equinoxorg/ekoHub/README.md

ekoHub
======

Main repository for all the energy kiosk observer (eko) related projects since 2012
