equinoxorg/ekoHub/eko-hardware-designs/README.md

Energy Kiosk Observer Hardware Schematics
=========================================

This project includes hardware schematics for the Energy Kiosk Observer datalogging system for e.quinox (www.e.quinox.org).

Cadsoft EAGLE is the tool of choice when designing PCBs, although some designs are being moved to RS DesignSpark.

Contents
--------

The following designs are included in this repository

* [AC Sensors](http://e.quinox.org/wiki/Datalogger:AC_Sensors): Isolated Power Sensing for 230VAC lines rated at 15A~.
* [Atmospheric](http://e.quinox.org/wiki/Datalogger:Atmospheric_Sensors): Light, Temperature and Humidity Sensing Package.
* [DC Sensor Solar](http://e.quinox.org/wiki/Datalogger:DC_Sensors): A 3x current, 1x voltage sensor package for power measurements on parallel connected solar panels.
* [DC Sensor](http://e.quinox.org/wiki/Datalogger:DC_Sensors): A 1x current, 1x voltage DC power sensor prototype rated at 30A~.
* [EKO Base](http://e.quinox.org/wiki/Datalogger:Mainboard): The Datalogger Mainboard with Network connectors and GPRS/3G modem.
* [Panelised]: Panelised designs for distribution to fabricator.
* [RS232_Barcode_Interface](http://e.quinox.org/wiki/Datalogger:Barcode_Scanner): An interface to a RS232 barcode scanner. Built for use with the SureElectronics PIC24F starter kit.
* [StorageBat_PSU](http://e.quinox.org/wiki/Datalogger:Battery_Sensors): A 1x voltage sensor for measurement of battery voltages.
* [Test_RS485](http://e.quinox.org/wiki/Datalogger:Test_Tools): A FTDI UM232 to RS485 adaptor utilising a SP483E line driver.
* [ekobbr2](http://e.quinox.org/wiki/Datalogger:Baseboard): PIC24F based sensor baseboard design.

Notes
-----

Currently the BoMs for these designs are not included in the repository. Order summaries are available on docs.ekohub.org or through the technical team wiki.
