equinoxorg/ekoHub/2012-2013/README.MD

Contents

Hardware: All circuit schematics and PCB designs, datasheets
Software: The MBED code and python code for the Google App Engine (GAE)
Documentation and Reports: Technical documents which help in the understanding of the system
