equinoxorg/ekoHub/eko-hardware-designs/network_boards/xbee-adapter/README.md

XBEE Breakout Board
===================

Holger Graef and Alex Stott

Breakout board for XBee Pro to EKO hardware. Includes association LED.
