equinoxorg/ekoHub/2012-2013/Hardware/PCB/DS3231 breakout/Board Layout.png

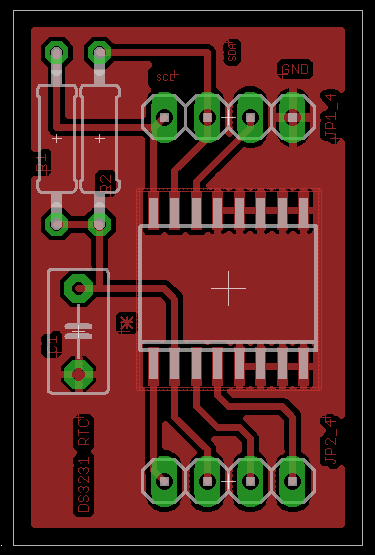
2012-2013/Hardware/PCB/DS3231 breakout/Board Layout.png
