equinoxorg/ekoHub/2013-2014/Documents/Inventory.xlsx

Date Modified: 27/4/2014
Component | Qty
Vodafone K3770 Modem | 2
CR2032 Panasonic Battery | 1
Tact Momentary Switch | 13
USB A Socket | 3
SD Card Socket | 2
AD7993 | 2
ACS712 | 2
SD Cards 2GB | 2
PCB Headers | 200
RED LED 5MM | 3
GREEN LED 5MM | 1
SD103 DIODES | 7
NMOS BS170 | 2
PMOS IRFU9024NPBF | 1
IL300 | 2
MCP604 | 2
MCP601 | 18
2way MOLEX Socket Crimps | 85
4way MOLEX Socket Crimps | 20
MYRAA Transformer | 1
MOLEX 2way Socket | 9
MOLEX 2way Crimp Housing | 12
MOLEX 4 way Socket | 9
MOLEX 4 way Crimp Housing | 10
