equinoxorg/ekoHub/2013-2014/Hardware/Component Values.xlsx

Sheet: AC Voltage
Component | Value | Notes | Component | Quantity | Unit Price | Total
R1 | 56K | Pot.Divider at input (series) | Transformer | 1 | £2.83 | £2.83
R2 | 10K | Pot.Divider at input (shunt) | MCP601 OpAmp | 3 | £0.35 | £1.05 | Cost per Sensor | 3.88
R3 | 5.1K | Pot. Divider for biasing (series) | SD103 | 2 | £0.00 | £0.00 | Number of Sensors | 1
R4 | 5.1K | Pot. Divider for biasing (shunt) |  |  | £0.00 | £0.00 | Total Cost | 3.88
R5 | 20k |  |  |  | £0.00 | £0.00
R6 | 5.1K |  |  |  | £0.00 | £0.00
R7 | 100k | Part of LPF |  |  | £0.00 | £0.00
R8 | 500 | Current Limiting Resistor |  |  | £0.00 | £0.00
C1 | 100μ | Electrolytic |  |  | £0.00 | £0.00
C2 | 22nF | Ceramic (Part of LPF) |  |  | £0.00 | £0.00
 |  |  |  |  | £0.00 | £0.00
 | 100nF | All other capacitors are decoupling capacitors |  |  | £0.00 | £0.00
 |  |  |  |  | £0.00 | £0.00

Sheet: DC Voltage
Component | Value | Notes | Component | Quantity | Unit Price | Total
 |  |  |  |  |  |  | Cost per Sensor | 0
 |  |  |  |  |  |  | Number of Sensors | 1
 |  |  |  |  |  |  | Total Cost | 0

Sheet: Current
Component | Value | Notes | Component | Quantity | Unit Price | Total
R1 | 1k |  | ACS712 | 1
R2 | 1k |  | MCP601 | 2 |  |  | Cost per Sensor | 0
R3 | 1k |  |  |  |  |  | Number of Sensors | 1
R4 | 1.5k |  |  |  |  |  | Total Cost | 0
R5 | 2k
R6 | 1k
C1 | 1n
C2 | 100n

Sheet: Main Board
Component | Value | Notes | Component | Quantity | Unit Price | Total
 |  |  |  |  |  |  | Cost per Sensor | 0
 |  |  |  |  |  |  | Number of Sensors | 1
 |  |  |  |  |  |  | Total Cost | 0
