equinoxorg/ekoHub/2013-2014/Documents/Datalogging Finances.xlsx

Sheet: Sheet1
Date | Company | Order Code | Description | Unit Price | Quantity | Total Cost
2013-10-30 | Farnell | 1761179 | MBED LCP1768 | £41.38 | 2 | £82.76
2013-10-30 | Farnell | 1852038 | OPAMP MCP601 | £0.35 | 15 | £5.25
2013-10-30 | Farnell | 1329624RL | ACS712 - 20A | £3.23 | 3 | £9.69
2013-10-30 | Farnell | 1098454 | 40Way PCB Breakaway Header 2.54mm Pitch | £1.78 | 2 | £3.56
2013-10-30 | Farnell | 1078309 | ADC - AD7993 Part 0 | £4.07 | 3 | £12.21
2013-11-01 | Farnell | 1298246 | CR2032 Panasonic Battery | £1.10 | 3 | £3.30
2013-11-01 | Farnell | 2310212 | USB A Socket | £1.20 | 3 | £3.60
2013-11-01 | Farnell | 2293708 | SD Card Socket | £1.58 | 3 | £4.74
2013-11-01 | Farnell | 1204967 | TRACO Isolated Switching Regulator | £11.75 | 1 | £11.75
2013-11-01 | Farnell | 8650101 | PMOS IRFU924NPBF | £0.58 | 3 | £1.74
2013-11-01 | Farnell | 1017687 | NMOS BS170 | £0.23 | 3 | £0.69
2013-11-01 | Farnell | 1612341 | SD103 Schotky Diode | £0.08 | 5 | £0.42
2013-11-01 | Farnell | 1689047 | MYRAA 240:6V Transformer | £2.83 | 2 | £5.66
2013-11-12 | MIKE HARBOUR | PCB Manufacture | Main Board Prototyping (Estimated Price) | £3.33 | 3 | £9.99
2013-11-21 | Farnell | 1671498 | LCD PC1602ARU | £4.75 | 1 | £4.75
2013-11-21 | RS | 758-1979 | Tact Momentary Switch | £0.20 | 10 | £2.00
2013-11-25 | RS | 720-0207 | LCD FDCC1602G (No Backlight) | £4.06 | 1 | £4.06
2013-12-07 | Farnell | 1098454 | 40Way PCB Breakaway Header 2.54mm Pitch | £1.88 | 4 | £7.52
2013-12-07 | Farnell | 1469485 | IL300 Optocoupler | £3.37 | 2 | £6.74
2013-12-07 | Farnell | 8549702 | HCNR200 OptoCoupler | £2.85 | 2 | £5.70
2013-12-07 | Farnell | 2342641 | LCD MIDAS MC21605H6W (with Backlight) | £6.46 | 1 | £6.46
2013-12-07 | Farnell | 1007511 | TRACO Isolated DC-DC Converter (1:1) 5V OUT | £2.95 | 2 | £5.90
2014-01-21 | Farnell | 1470848 | 4-input OR Gate | £0.34 | 2 | £0.68
2014-01-21 | Farnell | 1859046 | XP POWER DC-DC Converter 1:1 5V OUT | £3.15 | 1 | £3.15
2014-01-21 | Farnell | 1648675 | Texas Instruments LM311 Comparator | £0.31 | 2 | £0.62
2014-01-21 | Farnell | 9758658 | MCP602 DUAL OPAMP | £0.55 | 4 | £2.20
2014-01-30 | Farnell | 9589899 | 555 Timer | £0.17 | 2 | £0.34
2014-02-03 | RS | 228-5039 | RED LED 5mm 5mA | £0.11 | 5 | £0.57
2014-02-03 | RS | 247-1678 | Green LED 5mm 25mA | £0.08 | 5 | £0.40
2014-02-03 | Farnell | 8650101 | PMOS IRFU924NPBF | £0.61 | 2 | £1.22
2014-02-03 | Farnell | 1017687 | NMOS BS170 | £0.23 | 2 | £0.47
2014-02-03 | Farnell | 2310212 | USB A Socket | £1.22 | 3 | £3.66
2014-02-03 | Farnell | 2293708 | SD Card Socket | £1.69 | 3 | £5.07
2014-02-03 | Farnell | 2313553 | MOLEX Crimp (4Way) | £0.09 | 20 | £1.72
2014-02-03 | Farnell | 143128 | MOLEX Crimp Housing (4Way) | £0.23 | 10 | £2.35
2014-02-03 | Farnell | 9731164 | MOLEX Header | £0.42 | 10 | £4.20
2014-02-03 | Farnell | 1012166 | MOLEX Right Angle Dual Row Header | £0.42 | 3 | £1.26
2014-02-03 | Farnell | 151866 | MOLEX 2Way Crimp Housing | £0.17 | 3 | £0.51
2014-02-03 | Farnell | 9732195 | MOLEX Crimp (2Way Soclet) PK of 100 | £10.91 | 1 | £10.91
2014-02-24 | RS | 436-5058 | Light Steel Butt Hinge, 75x49x1.4mm | £0.58 | 2 | £1.17
2014-03-01 | Farnell | 1218870 | 20 Way SIP Sockets | £1.05 | 4 | £4.20
2014-03-05 | Farnell | 1852038 | OPAMP MCP601 | £0.35 | 10 | £3.50
2014-03-05 | Farnell | 1329624RL | ACS712 - 20A | £3.23 | 3 | £9.69
2014-03-05 | Farnell | 1469485 | IL300 Optocoupler | £3.37 | 2 | £6.74
2014-03-05 | Farnell | 1612341 | SD103 Schotky Diode | £0.08 | 4 | £0.34
2014-03-05 | Farnell | 1078309 | ADC - AD7993 Part 0 | £4.07 | 2 | £8.14
2014-03-05 | Farnell | 151866 | MOLEX 2Way Crimp Housing | £0.17 | 10 | £1.69
2014-03-05 | Farnell | 1012166 | MOLEX Right Angle Dual Row Header | £0.42 | 10 | £4.20
2014-05-08 | Farnell | 2342641 | LCD MIDAS MC21605H6W (with Backlight) | £6.46 | 1 | £6.46
2014-05-08 | Farnell | 8650101 | PMOS IRFU924NPBF | £0.61 | 10 | £6.10
2014-05-08 | Farnell | 1017687 | NMOS BS170 | £0.24 | 10 | £2.40
2014-05-08 | Farnell | 2310212 | USB A Socket | £1.22 | 2 | £2.44
2014-05-08 | Farnell | 2293708 | SD Card Socket | £1.69 | 2 | £3.38
2014-05-08 | Farnell | 9589899 | 555 Timer | £0.17 | 3 | £0.51
2014-05-08 | Farnell | 247-1678 | Green LED 5mm 25mA | £0.08 | 20 | £1.60
2014-05-12 | Farnell | 1189053 | PRO POWER - PV516A GROMMET PK 100 - GROMMET, BLANK, 31.8MM, PK100 | £10.58 | 1 | £10.58
2014-05-12 | Farnell | 9561536 | MULTICOMP - KTSC-22R - CAP, ROUND, RED | £0.05 | 10 | £0.50
2014-05-12 | Farnell | 9561552 | MULTICOMP - KTSC-22K - CAP, ROUND, BLACK, 13MM | £0.05 | 10 | £0.51
2014-05-12 | Farnell | 1420790 | DURATOOL - M4- HFA2-S100- - FULL NUT, STAINLESS STEEL, A2, M4 | £3.37 | 1 | £3.37
2014-05-12 | Farnell | 1466812 | ETTINGER - 05.03.143 - SPACER, M3X14-NI | £0.25 | 25 | £6.25
2014-05-12 | Farnell | 1045505 | VISHAY - TLLG4401 - LED, 3MM, GREEN, 2MCD, 565NM | £0.10 | 10 | £0.99
2014-05-12 | Farnell | 1045504 | VISHAY - TLLR4401 - LED, 3MM, HE-RED | £0.14 | 5 | £0.69
2014-05-12 | Farnell | 9555242 | MULTICOMP - LED3-4 - LED HOLDER, ROUND, 3MM, 2 PIN | 0.072 | 25 | £1.80
2014-05-12 | Farnell | 9354522 | BOURNS - 3386F-1-101LF - TRIMMER, 100R | £0.98 | 3 | £2.94
2014-05-12 | Farnell | 4218176 | TE CONNECTIVITY / AMP - 0-0881545-2 - JUMPER, WITH HANDLE, 2.54MM, 2WAY | £0.14 | 10 | £1.39
2014-05-12 | Farnell | 152346 | PRO POWER - PVC TAPE 1920B - TAPE, BLACK, 19MMX20M | £1.12 | 2 | £2.24
2014-05-12 | Farnell | 1593469 | MULTICOMP - 2212S-20SG-85 - SOCKET, PCB, 1 ROW, 20WAY | £1.23 | 5 | £6.15
2014-05-24 | Farnell | 1101346 | TE CONNECTIVITY / AMP - 1-390261-3 - SOCKET IC, DIL, 0.3", 14WAY | £0.13 | 10 | £1.26
2014-05-24 | Farnell | 1078309 | ANALOG DEVICES - AD7993BRUZ-0 - 10BIT ADC, 4CH I2C I/F, SMD, 7993 | 4.07 | 2 | £8.14
2014-05-24 | Farnell | 1329624RL | ALLEGRO MICROSYSTEMS - ACS712ELCTR-20A-T - SENSOR, CURRENT, 20A, SOIC8 | 3.23 | 3 | £9.69
2014-05-24 | Farnell | 1689047 | MYRRA - 44085 - TRANSFORMER, 6V, 1.5VA | 2.83 | 2 | £5.66
2014-05-24 | Farnell | 9758712 | MICROCHIP - MCP604-I/P - OP AMP, QUAD CMOS RRO/P, DIP14, 604 | 0.94 | 3 | £2.82
2014-05-24 | Farnell | 2356187 | WURTH ELEKTRONIK - 61301611021 - HEADER, 2.54MM, PIN, THT, R/A, 16WAY | 0.94 | 3 | £2.82
 | Amazon |  | Startech 6 inch USB A Female to USB Motherboard 4-Pin Header F/F USB 2.0 Cable | £2.44 | 5 | £12.20
 | eBay |  | Vodafone K3770 Mobile Broadband USB Stick / Dongle (White) - Huawei Technologies | £9.99 | 4 | £39.96
 |  |  |  |  |  | £0.00
 |  |  |  |  |  | £0.00
 |  |  |  |  |  | £0.00
 |  |  |  |  |  | £0.00
 |  |  |  |  |  | £0.00
 |  |  |  |  |  | £0.00
 |  |  |  |  |  | £0.00
 |  |  |  |  |  | £0.00
 |  |  |  |  |  | £0.00
 |  |  |  |  |  | £0.00
 |  |  |  |  |  | £0.00
 |  |  |  |  |  | £0.00
 |  |  |  |  |  | £0.00
 |  |  |  |  |  | £0.00
 |  |  |  |  |  | £0.00
 |  |  |  |  |  | £0.00
 |  |  |  |  |  | £0.00
 |  |  |  |  |  | £0.00
 |  |  |  |  |  | £0.00
 |  |  |  |  |  | £0.00
 |  |  |  |  |  | £0.00
 |  |  |  |  |  | £0.00
 |  |  |  |  |  | £0.00
 |  |  |  |  |  | £0.00
 |  |  |  |  |  | £0.00
 |  |  |  |  |  | £0.00
 |  |  |  |  |  | £0.00
 |  |  |  |  |  | £0.00
 |  |  |  |  |  | £0.00
 |  |  |  |  |  | £0.00
 |  |  |  |  |  | £0.00
 |  |  |  |  |  | £0.00
 |  |  |  |  |  | £0.00
 |  |  |  |  |  | £0.00
 |  |  |  |  |  | £0.00
 |  |  |  |  |  | £0.00
 |  |  |  |  |  | £0.00
 |  |  |  |  |  | £0.00
 |  |  |  |  |  | £0.00
 |  |  |  |  |  | £0.00
 |  |  |  |  |  | £0.00
 |  |  |  |  |  | £0.00
 |  |  |  |  |  | £0.00
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
 |  |  |  |  |  | £0.00
 |  |  |  |  |  | £0.00
 |  |  |  |  |  | £0.00
 |  |  |  |  |  | £0.00
 |  |  |  |  |  | £0.00
 |  |  |  |  |  | £0.00
 |  |  |  |  |  | £0.00
 |  |  |  |  |  | £0.00
 |  |  |  |  |  | £0.00
 |  |  |  |  |  | £0.00
 |  |  |  |  |  | £0.00
 |  |  |  |  |  | £0.00

Sheet: Sheet2
Module | Component Description | Quantity | Cost (Farnell)
Main | SDCard Socket | 1 | 1.69 | Main Board Toal Cost | 92.159
 | SD Card (2GB) | 1 | 5 | DC Voltage Board Total Cost | 23.234
 | LCD Screen | 1 | 6.46 | DC Current Total Cost | 19.724
 | Tact Switch | 4 | 0.8 | AC Board Toal Cost | 13.844
 | Green LED | 3 | 0.4 | Box | 22
 | Red LED | 1 | 0.11
 | Blue LED | 1 | 0.2
 | USB A Socket | 1 | 1.2
 | Molex Connector Battery Input Socket | 1 | £0.42
 | Molex Connector Battery Input Crimp Housing | 1 | £0.17
 | Molex Connector Battery Input Crimp | 2 | £0.40
 | Molex 4 way Socket | 8 | £0.42
 | Molex 4 way Crimp Housing | 8 | £3.36
 | Molex 4 way Crimp | 32 | £2.88
 | TRACO 5V | 1 | 11.75
 | N-Channel MOSFET | 4 | 0.98
 | P-Channel MOSFET | 4 | 2.44
 | Backup Coin Battery | 1 | 1.1
 | 555 Timer | 1 | 0.17
 | MBED LPC1768 | 1 | 42.21
 | Female Single Row 2.54mm 20way PCB Socket | 2
 | Jumper | 1
 | 2.54mm PCB header, 2 way | 1
 | USB Modem | 1 | 10
DC Voltage | IL300 | 4 | 13.48
 | TRACO 1:1, POWER SUPPLY | 1 | 2.95
 | MCP604 | 2 | 2.12
 | Molex 4 way Socket | 1 | £0.42
 | Molex 4 way Crimp Housing | 1 | £0.17
 | Molex 4 way Crimp | 4 | £0.40
 | Molex Connector Battery Input Socket | 1 | £0.42
 | Molex Connector Battery Input Crimp Housing | 1 | £0.23
 | Molex Connector Battery Input Crimp | 2 | £0.18
 | ADC | 1 | 2.86
DC Current | ACS712 | 4 | 12.92
 | MCP604 | 2 | 2.12
 | Molex 4 way Socket | 1 | £0.42
 | Molex 4 way Crimp Housing | 1 | £0.17
 | Molex 4 way Crimp | 4 | £0.40
 | Molex Connector Battery Input Socket | 1 | £0.42
 | Molex Connector Battery Input Crimp Housing | 1 | £0.23
 | Molex Connector Battery Input Crimp | 2 | £0.18
 | ADC | 1 | 2.86
ACBoard | ACS712
 | Transformer | 2 | 5.66
 | MCP604 | 3 | 3.18
 | Diode | 4 | 0.32
 | Molex 4 way Socket | 1 | £0.42
 | Molex 4 way Crimp Housing | 1 | £0.17
 | Molex 4 way Crimp | 4 | £0.40
 | Molex Connector Battery Input Socket | 1 | £0.42
 | Molex Connector Battery Input Crimp Housing | 1 | £0.23
 | Molex Connector Battery Input Crimp | 2 | £0.18
 | ADC | 1 | 2.86
Box | Box | 1 | 15
 | Hinges | 2 | 2
 | Grommets | 8 | 5
