equinoxorg/ekoHub/(list of files, cad)

Other CAD files:
2013-2014/Hardware/BoxDesign.skp
