equinoxorg/ekoHub/2012-2013/Hardware/Sensor Testing/Graphs.xlsx

Sheet: Current Sensor
Current | Voltage
0 | 1.6227
0.1 | 1.6293
0.2 | 1.6357
0.3 | 1.6415
0.4 | 1.6477
0.5 | 1.6541
0.6 | 1.6611
0.7 | 1.6682
0.8 | 1.675
0.9 | 1.6807
1 | 1.6884
1.1 | 1.6941
1.2 | 1.7004
1.3 | 1.7072
1.4 | 1.7134
1.5 | 1.7204
1.6 | 1.7268
1.7 | 1.7324
1.8 | 1.7383
1.9 | 1.7456
2 | 1.7528
3 | 1.8776
4 | 1.8924
5 | 1.9595
6 | 2.0259
7 | 2.0903
8 | 2.1539
9 | 2.2163
10 | 2.276

Sheet: DC Voltage
1 | 0.237 | 237
2 | 0.474 | 474
3 | 0.605 | 605
4 | 0.731 | 731
5 | 0.852 | 852
6 | 1.001
7 | 1.173
8 | 1.439
9 | 1.73
10 | 1.892
11 | 2.013
12 | 2.069
13 | 2.268

Sheet: AC Voltage
In | Out
0.069 | 0.08 | 80
0.5 | 0.069 | 69
1 | 0.122 | 122
1.5 | 0.178 | 178
2 | 0.231 | 231
2.5 | 0.294 | 294
3 | 0.35 | 350
3.5 | 0.409 | 409
4 | 0.481 | 481
4.5 | 0.525 | 525
5 | 0.594 | 594
6.19 | 0.713 | 713
