equinoxorg/ekoHub/2012-2013/Hardware/Sensor Testing/Sensor Testing.xlsx

Sheet: DC Voltage
Sensor 1 |  | Sensor 2 |  | Sensor 3 |  | Sensor 4
Vin | Decimal Out | Vin | Decimal Out | Vin | Decimal Out | Vin | Decimal Out
0.03 | 0 | 0.58 | 18 | 0.03 | 0 | 0.31 | 9
1 | 32 | 1 | 33 | 1 | 33 | 1.56 | 53
2 | 67 | 2 | 66 | 1.9 | 64 | 1.9 | 65
3 | 101 | 3 | 100 | 3.03 | 103 | 3.25 | 112
4.03 | 137 | 4.03 | 137 | 4.33 | 147 | 4.5 | 156
5.01 | 170 | 5.01 | 170 | 5.63 | 192 | 5.19 | 180
6.1 | 208 | 6 | 203 | 6.36 | 217 | 6.39 | 221
7.37 | 250 | 7.08 | 242 | 7.14 | 242 | 7.05 | 244
7.88 | 268 | 8.14 | 272 | 8.5 | 290 | 8.21 | 285
9.31 | 316 | 9.24 | 313 | 9.22 | 315 | 9.15 | 318
11.48 | 389 | 10.28 | 354 | 10.68 | 365 | 10.7 | 372
12.8 | 435 | 12 | 410 | 11.41 | 392 | 11.41 | 397
13.78 | 466 | 13.04 | 442 | 12.56 | 428 | 12.32 | 428
14.48 | 498 | 14.79 | 486 | 13.77 | 468 | 13.95 | 483
16.17 | 544 | 15.04 | 513 | 14.41 | 489 | 14.64 | 506
17.66 | 589 | 16.3 | 554 | 15.06 | 511 | 15.35 | 530
18.07 | 599 | 17.52 | 585 | 16.48 | 558 | 16.25 | 560
18.94 | 612 | 18.87 | 615 | 17.27 | 581 | 17.61 | 602
19.1 | 613 | 19.47 | 620 | 18.15 | 606 | 18.07 | 617
20 | 613 | 20.05 | 620 | 18.68 | 619 | 18.62 | 627
 |  |  |  | 19.21 | 624 | 19 | 631
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
