equinoxorg/ekoHub/2013-2014/Hardware/Sensor Testing Results/current sensor readings.xlsx

Sheet: Sheet1
I_IN | ACS217 OUT | Gain Opamp OUT | Buffer OUT
0 | 2.53 | 2.59
0.25 | 2.53 | 2.53
0.5 | 2.53 | 2.49
0.75 | 2.57 | 2.45
1 | 2.57 | 2.36
1.25 | 2.65 | 2.17
1.5 | 2.65 | 2.09
1.75 | 2.69 | 2.02
2 | 2.73 | 1.9
2.25 | 2.73 | 1.83
2.5 | 2.77 | 1.73
2.75 | 2.77 | 1.65
3 | 2.81 | 1.61
3.25 | 2.81 | 1.53
3.5 | 2.85 | 1.45
3.75 | 2.89 | 1.37
4 | 2.89 | 1.29
4.25 | 2.93 | 1.17
4.5 | 2.97 | 1.09
4.75 | 2.97 | 0.99
5 | 3.02 | 0.91
5.25 | 3.02 | 0.83
5.5 | 3.06 | 0.77
5.75 | 3.1 | 0.67
6 | 3.1 | 0.59

Sheet: Sheet2
I_IN | IC_OUT | G1_ OUT | G2_ OUT | Technical Specs | Vin+ | RIN | RF
-6 | 1.93 | 3.68 | 1.73 | G1 | 2.5 | 1K | 1.5k
-5.5 | 1.97 | 3.58 | 1.81 | G2 | 2.5 | 2K | 1k
-5 | 2.01 | 3.5 | 1.85
-4.5 | 2.07 | 3.38 | 1.93
-4 | 2.13 | 3.3 | 2.01
-3.5 | 2.17 | 3.18 | 2.05
-3 | 2.21 | 3.1 | 2.13
-2.5 | 2.25 | 3.02 | 2.19
-2 | 2.33 | 2.9 | 2.25
-1.5 | 2.37 | 2.81 | 2.33
-1 | 2.41 | 2.73 | 2.37
-0.5 | 2.46 | 2.63 | 2.43
0 | 2.55 | 2.56 | 2.53
0.5 | 2.55 | 2.42 | 2.57
1 | 2.61 | 2.32 | 2.63
1.5 | 2.65 | 2.22 | 2.69
2 | 2.7 | 2.12 | 2.77
2.5 | 2.75 | 2.02 | 2.83
3 | 2.81 | 1.92 | 2.89
3.5 | 2.85 | 1.82 | 2.97
4 | 2.89 | 1.72 | 3.03
4.5 | 2.95 | 1.62 | 3.09
5 | 2.99 | 1.53 | 3.15
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
