equinoxorg/ekoHub/2012-2013/Hardware/PCB/Test Board (4 sensors)/test_sensors2/testv1.pdf

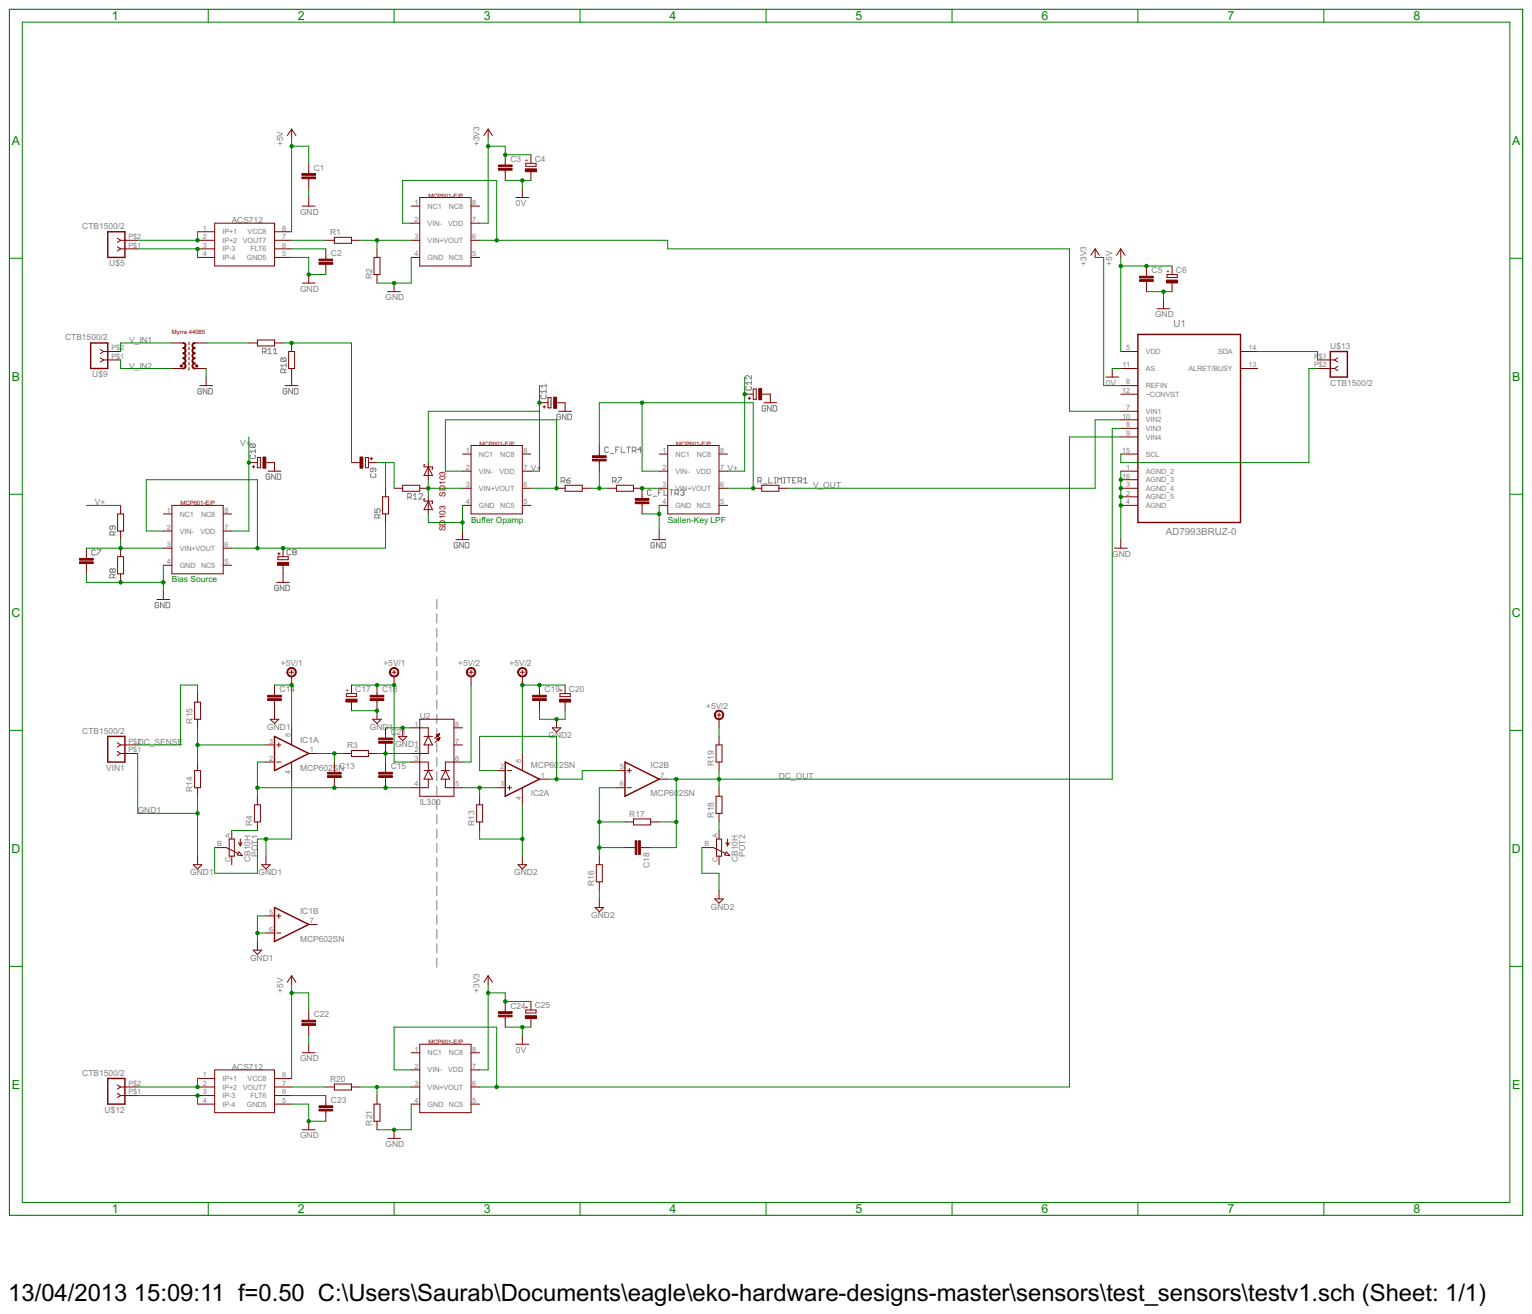
[picture p57: page 1]

13/04/2013 15:09:11 f=0.50 C:\Users\Saurab\Documents\eagle\eko-hardware-designs-master\sensors\test_sensors\testv1.sch (Sheet: 1/1)
