equinoxorg/ekoHub/2012-2013/Hardware/PCB/Test Board (4 sensors)/test_sensors/test_sensors/testv2.pdf

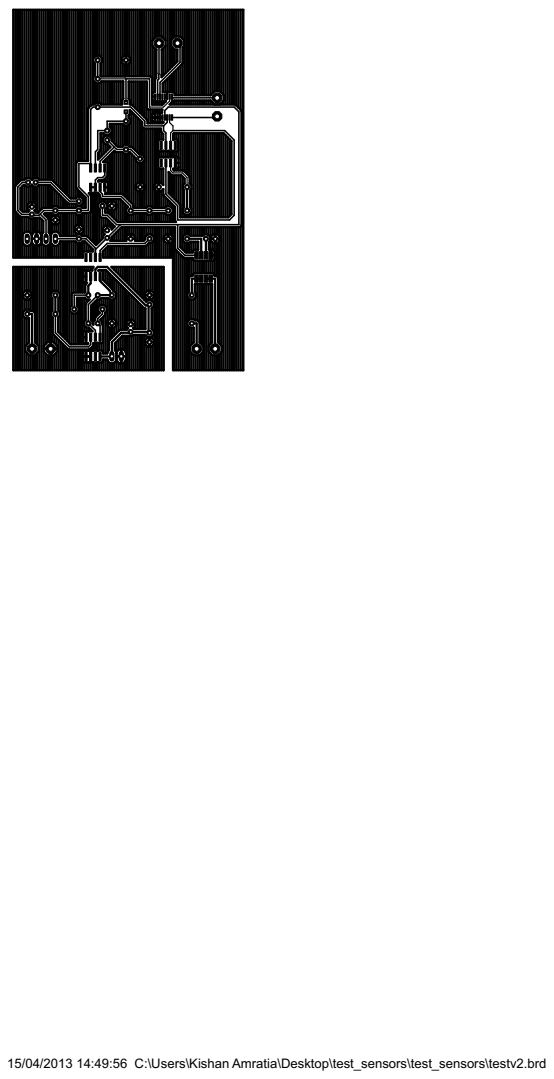
[picture p58: page 1]

15/04/2013 14:49:56 C:\Users\Kishan Amratia\Desktop\test_sensors\test_sensors\testv2.brd
