equinoxorg/ekoHub/2012-2013/Hardware/PCB/Test Board (4 sensors)/test_sensors/test_sensors/testv3 - mirror.pdf

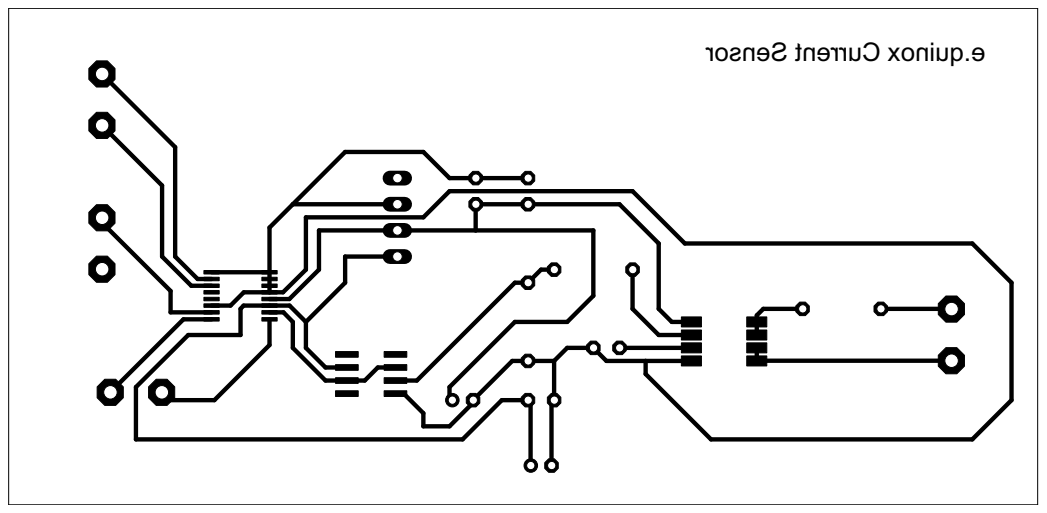
[picture p59: page 1]

r osneSt nerr uCxoni uq. e
