equinoxorg/ekoHub/(list of files, drawings)

Other design files:
eko-hardware-designs/mainboards/mainboard_bbxm/EKOBase.pcb
