equinoxorg/ekoHub/eko-hardware-designs/test/line_termination/lineterm.brd

## EAGLE design eko-hardware-designs/test/line_termination/lineterm.brd (2015-01-21)

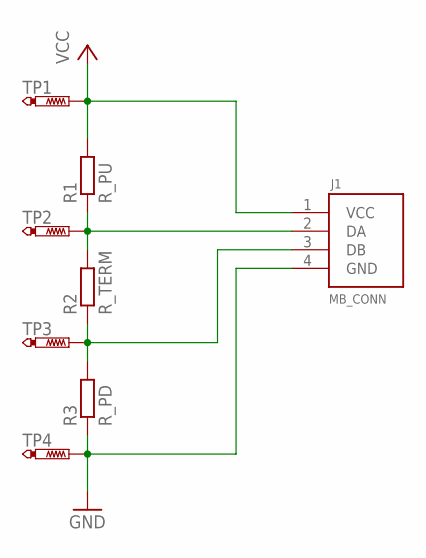
[picture p61: schematic lineterm.sch]

Parts:
J1: MB_CONN; PTSM0,5/4-HH-2,5-THR
R1: R_PU; 0207/12
R2: R_TERM; 0207/12
R3: R_PD; 0207/12
TP1, TP2, TP3, TP4: PTR1TP15R; TP15R

Connections:
GND: J1.4 (GND), R3.1, TP4.TP
unnamed: J1.3 (DB), R2.1, R3.2, TP3.TP
unnamed: J1.2 (DA), R1.1, R2.2, TP2.TP
VCC: J1.1 (VCC), R1.2, TP1.TP

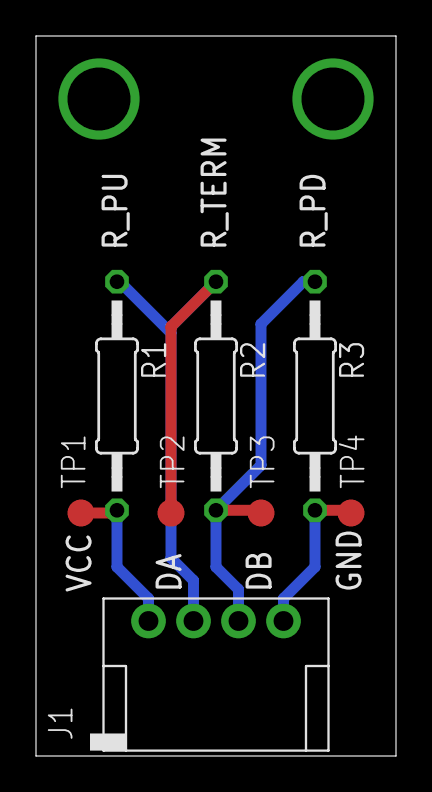
[picture p62: board lineterm.brd from above]

Board: 2 copper layers, 20.0 x 40.0 mm, 8 parts (0 on the bottom side), 4 nets.
