equinoxorg/ekoHub/eko-hardware-designs/sensors/dc_sensor_v2/dc_sensor_v2.brd

## EAGLE design eko-hardware-designs/sensors/dc_sensor_v2/dc_sensor_v2.brd (2015-01-21)

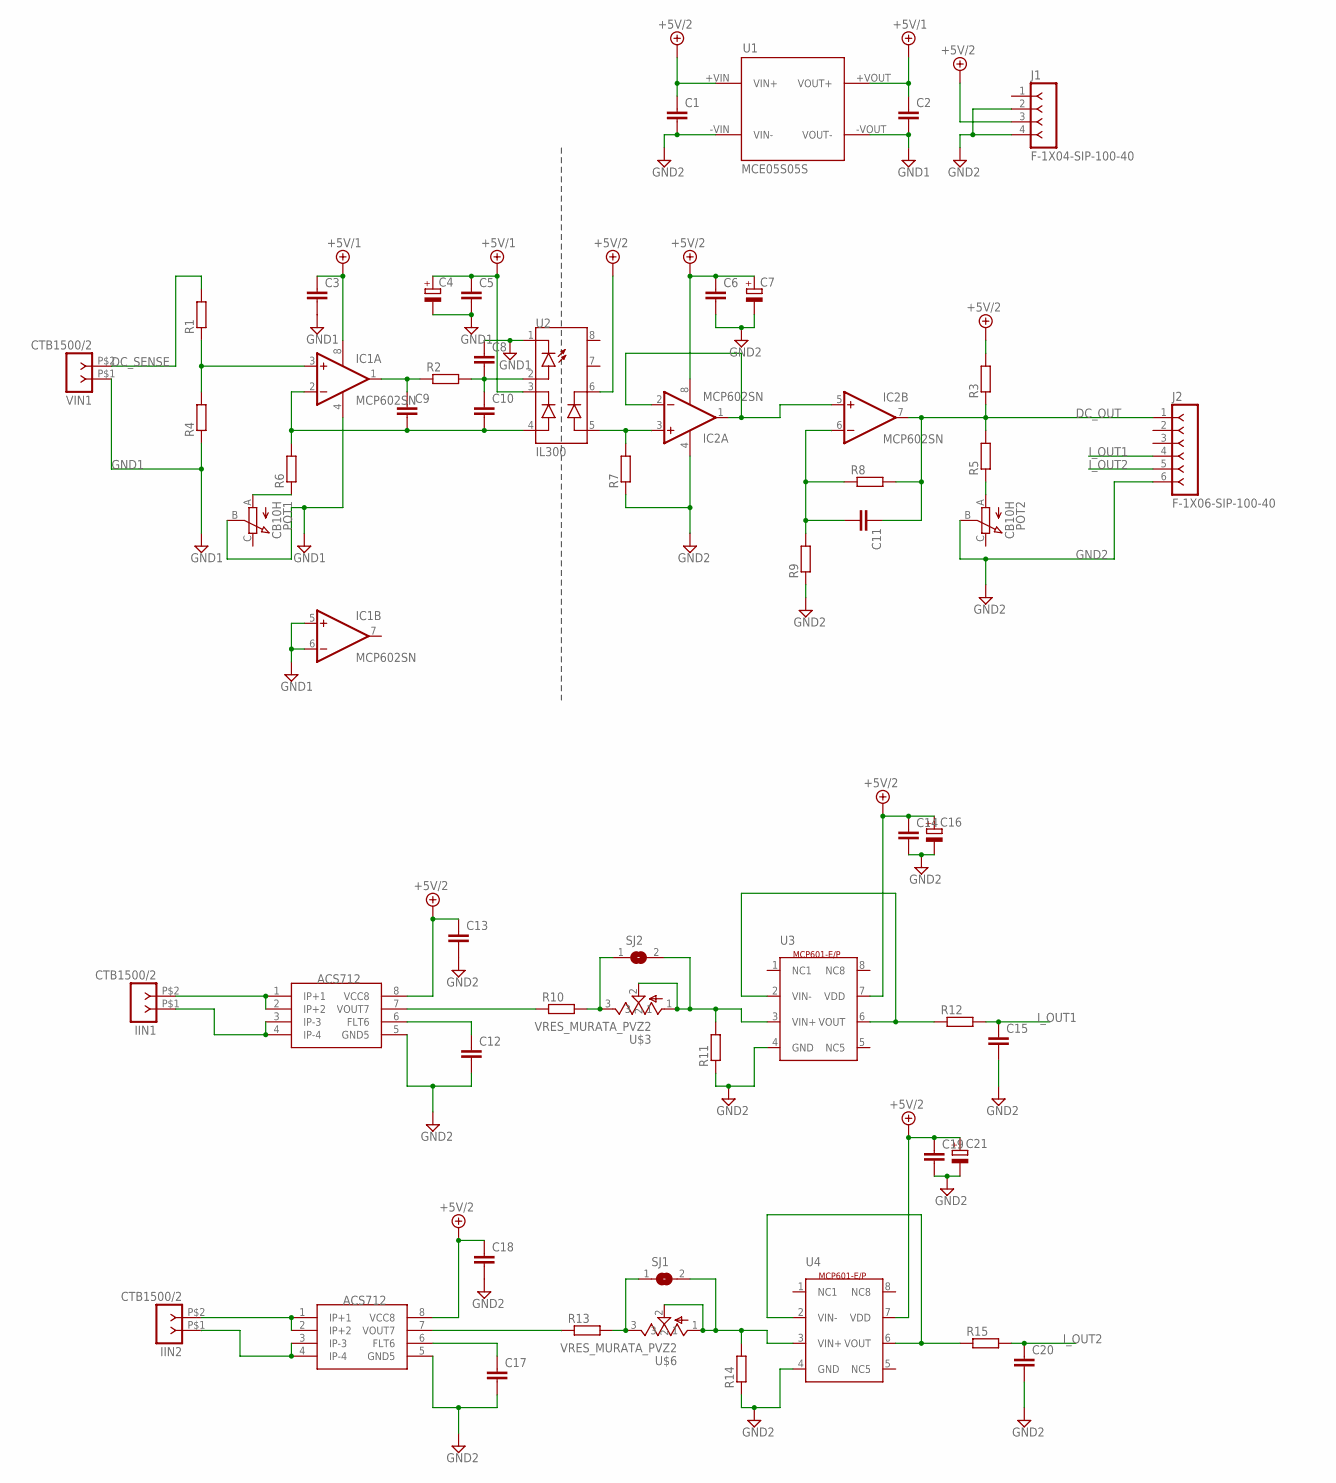
[picture p63: schematic dc_sensor_v2.sch]

Parts:
C1, C2: C-EUC1206; C1206
C3, C5, C6, C8, C9, C10, C11: C-EU025-040X050; C025-040X050
C4, C7: CPOL-EUE2-5; E2-5
C12, C15, C17, C20: C-EU025-030X050; C025-030X050
C13, C14, C18, C19: C-EUC0603; C0603
C16, C21: CPOL-EUE2.5-6; E2,5-6
IC1, IC2: MCP602SN; SO08
IIN1, IIN2: CTB1500/2; CTB1500-2
J1: F-1X04-SIP-100-40; SIP-100-04-40
J2: F-1X06-SIP-100-40; SIP-100-06-40
POT1, POT2: CB10H; CB10V
R1, R2, R3, R4, R5, R6, R7, R8, R9, R10, R11, R12, R13, R14, R15: R-EU_0207/10; 0207/10
SJ1, SJ2: SJ
U1: MCE05S05S; MCEXXSXXS_SIP
U2: IL300; DIL08
U3, U4: MCP601; SO8
U5, U6: ACS712; SO8
U$3, U$6: VRES_MURATA_PVZ2; MURATA_PVZ2A
VIN1: CTB1500/2; CTB1500-2

Connections:
+5V/1: C2.1, C3.1, C4.+, C5.1, IC1.8 (V+), U1.+VOUT (VOUT+), U2.3 (C_FB)
+5V/2: C1.1, C6.1, C7.+, C13.1, C14.1, C16.+, C18.1, C19.1, C21.+, IC2.8 (V+), J1.3, R3.2, U1.+VIN (VIN+), U2.6 (C_OUT), U3.7 (VDD), U4.7 (VDD), U5.8 (VCC8), U6.8 (VCC8)
DC_OUT: C11.1, IC2.7 (OUT), J2.1, R3.1, R5.2, R8.2
DC_SENSE: R1.2, VIN1.P$2 (2)
GND1: C2.2, C3.2, C4.-, C5.2, C8.1, IC1.4 (V-), IC1.5 (+IN), IC1.6 (-IN), POT1.B (S), R4.1, U1.-VOUT (VOUT-), U2.1 (C_LED), VIN1.P$1 (1)
GND2: C1.2, C6.2, C7.-, C12.2, C13.2, C14.2, C15.2, C16.-, C17.2, C18.2, C19.2, C20.2, C21.-, IC2.4 (V-), J1.2, J1.4, J2.6, POT2.B (S), R7.1, R9.1, R11.1, R14.1, U1.-VIN (VIN-), U3.4 (GND), U4.4 (GND), U5.5 (GND5), U6.5 (GND5)
I_OUT1: C15.1, J2.4, R12.2
I_OUT2: C20.1, J2.5, R15.2
unnamed: C9.2, C10.2, IC1.2 (-IN), R6.2, U2.4 (A_FB)
unnamed: POT2.A, R5.1
unnamed: IC2.3 (+IN), R7.2, U2.5 (A_OUT)
unnamed: C8.2, C10.1, R2.2, U2.2 (A_LED)
unnamed: C9.1, IC1.1 (OUT), R2.1
unnamed: IC2.1 (OUT), IC2.2 (-IN), IC2.5 (+IN)
unnamed: POT1.A, R6.1
unnamed: IC1.3 (+IN), R1.1, R4.2
unnamed: IIN1.P$2 (2), U6.1 (IP+1), U6.2 (IP+2)
unnamed: C11.2, IC2.6 (-IN), R8.1, R9.2
unnamed: IIN1.P$1 (1), U6.3 (IP-3), U6.4 (IP-4)
unnamed: R10.2, SJ2.1, U$3.3
unnamed: C12.1, U6.6 (FLT6)
unnamed: R12.1, U3.2 (VIN-), U3.6 (VOUT)
unnamed: IIN2.P$2 (2), U5.1 (IP+1), U5.2 (IP+2)
unnamed: R10.1, U6.7 (VOUT7)
unnamed: R11.2, SJ2.2, U3.3 (VIN+), U$3.1, U$3.2
unnamed: IIN2.P$1 (1), U5.3 (IP-3), U5.4 (IP-4)
unnamed: C17.1, U5.6 (FLT6)
unnamed: R13.1, U5.7 (VOUT7)
unnamed: R14.2, SJ1.2, U4.3 (VIN+), U$6.1, U$6.2
unnamed: R13.2, SJ1.1, U$6.3
unnamed: R15.1, U4.2 (VIN-), U4.6 (VOUT)

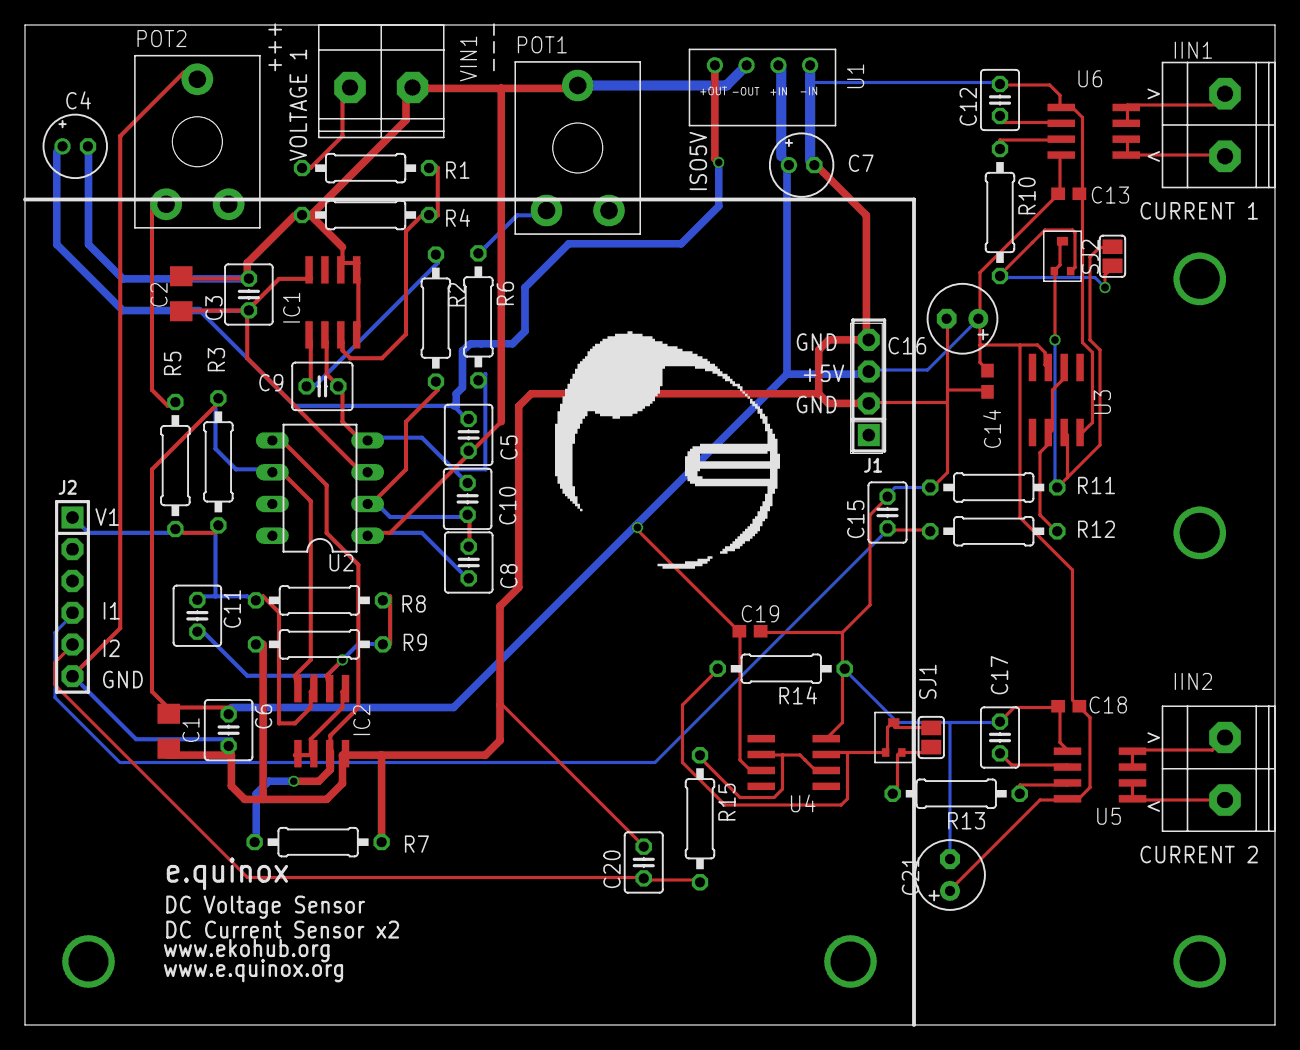
[picture p64: board dc_sensor_v2.brd from above]

Board: 2 copper layers, 100.0 x 80.0 mm, 56 parts (0 on the bottom side), 31 nets.

Other parts of the board:
U$1: EQNXLOGO
