equinoxorg/ekoHub/eko-hardware-designs/test/ftdi_modbus_v2/ftdi_modbus_v2.brd

## EAGLE design eko-hardware-designs/test/ftdi_modbus_v2/ftdi_modbus_v2.brd (2015-01-21)

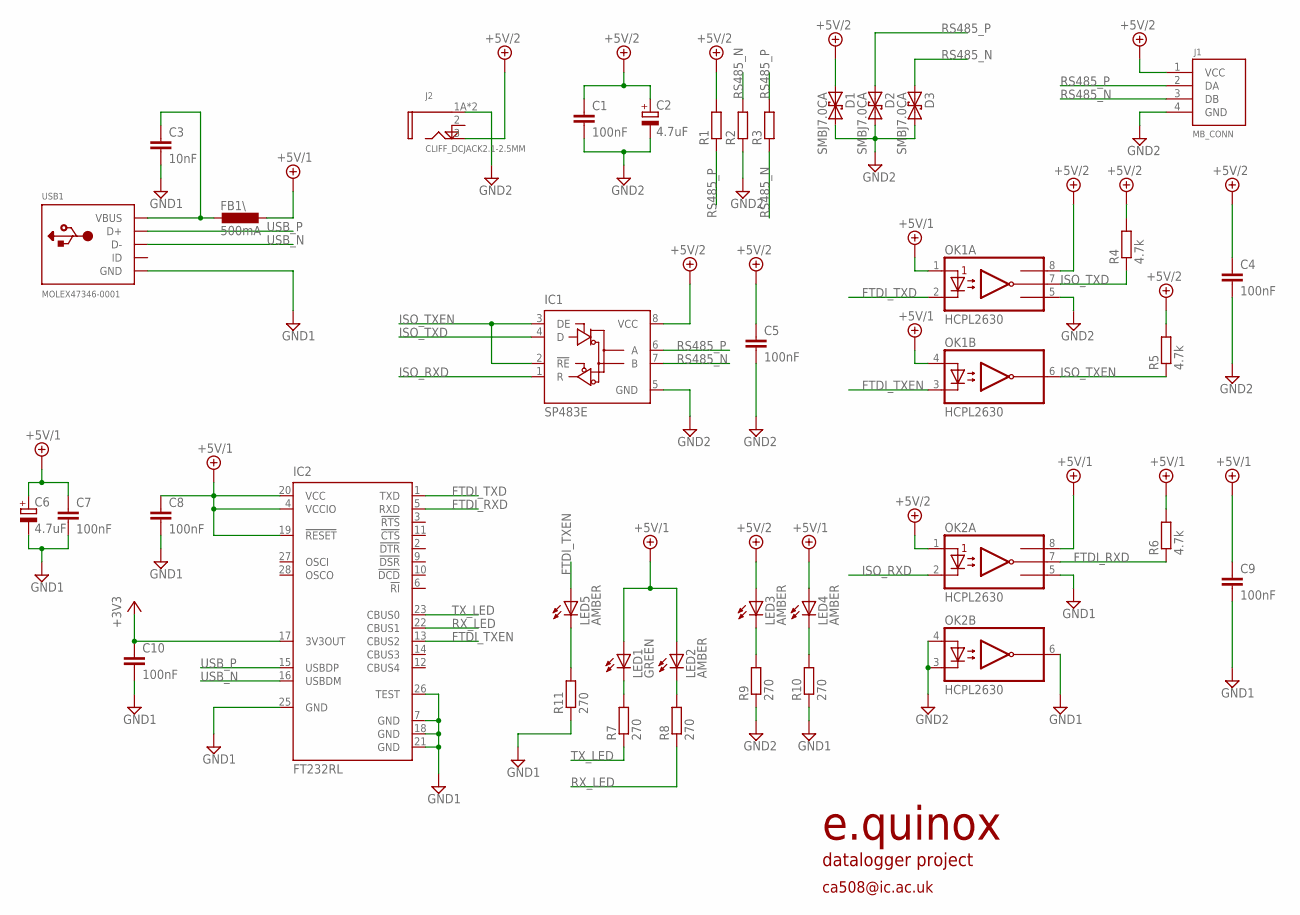
[picture p65: schematic ftdi_modbus_v2.sch]

Parts:
C1, C5, C7, C8, C10: 100nF; C0603
C2, C6: 4.7uF; B/3528-21R
C3: 10nF; C0603
C4, C9: 100nF; C1206
D1, D2, D3: SMBJ7.0CA; DO214AA
FB1\: 500mA; L3216C
IC1: SP483E; D_R-PDSO-G8
IC2: FT232RL; SSOP28
J1: MB_CONN; PTSM0,5/4-HH-2,5-THR
J2: CLIFF_DCJACK2.1-2.5MM; FC6814XS
LED1: GREEN; CHIPLED_0805
LED2, LED3, LED4, LED5: AMBER; CHIPLED_0805
OK1, OK2: HCPL2630; DIL08
R1, R2, R3: R-EU_0207/10; 0207/10
R4, R5, R6: 4.7k; M0805
R7, R8, R9, R10, R11: 270; M0805
USB1: MOLEX47346-0001; 47346-0001

Connections:
+3V3: C10.1, IC2.17 (3V3OUT)
+5V/1: C6.+, C7.1, C8.1, C9.1, FB1\.1, IC2.4 (VCCIO), IC2.19 (!RESET), IC2.20 (VCC), LED1.A, LED2.A, LED4.A, OK1.1 (A1), OK1.4 (A2), OK2.8 (VCC), R6.2
+5V/2: C1.1, C2.+, C4.1, C5.1, D1.P$1 (1), IC1.8 (VCC), J1.1 (VCC), J2.3 (TIP), LED3.A, OK1.8 (VCC), OK2.1 (A1), R1.2, R4.2, R5.2
FTDI_RXD: IC2.5 (RXD), OK2.7 (VO1), R6.1
FTDI_TXD: IC2.1 (TXD), OK1.2 (C1)
FTDI_TXEN: IC2.13 (CBUS2), LED5.A, OK1.3 (C2)
GND1: C3.2, C6.-, C7.2, C8.2, C9.2, C10.2, IC2.7 (GND), IC2.18 (GND), IC2.21 (GND), IC2.25 (GND), IC2.26 (TEST), OK2.5 (GND), OK2.6 (VO2), R10.1, R11.1, USB1.5 (GND)
GND2: C1.2, C2.-, C4.2, C5.2, D1.P$2 (2), D2.P$2 (2), D3.P$2 (2), IC1.5 (GND), J1.4 (GND), J2.1A (SLEEVE), J2.1B (SLEEVE), OK1.5 (GND), OK2.3 (C2), OK2.4 (A2), R2.1, R9.1
ISO_RXD: IC1.1 (R), OK2.2 (C1)
ISO_TXD: IC1.4 (D), OK1.7 (VO1), R4.1
ISO_TXEN: IC1.2 (!RE), IC1.3 (DE), OK1.6 (VO2), R5.1
unnamed: C3.1, FB1\.2, USB1.1 (VBUS)
unnamed: LED1.C, R7.2
unnamed: LED2.C, R8.2
unnamed: LED3.C, R9.2
unnamed: LED4.C, R10.2
unnamed: LED5.C, R11.2
RS485_N: D3.P$1 (1), IC1.7 (B), J1.3 (DB), R2.2, R3.1
RS485_P: D2.P$1 (1), IC1.6 (A), J1.2 (DA), R1.1, R3.2
RX_LED: IC2.22 (CBUS1), R8.1
SHUNT: J2.2 (SHUNT)
TX_LED: IC2.23 (CBUS0), R7.1
USB_N: IC2.16 (USBDM), USB1.2 (D-)
USB_P: IC2.15 (USBDP), USB1.3 (D+)

Notes on the sheet:
ca508@ic.ac.uk
e.quinox
datalogger project

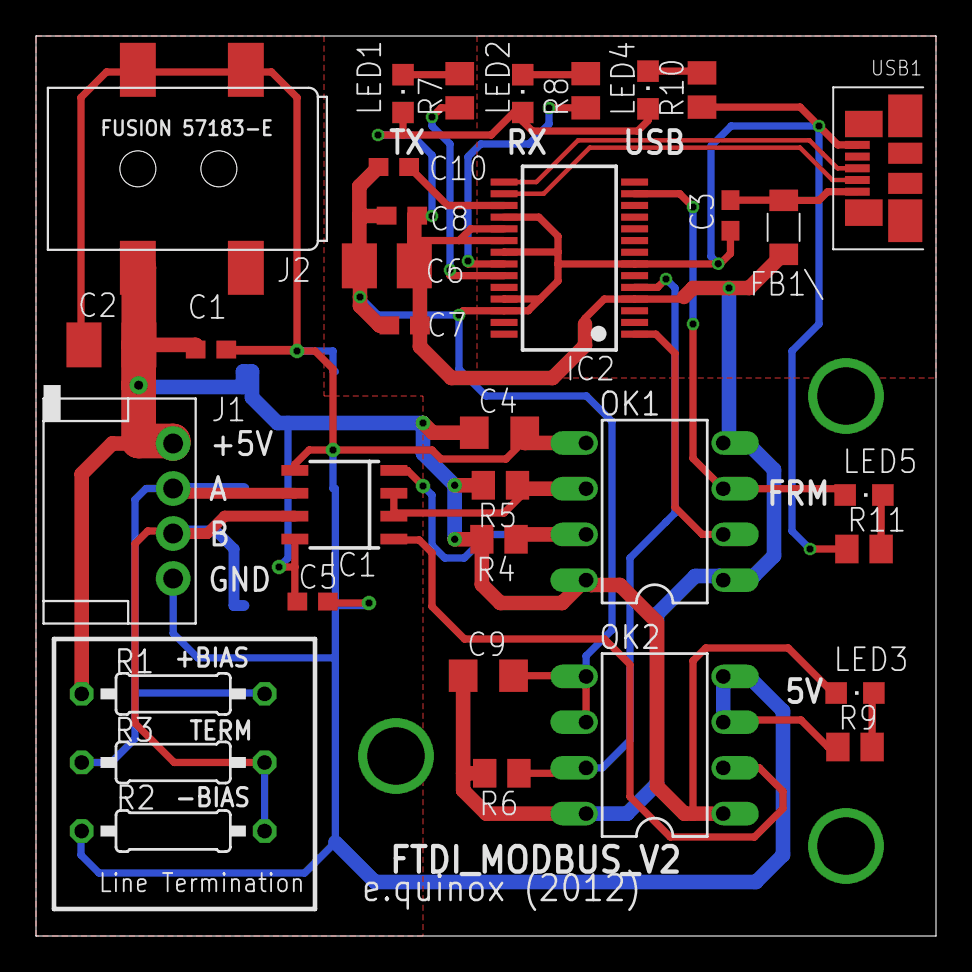
[picture p66: board ftdi_modbus_v2.brd from above]

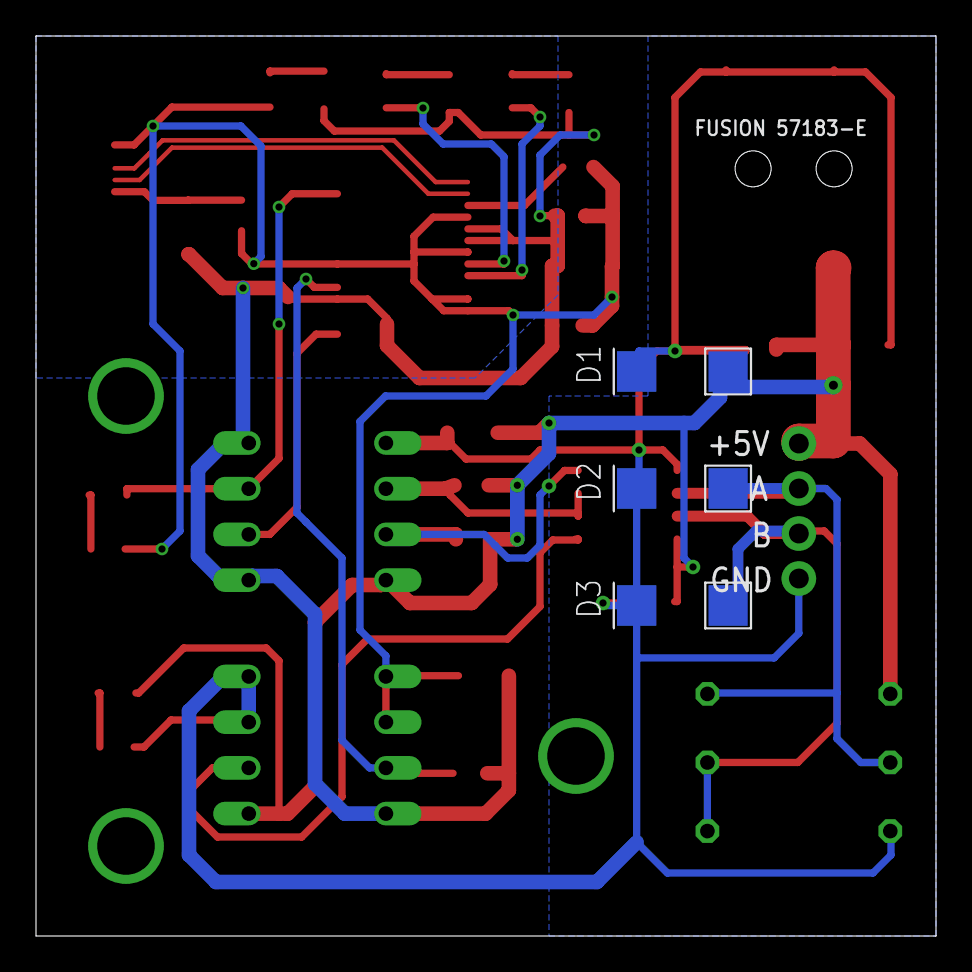
[picture p67: board ftdi_modbus_v2.brd from below]

Board: 2 copper layers, 50.0 x 50.0 mm, 37 parts (3 on the bottom side), 23 nets.
