equinoxorg/ekoHub/eko-hardware-designs/sensors/waterlevel/waterlevel.brd

## EAGLE design eko-hardware-designs/sensors/waterlevel/waterlevel.brd (2015-01-21)

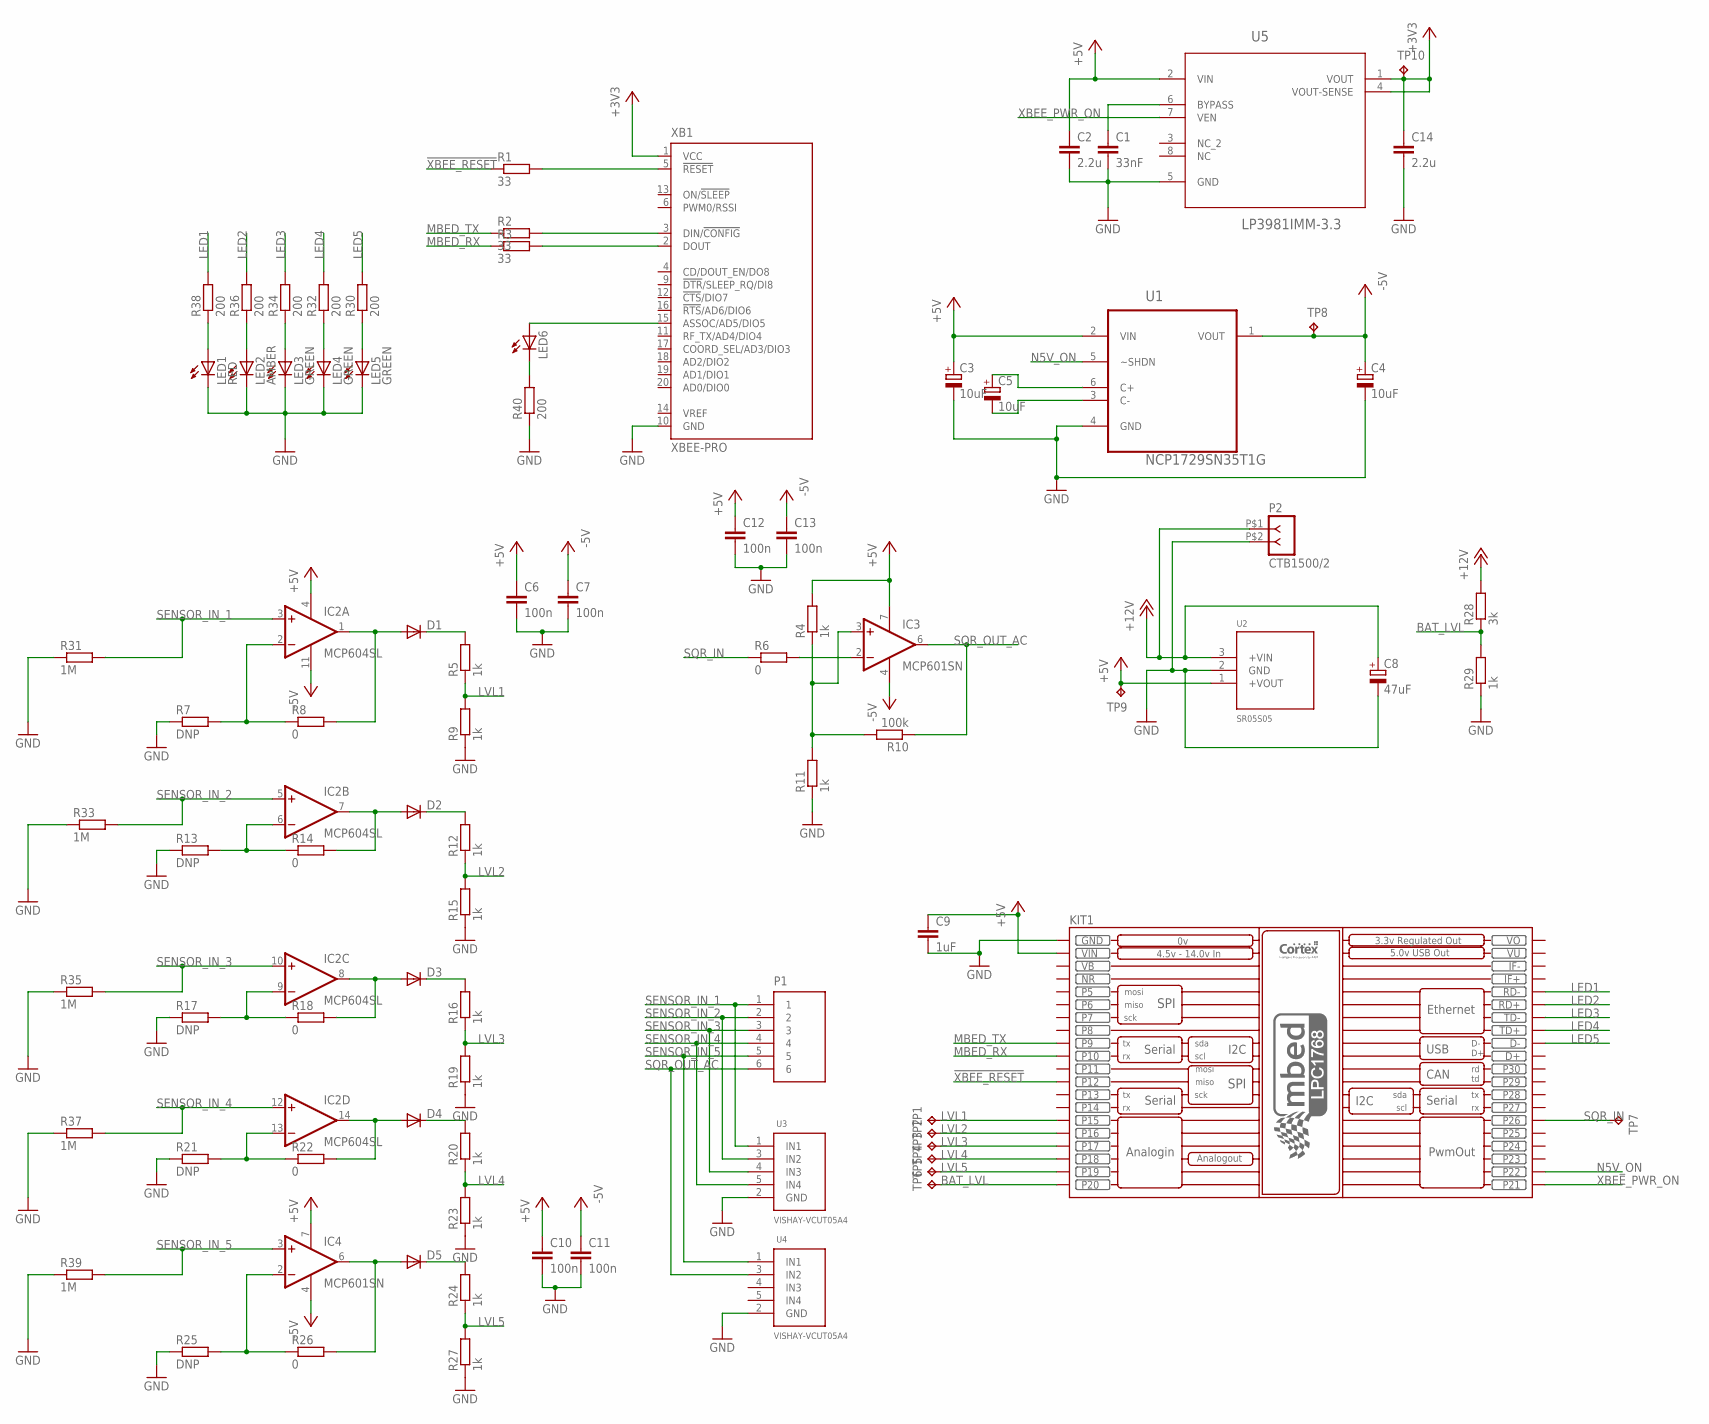
[picture p68: schematic waterlevel.sch]

Parts:
C1: 33nF; C0603
C2, C14: 2.2u; C0603; FARNELL 1759400
C3, C4, C5: 10uF; D/7343-31R; FARNELL 2112950
C6, C7, C10, C11, C12, C13: 100n; C1206
C8: 47uF; D/7343-31R; FARNELL 2112950
C9: 1uF; C1206
D1, D2, D3, D4, D5: DIODE-SOD323-R; SOD323-R; PART RB751V40; FARNELL 1907691
IC2: MCP604SL; SO14
IC3, IC4: MCP601SN; SO08
KIT1: MBED_NXP_LPC1768; MBED-KIT
LED1: RED; CHIPLED_0805
LED2: AMBER; CHIPLED_0805
LED3, LED4, LED5: GREEN; CHIPLED_0805
LED6: LEDCHIPLED_0805; CHIPLED_0805
P1: CAMDEN-CTB5000/6; CAMDEN-CTB5000
P2: CTB1500/2; CTB1500-2
R1, R2, R3: 33; R0603
R4, R5, R9, R11, R12, R15, R16, R19, R20, R23, R24, R27, R29: 1k; R0805
R6, R8, R14, R18, R22, R26: 0; R0603
R7, R13, R17, R21, R25: DNP; R0603
R10: 100k; R0805
R28: 3k; R0805
R30, R32, R34, R36, R38, R40: 200; R0603
R31, R33, R35, R37, R39: 1M; R0805
TP1, TP2, TP3, TP4, TP5, TP6, TP7, TP8, TP9, TP10: TPTP13R; TP13R
U1: NCP1729SN35T1G; SOP95P275X110-6N
U2: SR05S05; XP-SR-SERIES
U3, U4: VISHAY-VCUT05A4; SOT23-5
U5: LP3981IMM-3.3; SOP65P490X110-8N
XB1: XBEE-PRO

Connections:
!XBEE_RESET!: KIT1.P$12 (P12), R1.1
+3V3: C14.1, TP10.TP, U5.1 (VOUT), U5.4 (VOUT-SENSE), XB1.1 (VCC)
+5V: C2.1, C3.+, C6.1, C9.1, C10.1, C12.1, IC2.4 (V+), IC3.7 (V+), IC4.7 (V+), KIT1.VIN, R4.2, TP9.TP, U1.2 (VIN), U2.1 (+VOUT), U5.2 (VIN)
+12V: C8.+, P2.P$1 (1), R28.2, U2.3 (+VIN)
-5V: C4.+, C7.1, C11.1, C13.1, IC2.11 (V-), IC3.4 (V-), IC4.4 (V-), TP8.TP, U1.1 (VOUT)
BAT_LVL: KIT1.P$20 (P20), R28.1, R29.2, TP6.TP
GND: C1.2, C2.2, C3.-, C4.-, C6.2, C7.2, C8.-, C9.2, C10.2, C11.2, C12.2, C13.2, C14.2, KIT1.GND, LED1.C, LED2.C, LED3.C, LED4.C, LED5.C, P2.P$2 (2), R7.1, R9.1, R11.1, R13.1, R15.1, R17.1, R19.1, R21.1, R23.1, R25.1, R27.1, R29.1, R31.1, R33.1, R35.1, R37.1, R39.1, R40.1, U1.4 (GND), U2.2 (GND), U3.2 (GND), U4.2 (GND), U5.5 (GND), XB1.10 (GND)
LED1: KIT1.RD-, R38.2
LED2: KIT1.RD+, R36.2
LED3: KIT1.TD-, R34.2
LED4: KIT1.TD+, R32.2
LED5: KIT1.D-, R30.2
LVL1: KIT1.P$15 (P15), R5.1, R9.2, TP1.TP
LVL2: KIT1.P$16 (P16), R12.1, R15.2, TP2.TP
LVL3: KIT1.P$17 (P17), R16.1, R19.2, TP3.TP
LVL4: KIT1.P$18 (P18), R20.1, R23.2, TP4.TP
LVL5: KIT1.P$19 (P19), R24.1, R27.2, TP5.TP
MBED_RX: KIT1.P$10 (P10), R3.1
MBED_TX: KIT1.P$9 (P9), R2.1
N5V_ON: KIT1.P$22 (P22), U1.5 (~SHDN)
unnamed: IC3.2 (-IN), R6.2
unnamed: D2.A, IC2.7 (OUT), R14.2
unnamed: D3.A, IC2.8 (OUT), R18.2
unnamed: D4.A, IC2.14 (OUT), R22.2
unnamed: D5.A, IC4.6 (OUT), R26.2
unnamed: IC4.2 (-IN), R25.2, R26.1
unnamed: IC2.13 (-IN), R21.2, R22.1
unnamed: IC2.9 (-IN), R17.2, R18.1
unnamed: IC2.6 (-IN), R13.2, R14.1
unnamed: IC2.2 (-IN), R7.2, R8.1
unnamed: C5.+, U1.6 (C+)
unnamed: D2.C, R12.2
unnamed: C5.-, U1.3 (C-)
unnamed: D1.C, R5.2
unnamed: D1.A, IC2.1 (OUT), R8.2
unnamed: D3.C, R16.2
unnamed: LED6.A, XB1.15 (ASSOC/AD5/DIO5)
unnamed: D4.C, R20.2
unnamed: R1.2, XB1.5 (!RESET)
unnamed: D5.C, R24.2
unnamed: R2.2, XB1.3 (DIN/!CONFIG)
unnamed: R3.2, XB1.2 (DOUT)
unnamed: IC3.3 (+IN), R4.1, R10.2, R11.2
unnamed: LED6.C, R40.2
unnamed: LED5.A, R30.1
unnamed: LED4.A, R32.1
unnamed: LED3.A, R34.1
unnamed: C1.1, U5.6 (BYPASS)
unnamed: LED2.A, R36.1
unnamed: LED1.A, R38.1
NR: KIT1.NR
SENSOR_IN_1: IC2.3 (+IN), P1.1, R31.2, U3.1 (IN1)
SENSOR_IN_2: IC2.5 (+IN), P1.2, R33.2, U3.3 (IN2)
SENSOR_IN_3: IC2.10 (+IN), P1.3, R35.2, U3.4 (IN3)
SENSOR_IN_4: IC2.12 (+IN), P1.4, R37.2, U3.5 (IN4)
SENSOR_IN_5: IC4.3 (+IN), P1.5, R39.2, U4.1 (IN1)
SQR_IN: KIT1.P$26 (P26), R6.1, TP7.TP
SQR_OUT_AC: IC3.6 (OUT), P1.6, R10.1, U4.3 (IN2)
VB: KIT1.VB
VO: KIT1.VOUT (VO)
VU: KIT1.VU
XBEE_PWR_ON: KIT1.P$21 (P21), U5.7 (VEN)

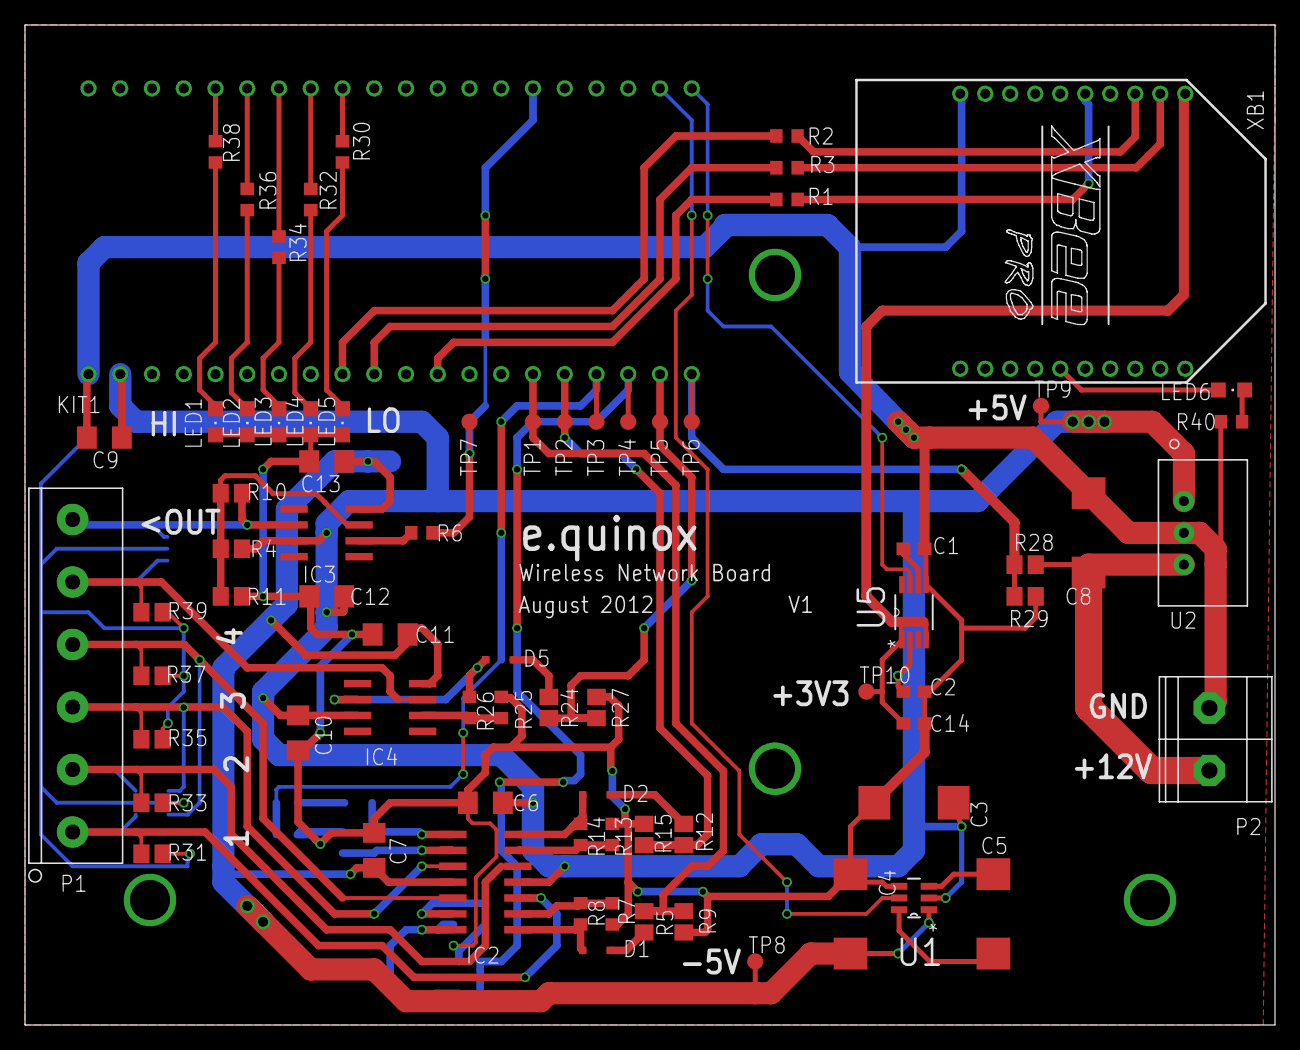
[picture p69: board waterlevel.brd from above]

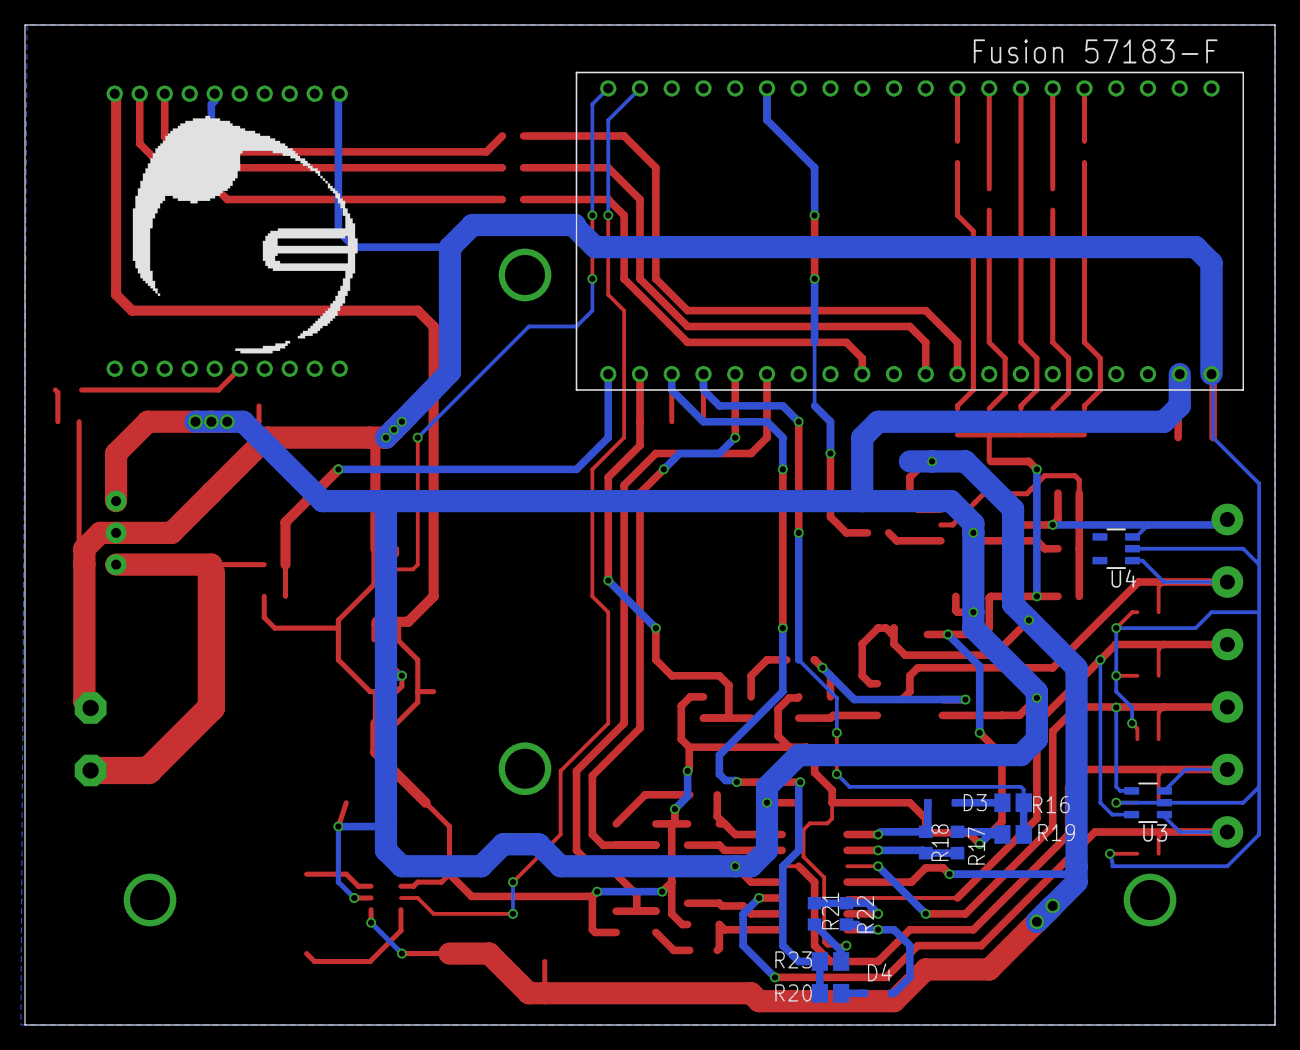
[picture p70: board waterlevel.brd from below]

Board: 2 copper layers, 100.0 x 80.0 mm, 88 parts (13 on the bottom side), 58 nets.

Other parts of the board:
U$2: EQNXLOGO
