equinoxorg/ekoHub/eko-hardware-designs/network_boards/picKit3_adapter/pickit3_adapter.brd

## EAGLE design eko-hardware-designs/network_boards/picKit3_adapter/pickit3_adapter.brd (2015-01-21)

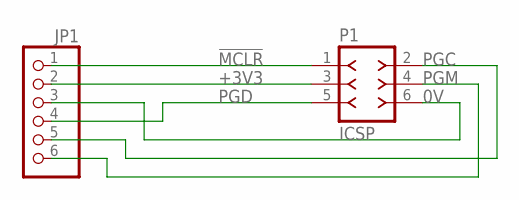
[picture p71: schematic pickit3_adapter.sch]

Parts:
JP1: PINHD-1X6/90; 1X06/90
P1: ICSP; DIL-100-2X03

Connections:
0V: JP1.3, P1.6
!MCLR!: JP1.1, P1.1
+3V3: JP1.2, P1.3
PGC: JP1.5, P1.2
PGD: JP1.4, P1.5
PGM: JP1.6, P1.4

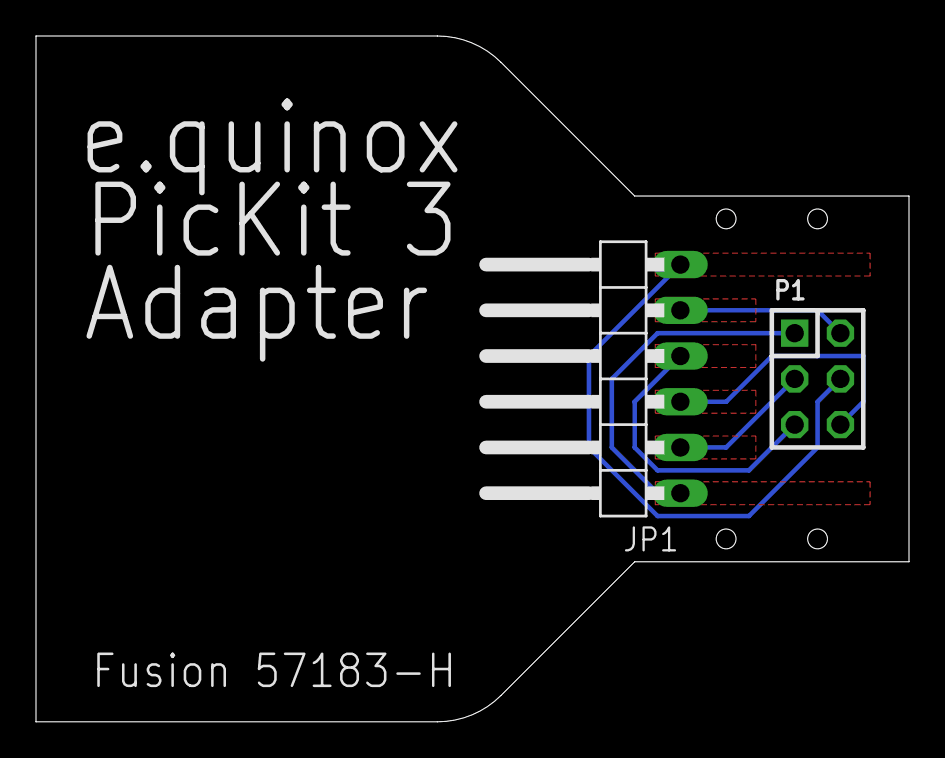
[picture p72: board pickit3_adapter.brd from above]

Board: 2 copper layers, 48.5 x 38.1 mm, 3 parts (1 on the bottom side), 6 nets.

Other parts of the board:
U$1: EQNXLOGO
