equinoxorg/ekoHub/2012-2013/Hardware/PCB/Test Board (4 sensors)/test_sensors3 (Final)/testv1.brd

## EAGLE design 2012-2013/Hardware/PCB/Test Board (4 sensors)/test_sensors3 (Final)/testv1.brd (2015-01-14)

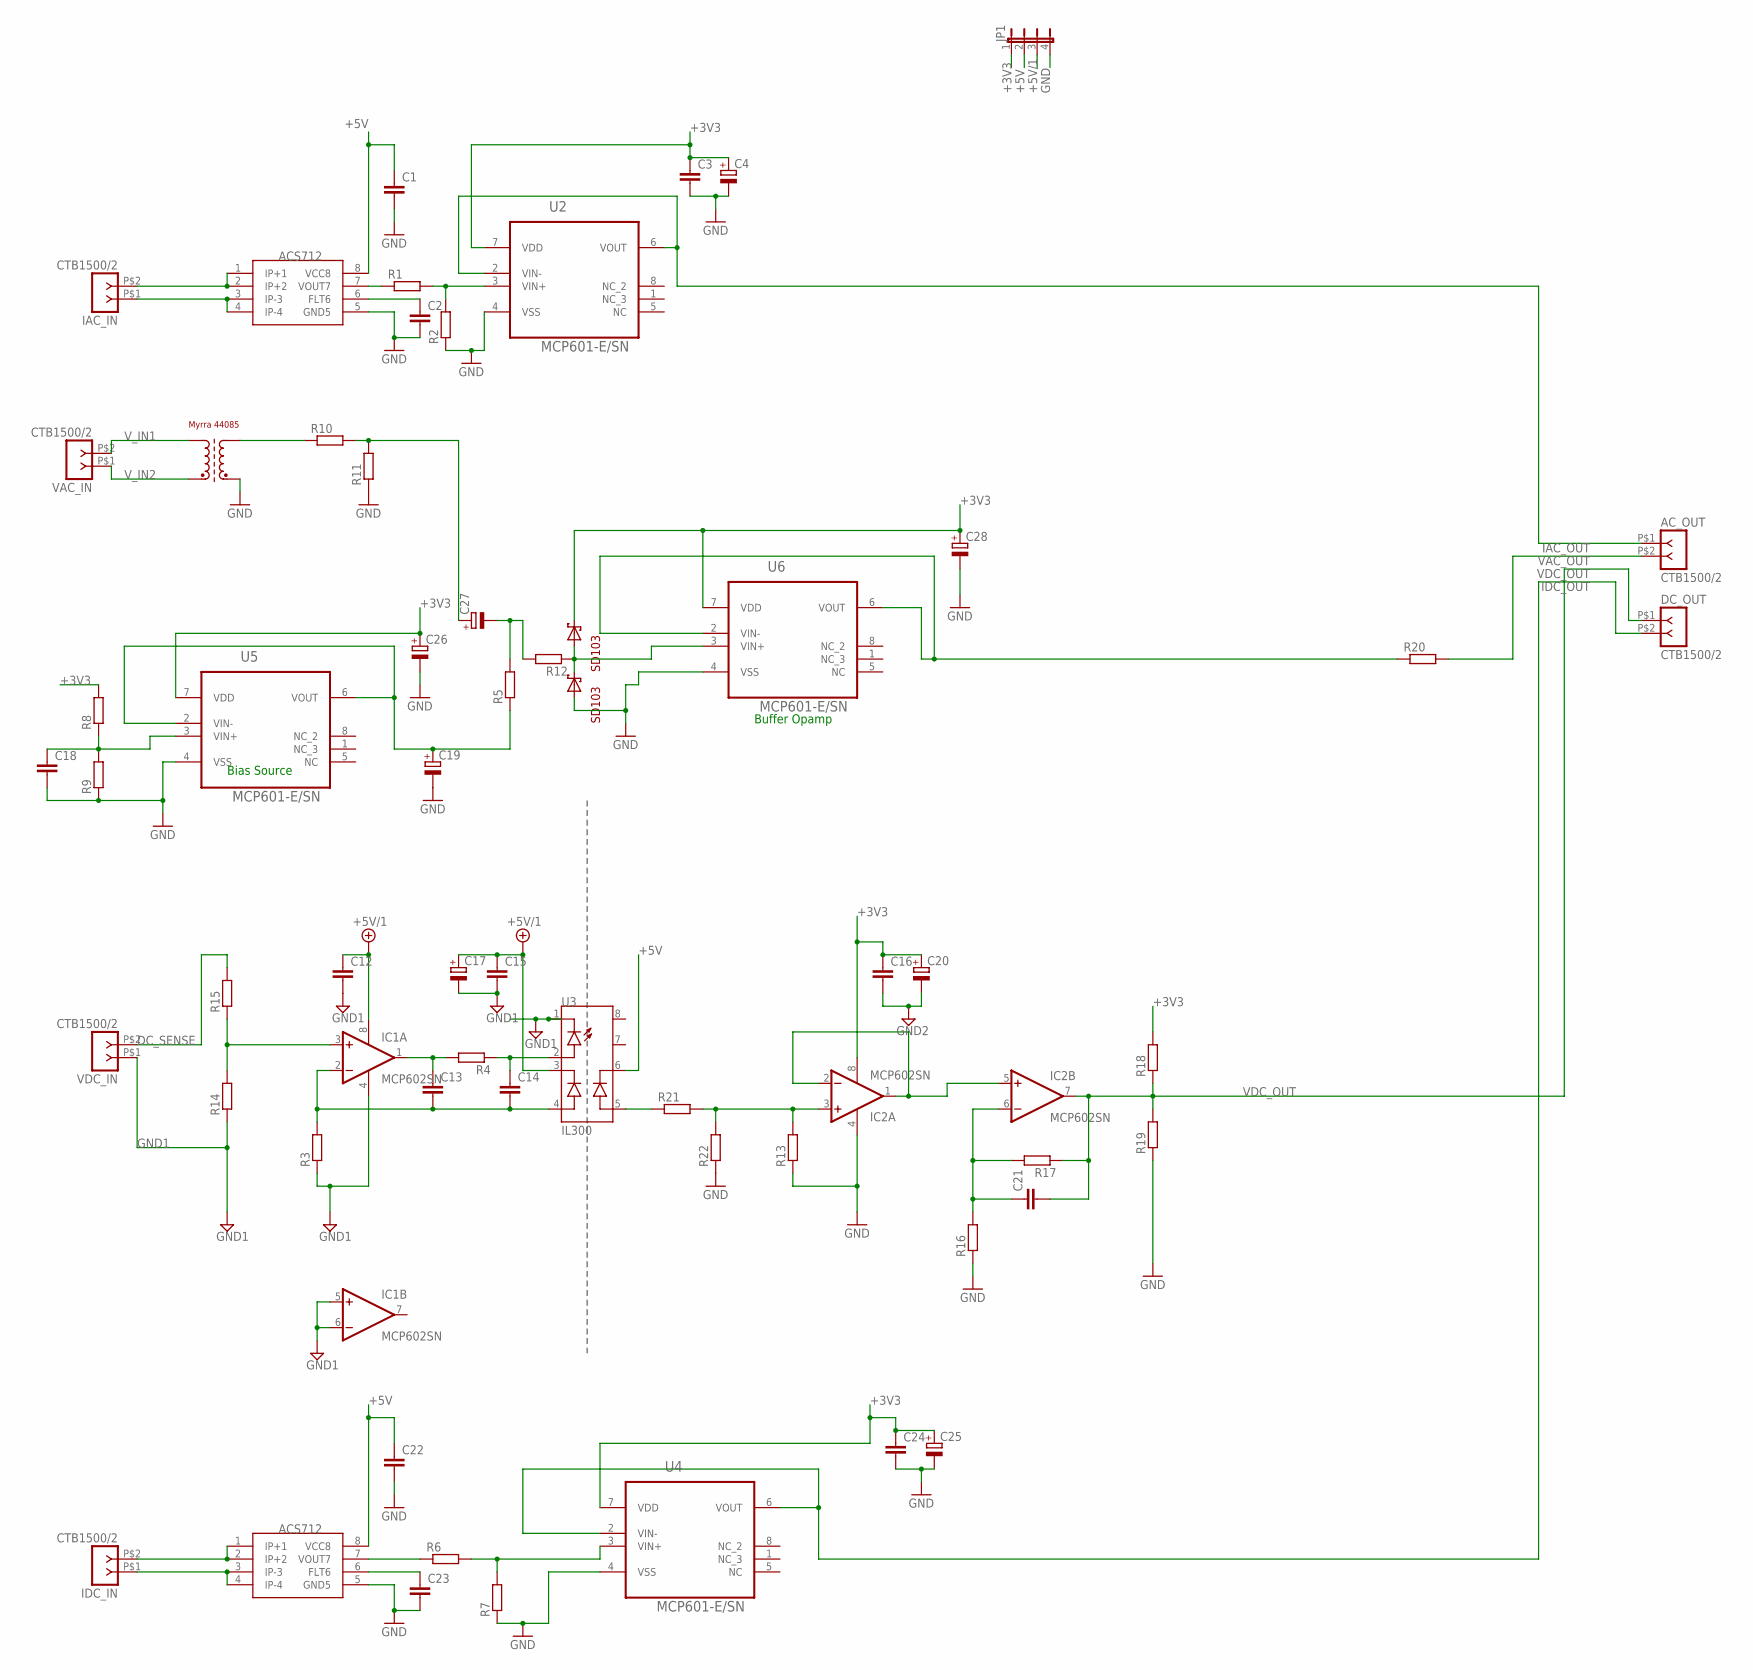
[picture p73: schematic testv1.sch]

Parts:
AC_OUT: CTB1500/2; CTB1500-2
C1, C2, C3, C12, C13, C14, C15, C16, C18, C21, C22, C23, C24: C-EU025-025X050; C025-025X050
C4, C17, C19, C20, C25, C26, C27, C28: CPOL-EUE2-4; E2-4
DC_OUT: CTB1500/2; CTB1500-2
IAC_IN: CTB1500/2; CTB1500-2
IC1, IC2: MCP602SN; SO08
IDC_IN: CTB1500/2; CTB1500-2
JP1: JP4E; JP4
R1, R2, R3, R4, R5, R6, R7, R8, R9, R10, R11, R12, R13, R14, R15, R16, R17, R18, R19, R20, R21, R22: R-EU_0207/7; 0207/7
U2, U4, U5, U6: MCP601-E/SN; SOIC127P600X175-8N
U3: IL300; SO8
U$1, U$10: ACS712; SOIC8
U$6: MYRRA_4408; 4408
U$7, U$8: SD103A; D035-10
VAC_IN: CTB1500/2; CTB1500-2
VDC_IN: CTB1500/2; CTB1500-2

Connections:
+3V3: C3.1, C4.+, C16.1, C20.+, C24.1, C25.+, C26.+, C28.+, IC2.8 (V+), JP1.1, R8.2, R18.2, U2.7 (VDD), U4.7 (VDD), U5.7 (VDD), U6.7 (VDD), U$7.C
+5V: C1.1, C22.1, JP1.2, U3.6 (C_OUT), U$1.8 (VCC8), U$10.8 (VCC8)
+5V/1: C12.1, C15.1, C17.+, IC1.8 (V+), JP1.3, U3.3 (C_FB)
DC_SENSE: R15.2, VDC_IN.P$2 (2)
GND: C1.2, C2.2, C3.2, C4.-, C18.2, C19.-, C22.2, C23.2, C24.2, C25.-, C26.-, C28.-, IC2.4 (V-), JP1.4, R2.1, R7.1, R9.1, R11.1, R13.1, R16.1, R19.1, R22.1, U2.4 (VSS), U4.4 (VSS), U5.4 (VSS), U6.4 (VSS), U$1.5 (GND5), U$6.PIN9 (E2), U$8.A, U$10.5 (GND5)
GND1: C12.2, C15.2, C17.-, IC1.4 (V-), IC1.5 (+IN), IC1.6 (-IN), R3.1, R14.1, U3.1 (C_LED), VDC_IN.P$1 (1)
GND2: C16.2, C20.-
IAC_OUT: AC_OUT.P$1 (1), U2.2 (VIN-), U2.6 (VOUT)
IDC_OUT: DC_OUT.P$2 (2), U4.2 (VIN-), U4.6 (VOUT)
unnamed: IAC_IN.P$2 (2), U$1.1 (IP+1), U$1.2 (IP+2)
unnamed: IAC_IN.P$1 (1), U$1.3 (IP-3), U$1.4 (IP-4)
unnamed: R1.1, U$1.7 (VOUT7)
unnamed: C2.1, U$1.6 (FLT6)
unnamed: C13.2, C14.2, IC1.2 (-IN), R3.2, U3.4 (A_FB)
unnamed: R1.2, R2.2, U2.3 (VIN+)
unnamed: C14.1, R4.1, U3.2 (A_LED)
unnamed: IDC_IN.P$2 (2), U$10.1 (IP+1), U$10.2 (IP+2)
unnamed: C13.1, IC1.1 (OUT), R4.2
unnamed: C18.1, R8.1, R9.2, U5.3 (VIN+)
unnamed: C19.+, R5.1, U5.2 (VIN-), U5.6 (VOUT)
unnamed: R12.1, U6.3 (VIN+), U$7.A, U$8.C
unnamed: R20.1, U6.2 (VIN-), U6.6 (VOUT)
unnamed: IC2.3 (+IN), R13.2, R21.2, R22.2
unnamed: R21.1, U3.5 (A_OUT)
unnamed: C27.+, R10.2, R11.2
unnamed: R10.1, U$6.PIN7 (A2)
unnamed: IC2.1 (OUT), IC2.2 (-IN), IC2.5 (+IN)
unnamed: C27.-, R5.2, R12.2
unnamed: C21.1, IC2.6 (-IN), R16.2, R17.2
unnamed: IC1.3 (+IN), R14.2, R15.1
unnamed: IDC_IN.P$1 (1), U$10.3 (IP-3), U$10.4 (IP-4)
unnamed: R6.1, U$10.7 (VOUT7)
unnamed: C23.1, U$10.6 (FLT6)
unnamed: R6.2, R7.2, U4.3 (VIN+)
VAC_OUT: AC_OUT.P$2 (2), R20.2
VDC_OUT: C21.2, DC_OUT.P$1 (1), IC2.7 (OUT), R17.1, R18.1, R19.2
V_IN1: U$6.PIN5 (A1), VAC_IN.P$2 (2)
V_IN2: U$6.PIN1 (E1), VAC_IN.P$1 (1)

Notes on the sheet:
Buffer Opamp
Bias Source
