equinoxorg/ekoHub/2012-2013/Hardware/PCB/Test Board (4 sensors)/test_sensors3 (Final)/testv1.brd

## EAGLE design 2012-2013/Hardware/PCB/Test Board (4 sensors)/test_sensors3 (Final)/testv1.brd (continued)

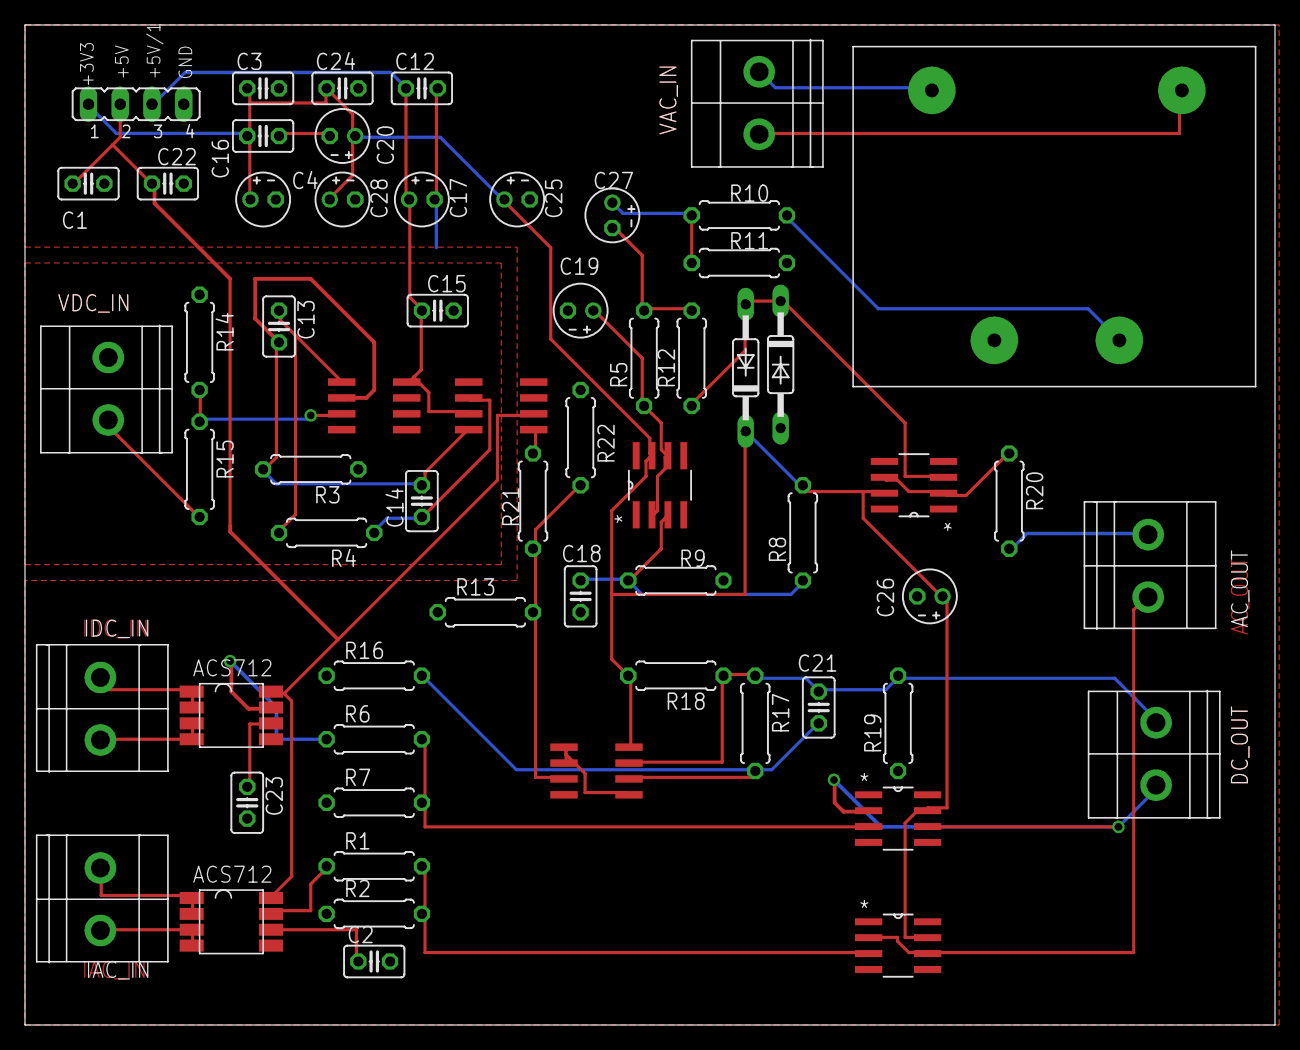
[picture p74: board testv1.brd from above]

Board: 2 copper layers, 100.0 x 80.0 mm, 62 parts (0 on the bottom side), 38 nets.
