equinoxorg/ekoHub/2012-2013/Hardware/PCB/Final/Power Board/power.brd

## EAGLE design 2012-2013/Hardware/PCB/Final/Power Board/power.brd (2015-01-14)

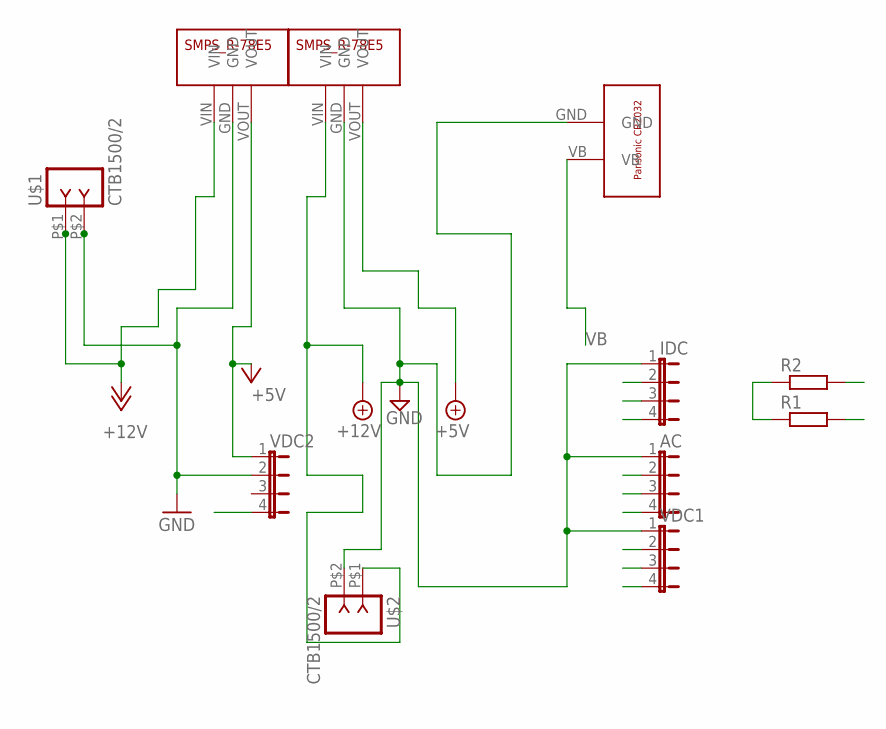
[picture p75: schematic power.sch]

Parts:
AC: JP4E; JP4
IDC: JP4E; JP4
R1, R2: R-EU_0207/7; 0207/7
U$1, U$2: CTB1500/2; CTB1500-2
U$3: PANASONIC_CR2032
U$4, U$5: SMPS_R-78E5
VDC1, VDC2: JP4E; JP4

Connections:
+5V/1: AC.2, IDC.2, R1.1, R2.1, U$5.VOUT, VDC1.2
+5V/2: U$4.VOUT, VDC2.1
+12V/1: U$2.P$1 (1), U$5.VIN
+12V/2: U$1.P$1 (1), U$4.VIN
GND1: AC.1, IDC.1, U$2.P$2 (2), U$3.GND, U$5.GND, VDC1.1
GND2: U$1.P$2 (2), U$4.GND, VDC2.2
SCL: AC.4, IDC.4, R1.2, VDC1.4
SDA: AC.3, IDC.3, R2.2, VDC1.3
VB: U$3.VB, VDC2.4

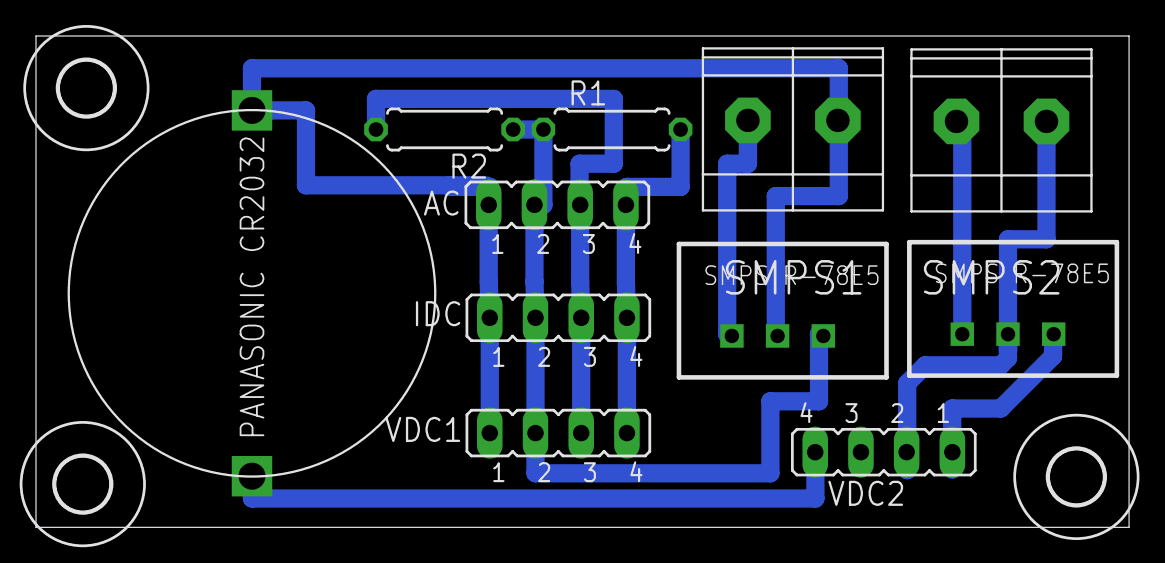
[picture p76: board power.brd from above]

Board: 2 copper layers, 60.7 x 27.3 mm, 14 parts (0 on the bottom side), 9 nets.

Other parts of the board:
U$6, U$7, U$8: 3,0
