equinoxorg/ekoHub/2012-2013/Hardware/PCB/Final/VDC/VDC.brd

## EAGLE design 2012-2013/Hardware/PCB/Final/VDC/VDC.brd (2015-01-14)

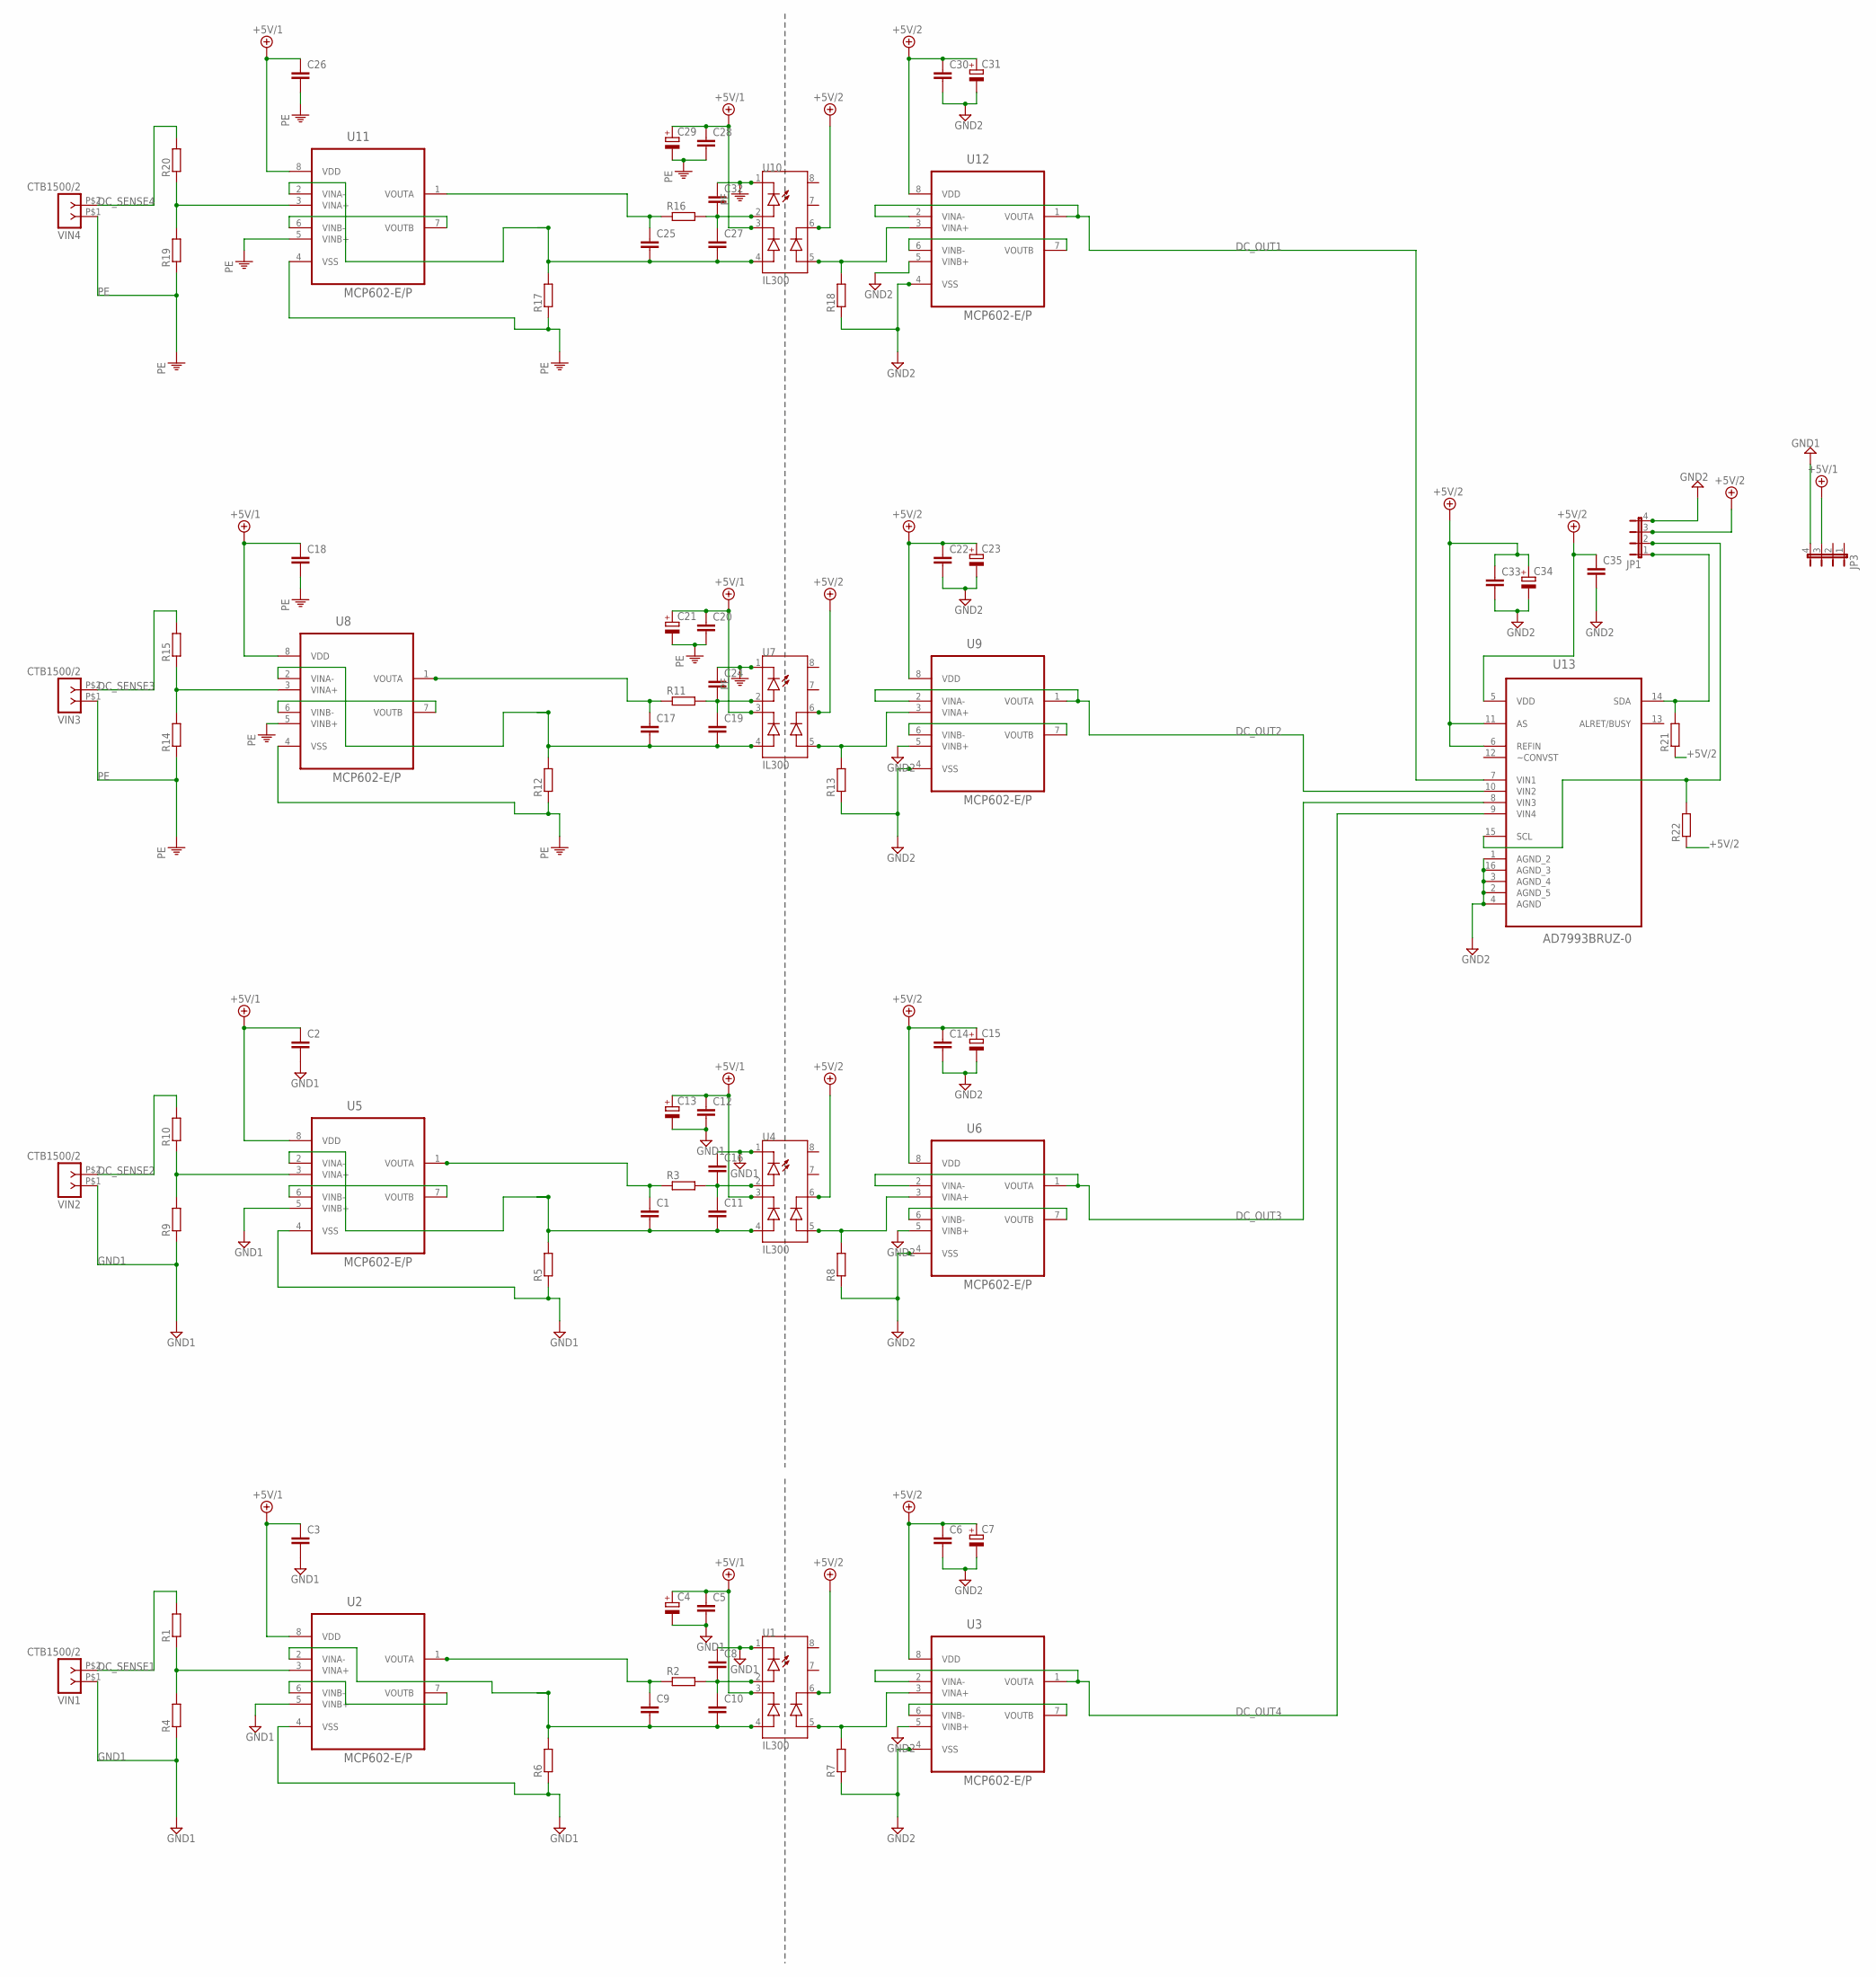
[picture p77: schematic VDC.sch]

Parts:
C1, C2, C3, C5, C6, C8, C9, C10, C11, C12, C14, C16, C17, C18, C19, C20, C22, C24, C25, C26, C27, C28, C30, C32: C-EU025-040X050; C025-040X050
C4, C7, C13, C15, C21, C23, C29, C31: CPOL-EUE2-5; E2-5
C33: C-EU025-024X044; C025-024X044
C34: CPOL-EUE2-4; E2-4
C35: C-EU025-025X050; C025-025X050
JP1, JP3: JP4E; JP4
R1, R2, R3, R4, R5, R6, R7, R8, R9, R10, R11, R12, R13, R14, R15, R16, R17, R18, R19, R20, R21, R22: R-EU_0207/10; 0207/10
U1, U4, U7, U10: IL300; DIL08
U2, U3, U5, U6, U8, U9, U11, U12: MCP602-E/P; DIP254P762X508-8P
U13: AD7993BRUZ-0; SOP65P640X120-16N
VIN1, VIN2, VIN3, VIN4: CTB1500/2; CTB1500-2

Connections:
+5V/1: C2.1, C3.1, C4.+, C5.1, C12.1, C13.+, C18.1, C20.1, C21.+, C26.1, C28.1, C29.+, JP3.3, U1.3 (C_FB), U2.8 (VDD), U4.3 (C_FB), U5.8 (VDD), U7.3 (C_FB), U8.8 (VDD), U10.3 (C_FB), U11.8 (VDD)
+5V/2: C6.1, C7.+, C14.1, C15.+, C22.1, C23.+, C30.1, C31.+, C33.1, C34.+, C35.1, JP1.3, R21.1, R22.1, U1.6 (C_OUT), U3.8 (VDD), U4.6 (C_OUT), U6.8 (VDD), U7.6 (C_OUT), U9.8 (VDD), U10.6 (C_OUT), U12.8 (VDD), U13.5 (VDD), U13.6 (REFIN), U13.11 (AS)
DC_OUT1: U12.1 (VOUTA), U12.2 (VINA-), U13.7 (VIN1)
DC_OUT2: U9.1 (VOUTA), U9.2 (VINA-), U13.10 (VIN2)
DC_OUT3: U6.1 (VOUTA), U6.2 (VINA-), U13.8 (VIN3)
DC_OUT4: U3.1 (VOUTA), U3.2 (VINA-), U13.9 (VIN4)
DC_SENSE1: R1.2, VIN1.P$2 (2)
DC_SENSE2: R10.2, VIN2.P$2 (2)
DC_SENSE3: R15.2, VIN3.P$2 (2)
DC_SENSE4: R20.2, VIN4.P$2 (2)
GND1: C2.2, C3.2, C4.-, C5.2, C8.1, C12.2, C13.-, C16.1, JP3.4, R4.1, R5.1, R6.1, R9.1, U1.1 (C_LED), U2.4 (VSS), U2.5 (VINB+), U4.1 (C_LED), U5.4 (VSS), U5.5 (VINB+), VIN1.P$1 (1), VIN2.P$1 (1)
GND2: C6.2, C7.-, C14.2, C15.-, C22.2, C23.-, C30.2, C31.-, C33.2, C34.-, C35.2, JP1.4, R7.1, R8.1, R13.1, R18.1, U3.4 (VSS), U3.5 (VINB+), U6.4 (VSS), U6.5 (VINB+), U9.4 (VSS), U9.5 (VINB+), U12.4 (VSS), U12.5 (VINB+), U13.1 (AGND_2), U13.2 (AGND_5), U13.3 (AGND_4), U13.4 (AGND), U13.16 (AGND_3)
unnamed: C9.2, C10.2, R6.2, U1.4 (A_FB), U2.2 (VINA-)
unnamed: C1.2, C11.2, R5.2, U4.4 (A_FB), U5.2 (VINA-)
unnamed: R7.2, U1.5 (A_OUT), U3.3 (VINA+)
unnamed: C8.2, C10.1, R2.2, U1.2 (A_LED)
unnamed: C9.1, R2.1, U2.1 (VOUTA)
unnamed: C11.1, C16.2, R3.2, U4.2 (A_LED)
unnamed: C1.1, R3.1, U5.1 (VOUTA)
unnamed: R1.1, R4.2, U2.3 (VINA+)
unnamed: R8.2, U4.5 (A_OUT), U6.3 (VINA+)
unnamed: R9.2, R10.1, U5.3 (VINA+)
unnamed: C17.2, C19.2, R12.2, U7.4 (A_FB), U8.2 (VINA-)
unnamed: C19.1, C24.2, R11.2, U7.2 (A_LED)
unnamed: C17.1, R11.1, U8.1 (VOUTA)
unnamed: R13.2, U7.5 (A_OUT), U9.3 (VINA+)
unnamed: R14.2, R15.1, U8.3 (VINA+)
unnamed: C25.2, C27.2, R17.2, U10.4 (A_FB), U11.2 (VINA-)
unnamed: C27.1, C32.2, R16.2, U10.2 (A_LED)
unnamed: C25.1, R16.1, U11.1 (VOUTA)
unnamed: R18.2, U10.5 (A_OUT), U12.3 (VINA+)
unnamed: R19.2, R20.1, U11.3 (VINA+)
unnamed: JP1.1, R21.2, U13.14 (SDA)
unnamed: JP1.2, R22.2, U13.15 (SCL)
unnamed: U11.6 (VINB-), U11.7 (VOUTB)
unnamed: U12.6 (VINB-), U12.7 (VOUTB)
unnamed: U8.6 (VINB-), U8.7 (VOUTB)
unnamed: U9.6 (VINB-), U9.7 (VOUTB)
unnamed: U5.6 (VINB-), U5.7 (VOUTB)
unnamed: U6.6 (VINB-), U6.7 (VOUTB)
unnamed: U2.6 (VINB-), U2.7 (VOUTB)
unnamed: U3.6 (VINB-), U3.7 (VOUTB)
PE: C18.2, C20.2, C21.-, C24.1, C26.2, C28.2, C29.-, C32.1, R12.1, R14.1, R17.1, R19.1, U7.1 (C_LED), U8.4 (VSS), U8.5 (VINB+), U10.1 (C_LED), U11.4 (VSS), U11.5 (VINB+), VIN3.P$1 (1), VIN4.P$1 (1)

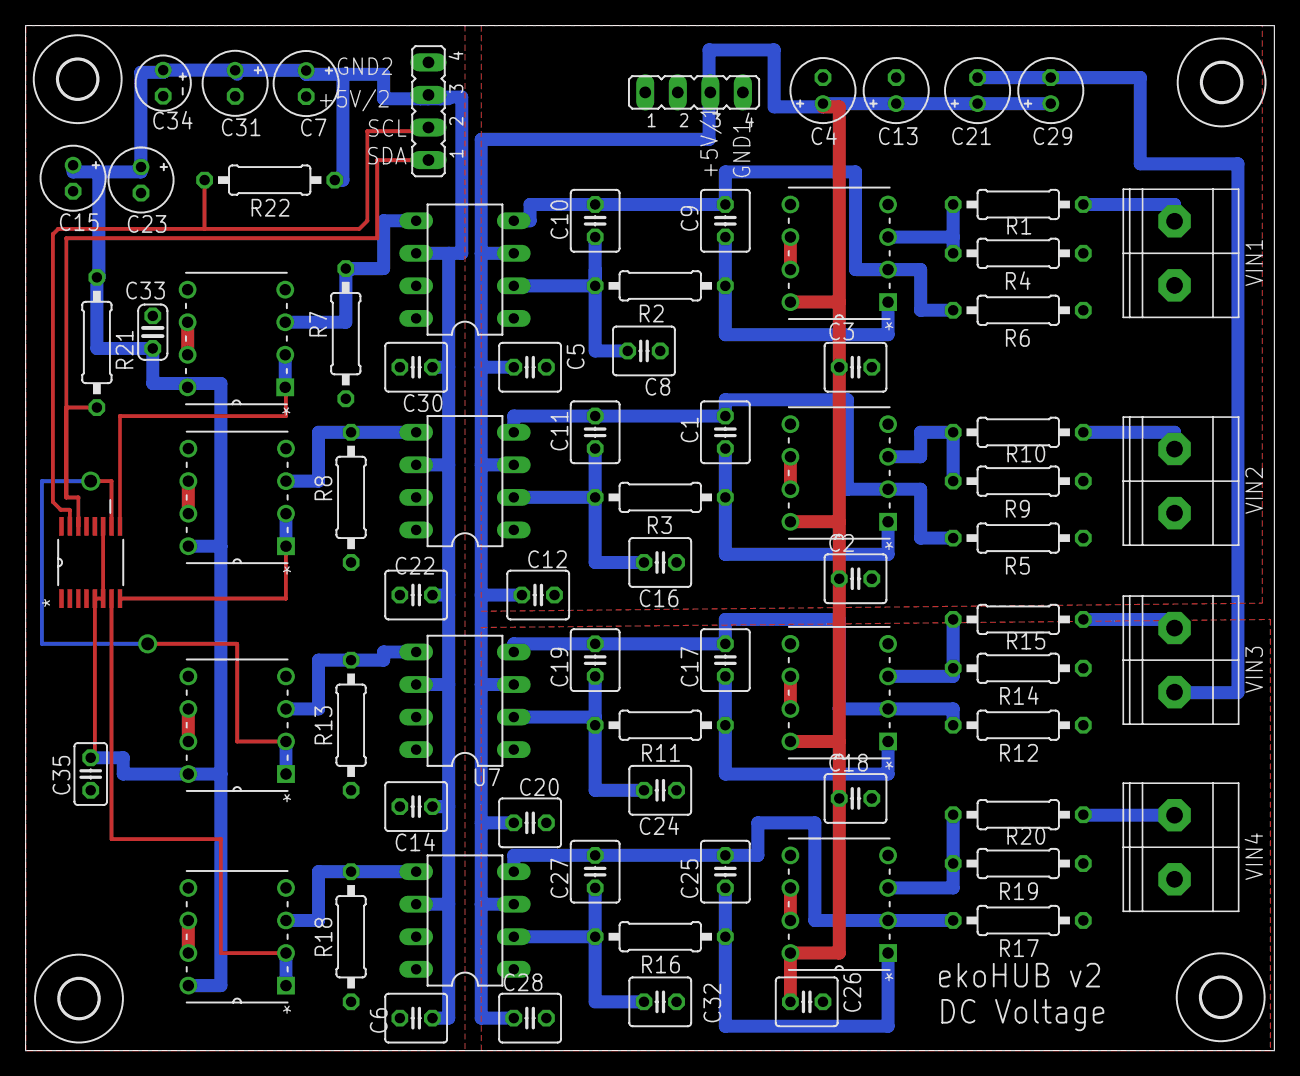
[picture p78: board 2012-2013/Hardware/PCB/Final/VDC/VDC.brd from above]

Board: 2 copper layers, 97.5 x 80.0 mm, 80 parts (0 on the bottom side), 43 nets.

Other parts of the board:
U$1, U$2, U$3, U$4: 3,0
