equinoxorg/ekoHub/2012-2013/Hardware/PCB/JulyTest/AC Voltage - final/ADC.brd

## EAGLE design 2012-2013/Hardware/PCB/JulyTest/AC Voltage - final/ADC.brd (2015-01-14)

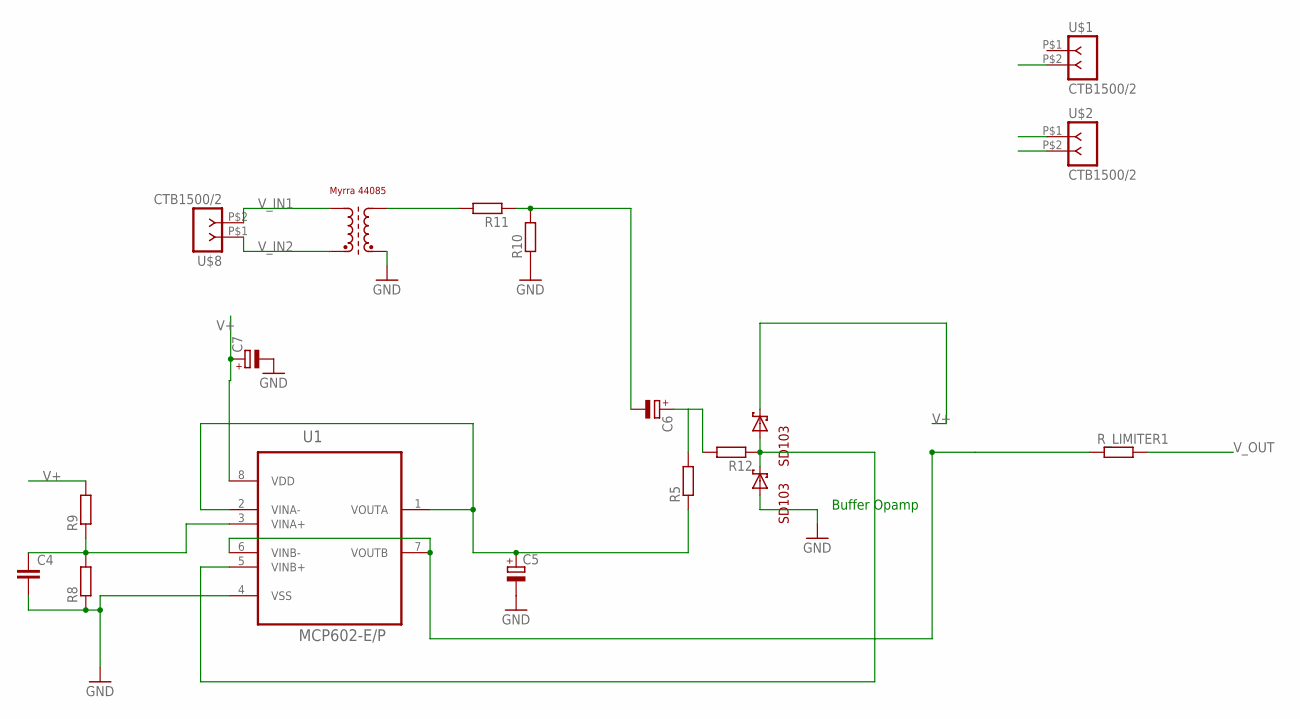
[picture p79: schematic ADC.sch]

Parts:
C4: C5P; C050-030-075
C5, C6, C7: CPOL1; E2,5-7---100UF
R5, R8, R9, R10, R11, R12: R; 0207/10
R_LIMITER1: R; 0207/10
U1: MCP602-E/P; DIP254P762X508-8P
U$1, U$2, U$8: CTB1500/2; CTB1500-2
U$5: MYRRA_4408; 4408
U$6, U$7: SD103A; D035-10

Connections:
GND: C4.2, C5.-, C7.-, R8.1, R10.1, U1.4 (VSS), U$2.P$1 (1), U$5.PIN9 (E2), U$7.A
unnamed: R_LIMITER1.1, U1.6 (VINB-), U1.7 (VOUTB)
unnamed: C5.+, R5.1, U1.1 (VOUTA), U1.2 (VINA-)
unnamed: C4.1, R8.2, R9.1, U1.3 (VINA+)
unnamed: R12.1, U1.5 (VINB+), U$6.A, U$7.C
unnamed: C6.-, R10.2, R11.1
unnamed: R11.2, U$5.PIN7 (A2)
unnamed: C6.+, R5.2, R12.2
V+: C7.+, R9.2, U1.8 (VDD), U$1.P$2 (2), U$6.C
V_IN1: U$5.PIN5 (A1), U$8.P$2 (2)
V_IN2: U$5.PIN1 (E1), U$8.P$1 (1)
V_OUT: R_LIMITER1.2, U$2.P$2 (2)

Notes on the sheet:
Buffer Opamp

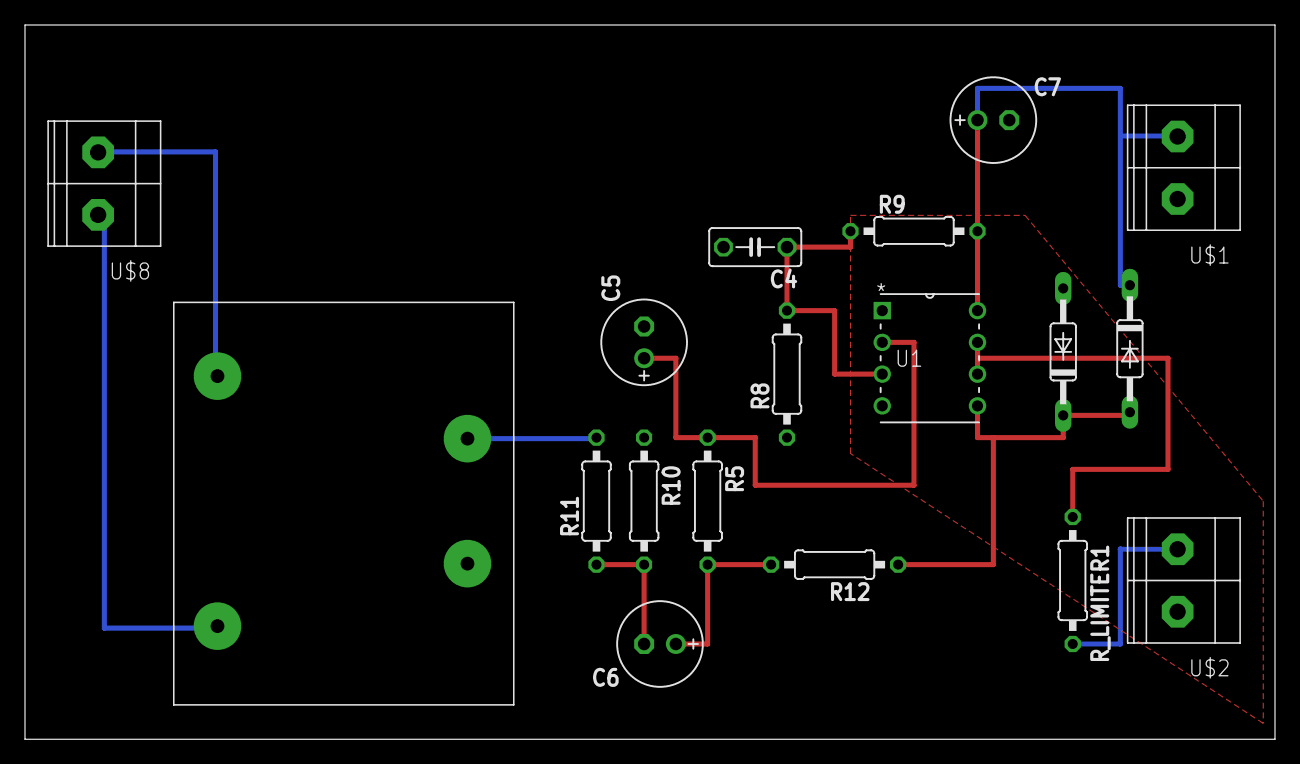
[picture p80: board ADC.brd from above]

Board: 2 copper layers, 100.0 x 57.1 mm, 18 parts (0 on the bottom side), 12 nets.
