equinoxorg/ekoHub/2012-2013/Hardware/PCB/Final/IDC/IDC.brd

## EAGLE design 2012-2013/Hardware/PCB/Final/IDC/IDC.brd (2015-01-14)

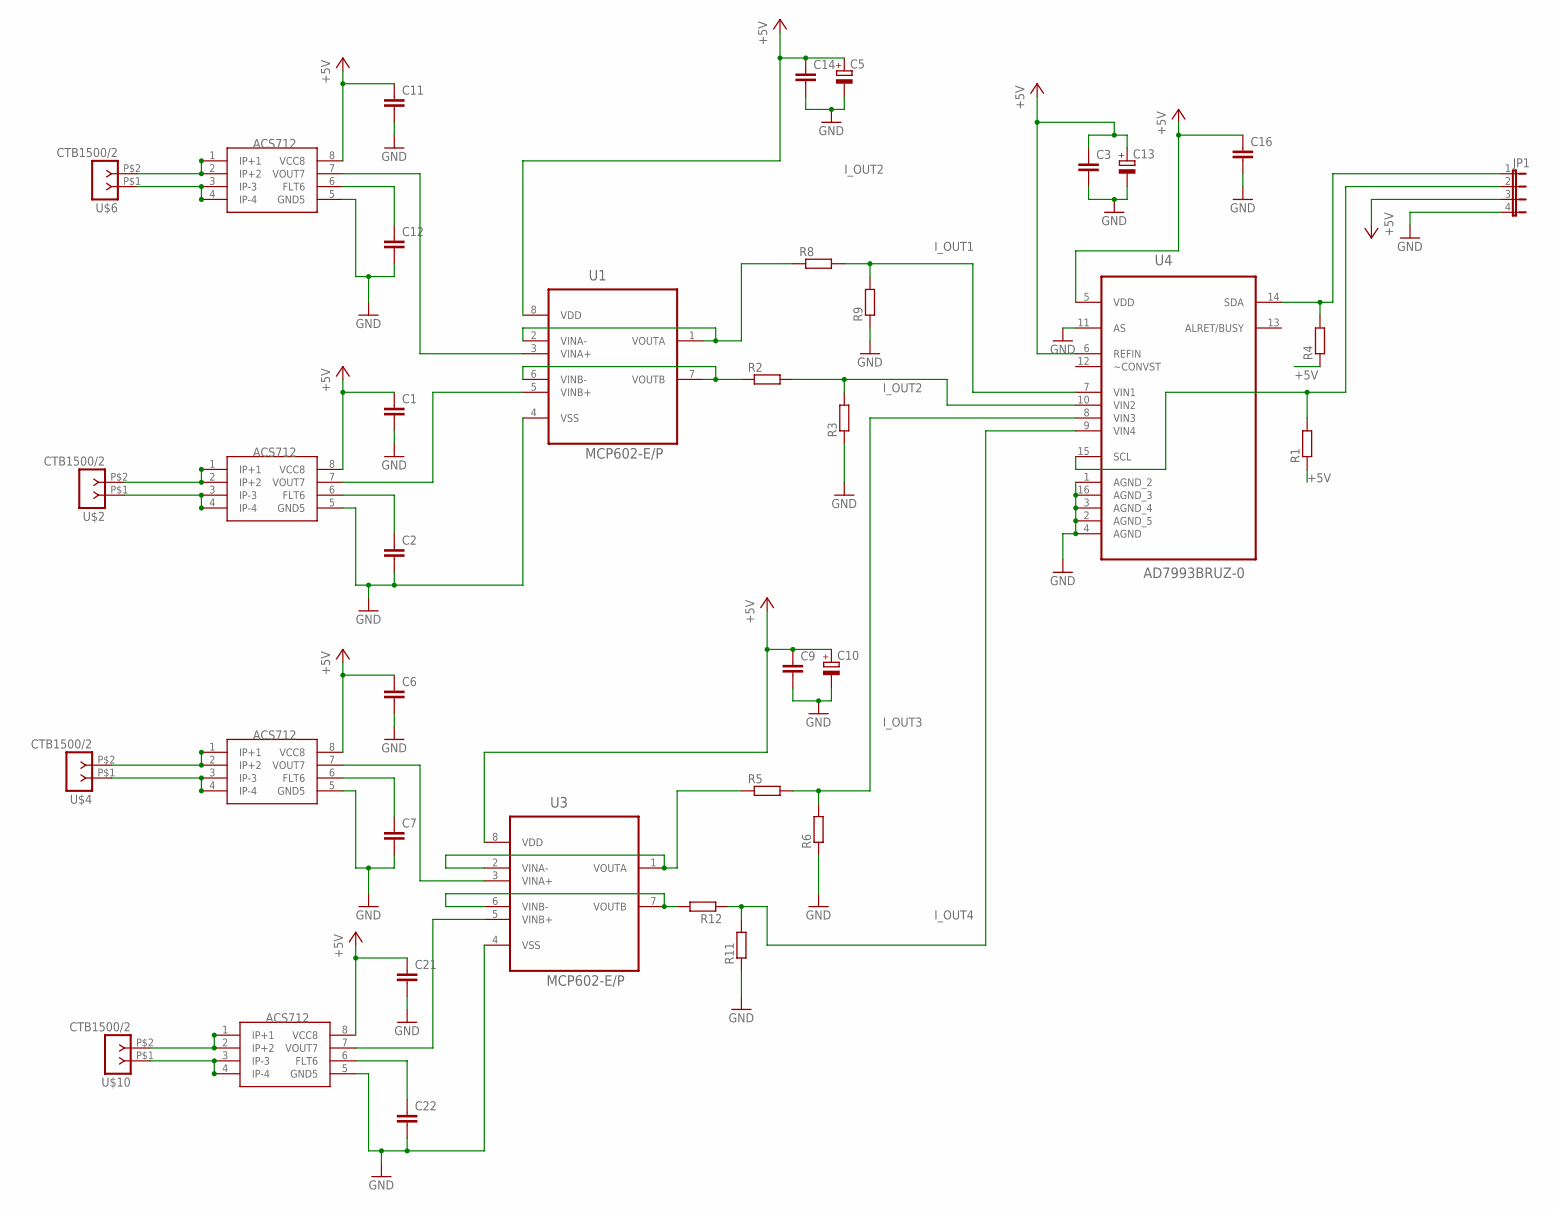
[picture p81: schematic IDC.sch]

Parts:
C1, C2, C3, C6, C7, C9, C11, C12, C14, C21, C22: C-EU025-024X044; C025-024X044
C5, C10, C13: CPOL-EUE2-4; E2-4
C16: C-EU025-025X050; C025-025X050
JP1: JP4E; JP4
R1, R2, R3, R4, R5, R6, R8, R9, R11, R12: R-EU_0207/7; 0207/7
U1, U3: MCP602-E/P; DIP254P762X508-8P
U4: AD7993BRUZ-0; SOP65P640X120-16N
U$1, U$3, U$5, U$9: ACS712; SO8
U$2, U$4, U$6, U$10: CTB1500/2; CTB1500-2

Connections:
+5V: C1.1, C3.1, C5.+, C6.1, C9.1, C10.+, C11.1, C13.+, C14.1, C16.1, C21.1, JP1.3, R1.1, R4.1, U1.8 (VDD), U3.8 (VDD), U4.5 (VDD), U4.6 (REFIN), U$1.8 (VCC8), U$3.8 (VCC8), U$5.8 (VCC8), U$9.8 (VCC8)
GND: C1.2, C2.2, C3.2, C5.-, C6.2, C7.2, C9.2, C10.-, C11.2, C12.2, C13.-, C14.2, C16.2, C21.2, C22.2, JP1.4, R3.1, R6.1, R9.1, R11.1, U1.4 (VSS), U3.4 (VSS), U4.1 (AGND_2), U4.2 (AGND_5), U4.3 (AGND_4), U4.4 (AGND), U4.11 (AS), U4.16 (AGND_3), U$1.5 (GND5), U$3.5 (GND5), U$5.5 (GND5), U$9.5 (GND5)
I_OUT: R2.1, U1.6 (VINB-), U1.7 (VOUTB)
I_OUT1: R8.2, R9.2, U4.7 (VIN1)
I_OUT2: R2.2, R3.2, R8.1, U1.1 (VOUTA), U1.2 (VINA-), U4.10 (VIN2)
I_OUT3: R5.2, R6.2, U4.8 (VIN3)
I_OUT4: R11.2, R12.1, U4.9 (VIN4)
unnamed: JP1.1, R4.2, U4.14 (SDA)
unnamed: U$1.3 (IP-3), U$1.4 (IP-4), U$2.P$1 (1)
unnamed: JP1.2, R1.2, U4.15 (SCL)
unnamed: C2.1, U$1.6 (FLT6)
unnamed: U$3.3 (IP-3), U$3.4 (IP-4), U$4.P$1 (1)
unnamed: U3.5 (VINB+), U$9.7 (VOUT7)
unnamed: C7.1, U$3.6 (FLT6)
unnamed: U1.5 (VINB+), U$1.7 (VOUT7)
unnamed: R5.1, U3.1 (VOUTA), U3.2 (VINA-)
unnamed: U3.3 (VINA+), U$3.7 (VOUT7)
unnamed: U$5.3 (IP-3), U$5.4 (IP-4), U$6.P$1 (1)
unnamed: C12.1, U$5.6 (FLT6)
unnamed: U$5.1 (IP+1), U$5.2 (IP+2), U$6.P$2 (2)
unnamed: U$1.1 (IP+1), U$1.2 (IP+2), U$2.P$2 (2)
unnamed: U1.3 (VINA+), U$5.7 (VOUT7)
unnamed: U$3.1 (IP+1), U$3.2 (IP+2), U$4.P$2 (2)
unnamed: U$9.1 (IP+1), U$9.2 (IP+2), U$10.P$2 (2)
unnamed: R12.2, U3.6 (VINB-), U3.7 (VOUTB)
unnamed: U$9.3 (IP-3), U$9.4 (IP-4), U$10.P$1 (1)
unnamed: C22.1, U$9.6 (FLT6)

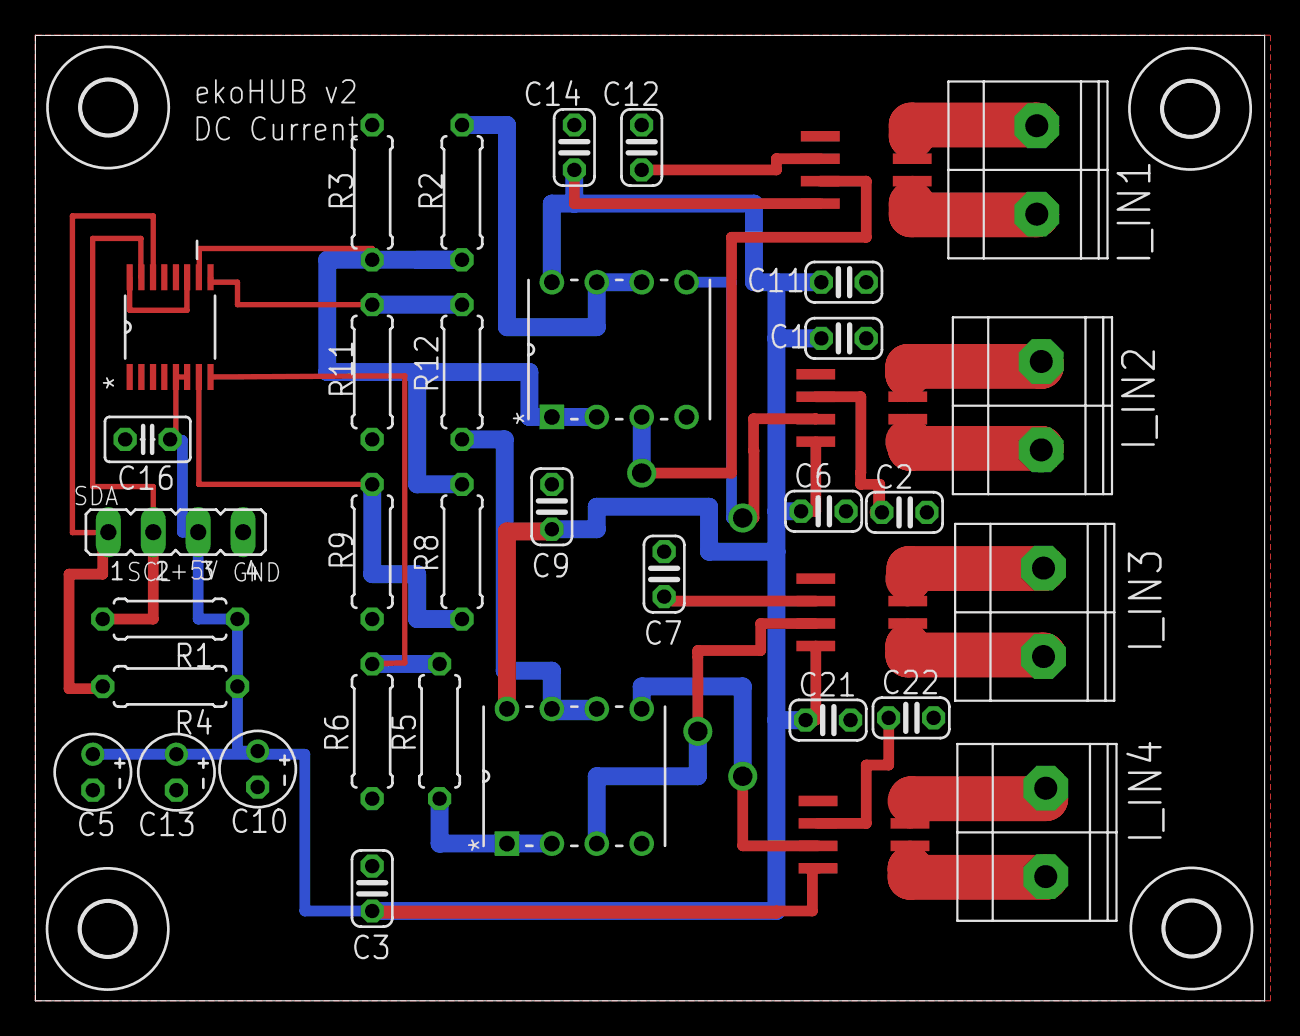
[picture p82: board IDC.brd from above]

Board: 2 copper layers, 69.5 x 54.6 mm, 41 parts (0 on the bottom side), 27 nets.

Other parts of the board:
U$7, U$8, U$11, U$12: 3,0
