equinoxorg/ekoHub/2012-2013/Hardware/PCB/DS3231 breakout/ds3231.brd

## EAGLE design 2012-2013/Hardware/PCB/DS3231 breakout/ds3231.brd (2015-01-14)

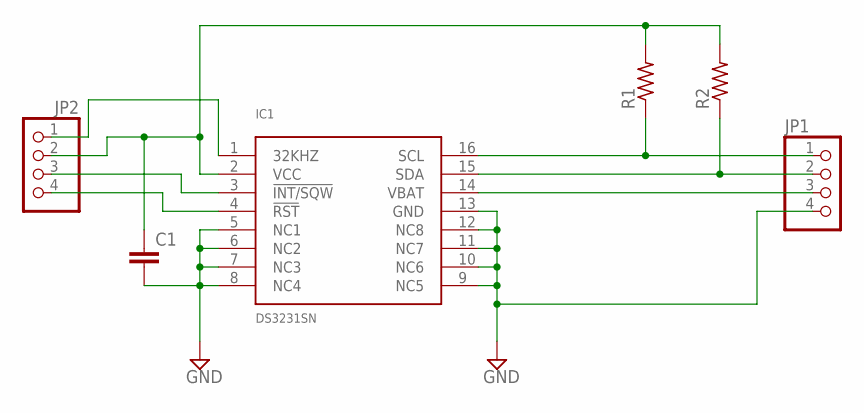
[picture p83: schematic ds3231.sch]

Parts:
C1: C5/3.5; C5B3.5
IC1: DS3231SN; SO16W
JP1, JP2: PINHD-1X4; 1X04
R1, R2: R-US_0207/10; 0207/10

Connections:
GND: C1.2, IC1.5 (NC1), IC1.6 (NC2), IC1.7 (NC3), IC1.8 (NC4), IC1.9 (NC5), IC1.10 (NC6), IC1.11 (NC7), IC1.12 (NC8), IC1.13 (GND), JP1.4
unnamed: C1.1, IC1.2 (VCC), JP2.2, R1.2, R2.2
unnamed: IC1.1 (32KHZ), JP2.1
unnamed: IC1.14 (VBAT), JP1.3
unnamed: IC1.4 (!RST), JP2.4
unnamed: IC1.3 (!INT/SQW), JP2.3
unnamed: IC1.15 (SDA), JP1.2, R2.1
R1: IC1.16 (SCL), JP1.1, R1.1

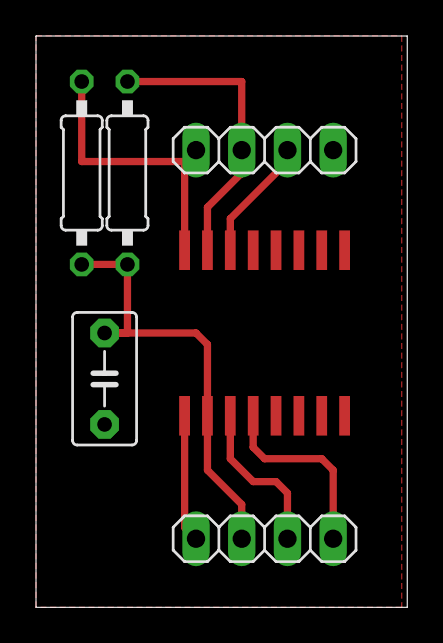
[picture p84: board ds3231.brd from above]

Board: 2 copper layers, 20.6 x 31.7 mm, 6 parts (0 on the bottom side), 8 nets.
