equinoxorg/ekoHub/2012-2013/Hardware/PCB/Final/AC Board/ACBoard.brd

## EAGLE design 2012-2013/Hardware/PCB/Final/AC Board/ACBoard.brd (2015-01-14)

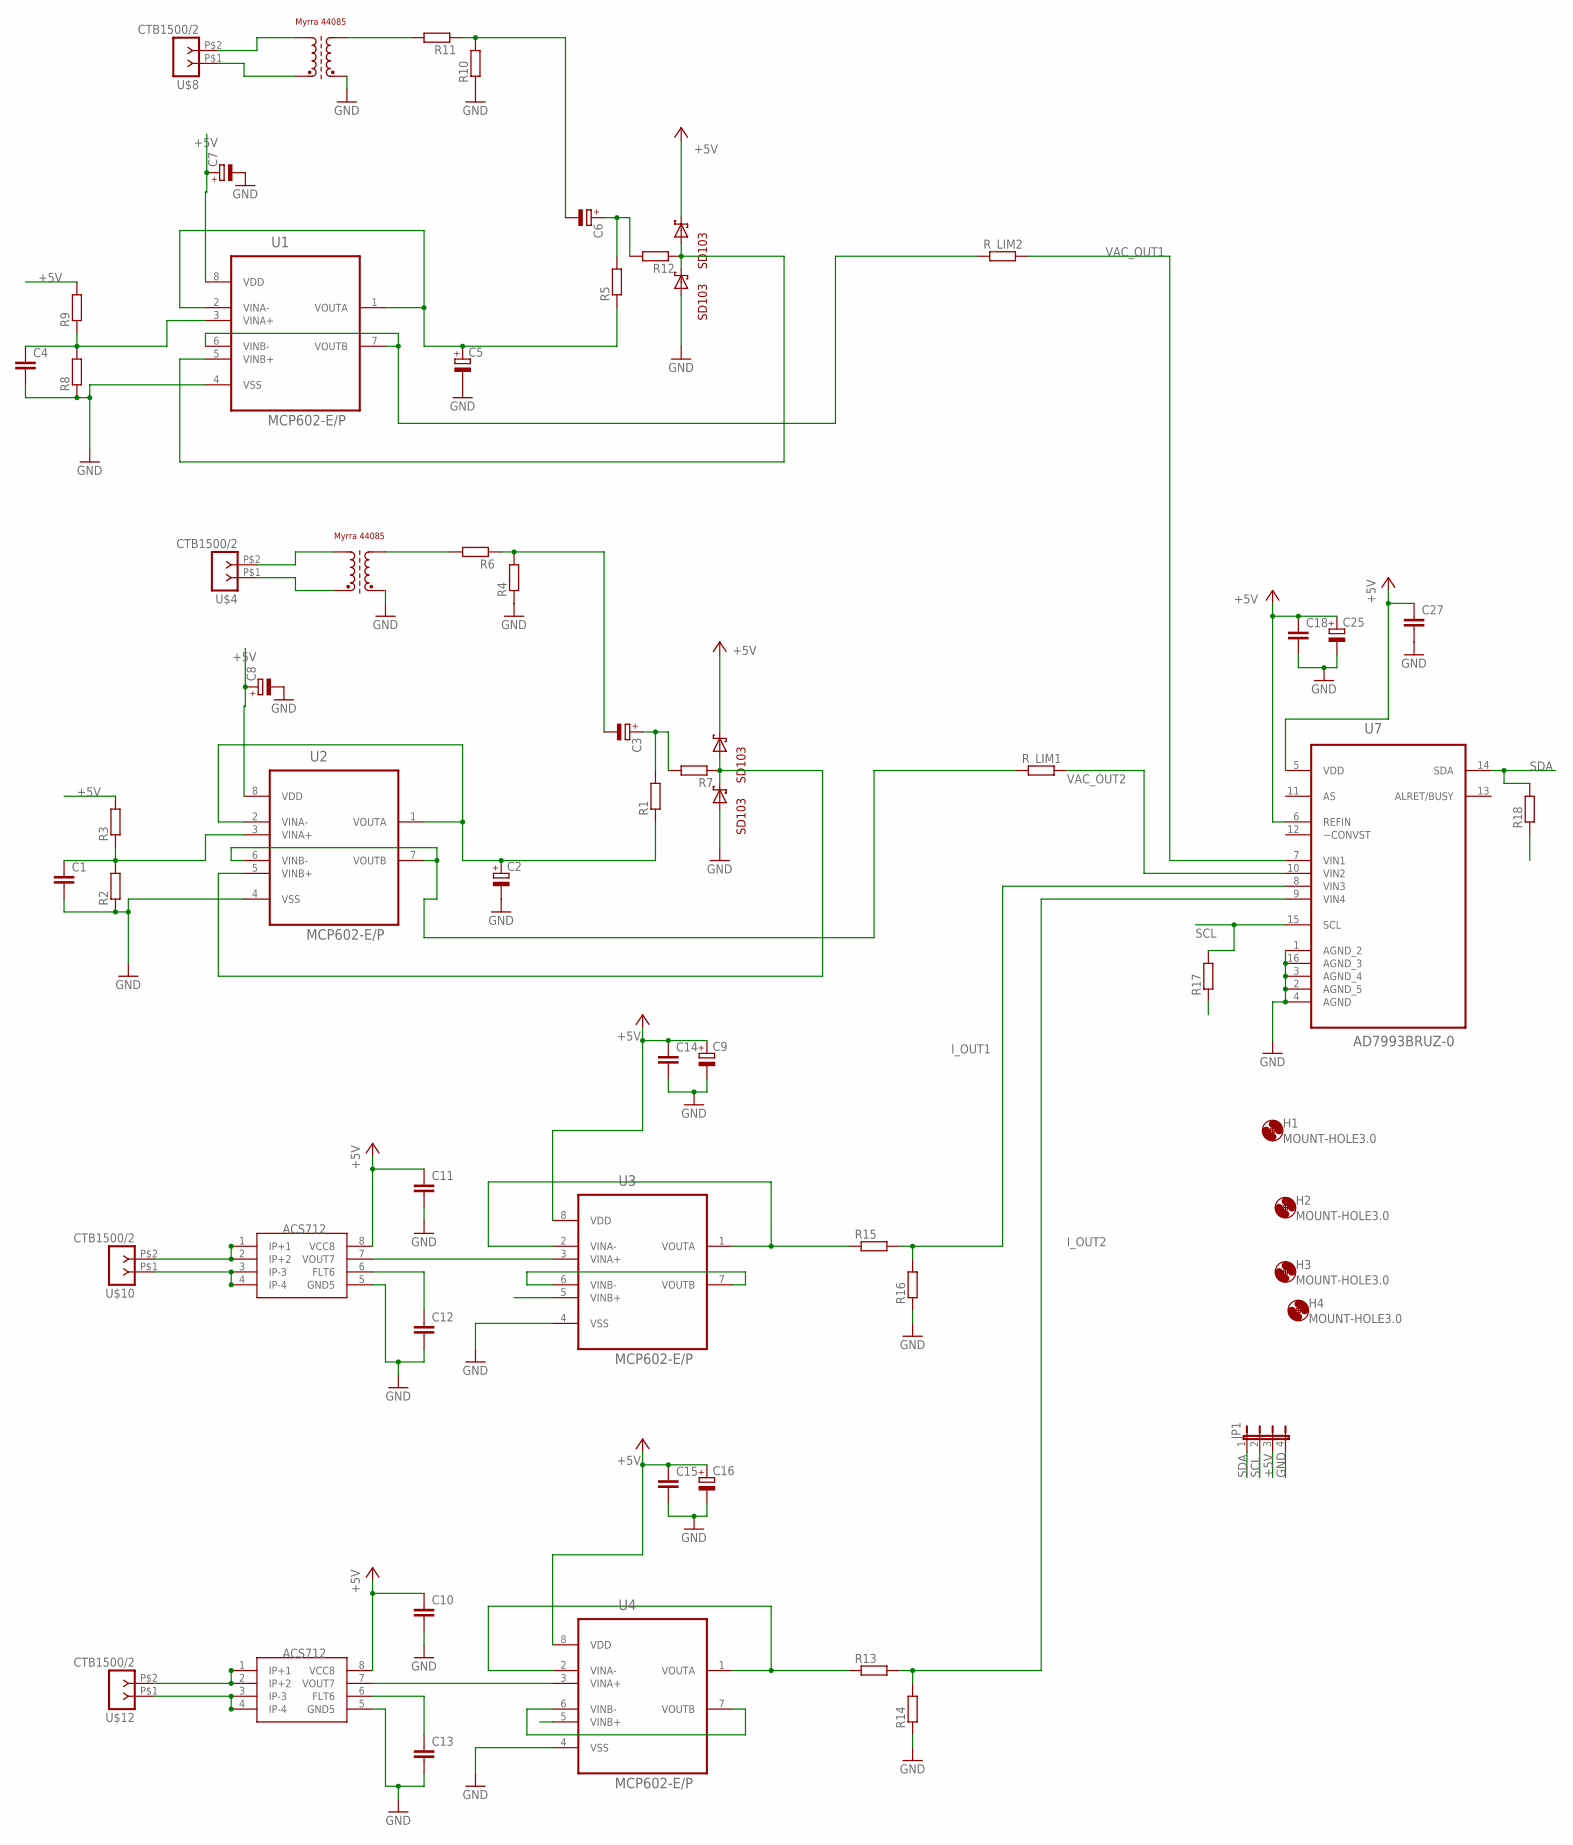
[picture p85: schematic ACBoard.sch]

Parts:
C1, C4: C5P; C050-030-075
C2, C3, C5, C6, C7, C8: CPOL1; E2,5-7---100UF
C9, C16, C25: CPOL-EUE2-4; E2-4
C10, C11, C12, C13, C14, C15, C18: C-EU025-024X044; C025-024X044
C27: C-EU025-025X050; C025-025X050
H1, H2, H3, H4: MOUNT-HOLE3.0; 3,0
JP1: JP4E; JP4
R1, R2, R3, R4, R5, R6, R7, R8, R9, R10, R11, R12: R; 0207/10
R13, R14, R15, R16, R17, R18: R-EU_0207/7; 0207/7
R_LIM1, R_LIM2: R; 0207/10
U1, U2, U3, U4: MCP602-E/P; DIP254P762X508-8P
U7: AD7993BRUZ-0; SOP65P640X120-16N
U$1, U$5: MYRRA_4408; 4408
U$2, U$3, U$6, U$7: SD103A; D035-10
U$4, U$8, U$10, U$12: CTB1500/2; CTB1500-2
U$9, U$11: ACS712; SO8

Connections:
+5V: C7.+, C8.+, C9.+, C10.1, C11.1, C14.1, C15.1, C16.+, C18.1, C25.+, C27.1, JP1.3, R3.2, R9.2, R17.1, R18.1, U1.8 (VDD), U2.8 (VDD), U3.8 (VDD), U4.8 (VDD), U7.5 (VDD), U7.6 (REFIN), U$2.C, U$6.C, U$9.8 (VCC8), U$11.8 (VCC8)
GND: C1.2, C2.-, C4.2, C5.-, C7.-, C8.-, C9.-, C10.2, C11.2, C12.2, C13.2, C14.2, C15.2, C16.-, C18.2, C25.-, C27.2, JP1.4, R2.1, R4.1, R8.1, R10.1, R14.1, R16.1, U1.4 (VSS), U2.4 (VSS), U3.4 (VSS), U3.5 (VINB+), U4.4 (VSS), U4.5 (VINB+), U7.1 (AGND_2), U7.2 (AGND_5), U7.3 (AGND_4), U7.4 (AGND), U7.16 (AGND_3), U$1.PIN9 (E2), U$3.A, U$5.PIN9 (E2), U$7.A, U$9.5 (GND5), U$11.5 (GND5)
IOUTOP: R15.1, U3.1 (VOUTA), U3.2 (VINA-)
IOUTOP2: R13.1, U4.1 (VOUTA), U4.2 (VINA-)
I_OUT1: R15.2, R16.2, U7.8 (VIN3)
I_OUT2: R13.2, R14.2, U7.9 (VIN4)
unnamed: R_LIM2.1, U1.6 (VINB-), U1.7 (VOUTB)
unnamed: C5.+, R5.1, U1.1 (VOUTA), U1.2 (VINA-)
unnamed: C1.1, R2.2, R3.1, U2.3 (VINA+)
unnamed: R7.1, U2.5 (VINB+), U$2.A, U$3.C
unnamed: C3.-, R4.2, R6.1
unnamed: U$9.3 (IP-3), U$9.4 (IP-4), U$10.P$1 (1)
unnamed: R6.2, U$1.PIN7 (A2)
unnamed: C12.1, U$9.6 (FLT6)
unnamed: C3.+, R1.2, R7.2
unnamed: C4.1, R8.2, R9.1, U1.3 (VINA+)
unnamed: U$5.PIN5 (A1), U$8.P$2 (2)
unnamed: R12.1, U1.5 (VINB+), U$6.A, U$7.C
unnamed: C2.+, R1.1, U2.1 (VOUTA), U2.2 (VINA-)
unnamed: R_LIM1.1, U2.6 (VINB-), U2.7 (VOUTB)
unnamed: U$5.PIN1 (E1), U$8.P$1 (1)
unnamed: U3.3 (VINA+), U$9.7 (VOUT7)
unnamed: C6.-, R10.2, R11.1
unnamed: R11.2, U$5.PIN7 (A2)
unnamed: U$1.PIN5 (A1), U$4.P$2 (2)
unnamed: U$9.1 (IP+1), U$9.2 (IP+2), U$10.P$2 (2)
unnamed: C6.+, R5.2, R12.2
unnamed: U$11.3 (IP-3), U$11.4 (IP-4), U$12.P$1 (1)
unnamed: C13.1, U$11.6 (FLT6)
unnamed: U4.3 (VINA+), U$11.7 (VOUT7)
unnamed: U$11.1 (IP+1), U$11.2 (IP+2), U$12.P$2 (2)
unnamed: U$1.PIN1 (E1), U$4.P$1 (1)
unnamed: U4.6 (VINB-), U4.7 (VOUTB)
unnamed: U3.6 (VINB-), U3.7 (VOUTB)
SCL: JP1.2, R17.2, U7.15 (SCL)
SDA: JP1.1, R18.2, U7.14 (SDA)
VAC_OUT1: R_LIM2.2, U7.7 (VIN1)
VAC_OUT2: R_LIM1.2, U7.10 (VIN2)

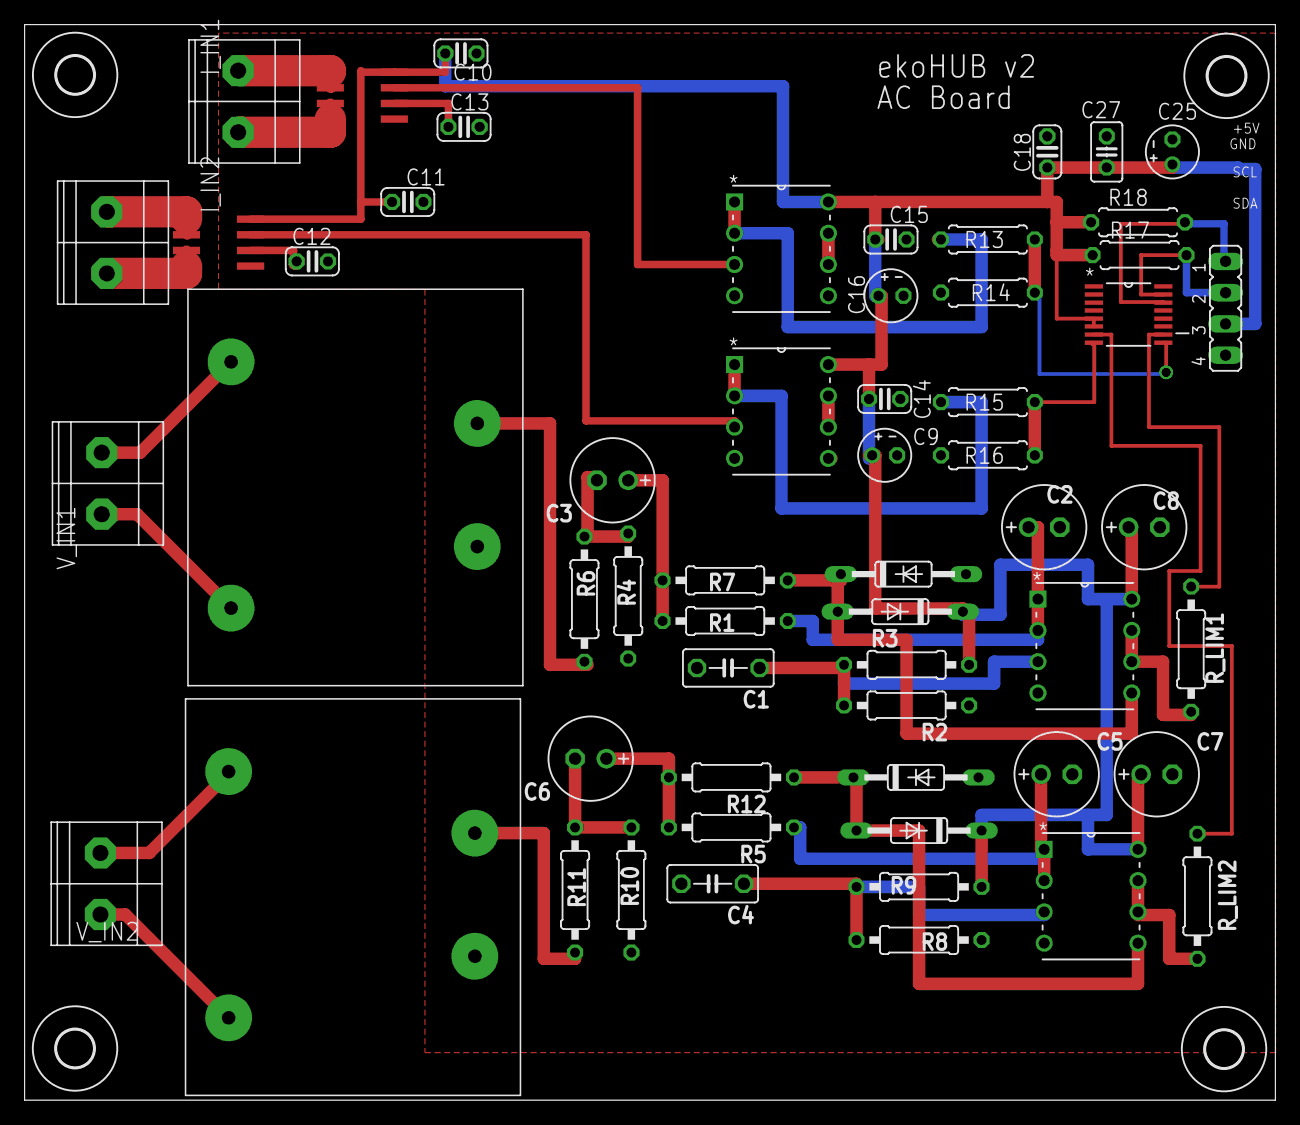
[picture p86: board ACBoard.brd from above]

Board: 2 copper layers, 101.6 x 87.4 mm, 61 parts (0 on the bottom side), 38 nets.
