equinoxorg/ekoHub/2012-2013/Hardware/PCB/JulyTest/Current Sensor/Current.brd

## EAGLE design 2012-2013/Hardware/PCB/JulyTest/Current Sensor/Current.brd (2015-01-14)

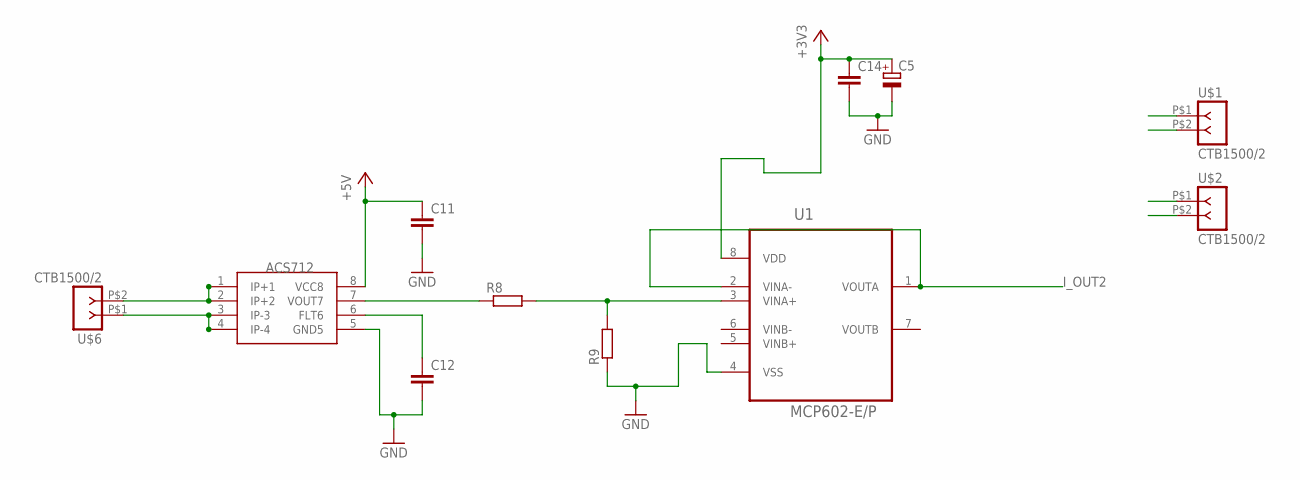
[picture p87: schematic Current.sch]

Parts:
C5: CPOL-EUE2-4; E2-4
C11, C12, C14: C-EU025-024X044; C025-024X044
R8, R9: R-EU_0207/7; 0207/7
U1: MCP602-E/P; DIP254P762X508-8P
U$1, U$2, U$6: CTB1500/2; CTB1500-2
U$5: ACS712; SO8

Connections:
+3V3: C5.+, C14.1, U1.8 (VDD), U$1.P$2 (2)
+5V: C11.1, U$1.P$1 (1), U$5.8 (VCC8)
GND: C5.-, C11.2, C12.2, C14.2, R9.1, U1.4 (VSS), U$2.P$1 (1), U$5.5 (GND5)
I_OUT2: U1.2 (VINA-), U$2.P$2 (2)
unnamed: R8.1, U$5.7 (VOUT7)
unnamed: U$5.3 (IP-3), U$5.4 (IP-4), U$6.P$1 (1)
unnamed: C12.1, U$5.6 (FLT6)
unnamed: U$5.1 (IP+1), U$5.2 (IP+2), U$6.P$2 (2)
unnamed: R8.2, R9.2, U1.3 (VINA+)

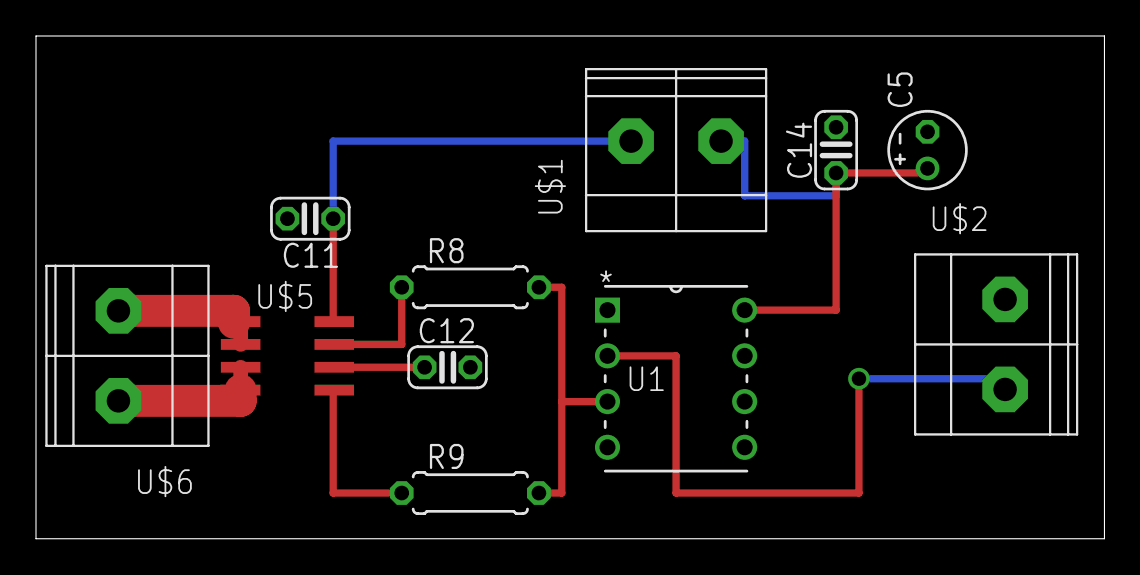
[picture p88: board Current.brd from above]

Board: 2 copper layers, 59.4 x 27.9 mm, 11 parts (0 on the bottom side), 9 nets.
