equinoxorg/ekoHub/2012-2013/Hardware/PCB/Test Board (4 sensors)/test_sensors/test_sensors/testv3.brd

## EAGLE design 2012-2013/Hardware/PCB/Test Board (4 sensors)/test_sensors/test_sensors/testv3.brd (2015-01-14)

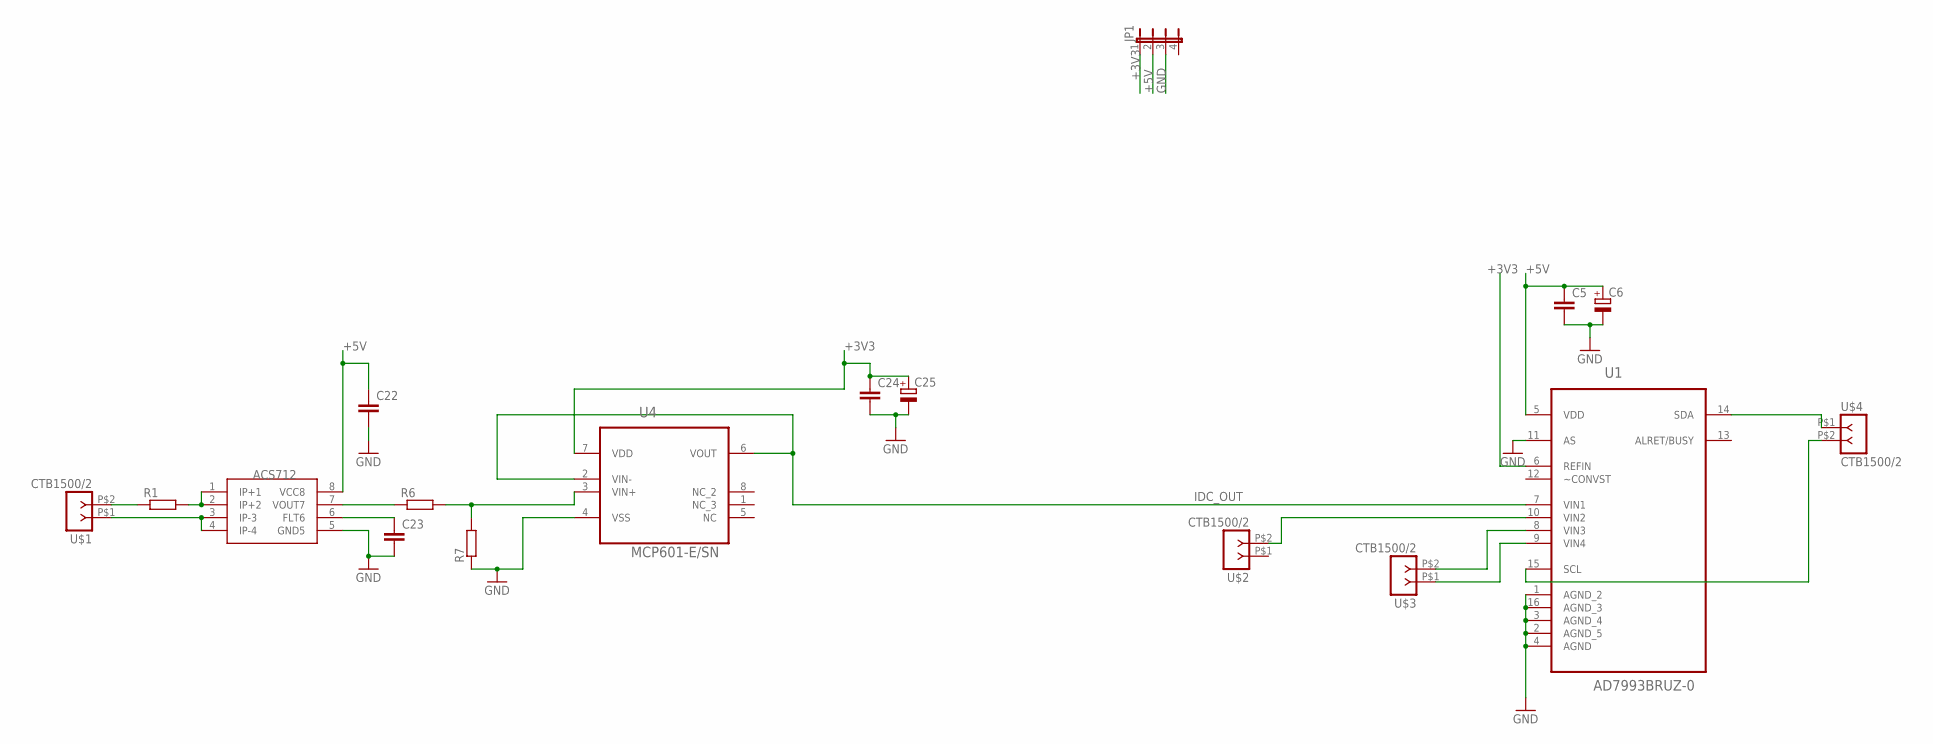
[picture p89: schematic testv3.sch]

Parts:
C5, C22, C23, C24: C-EU025-025X050; C025-025X050
C6, C25: CPOL-EUE2-4; E2-4
JP1: JP4E; JP4
R1, R6, R7: R-EU_0207/7; 0207/7
U1: AD7993BRUZ-0; SOP65P640X120-16N
U4: MCP601-E/SN; SOIC127P600X175-8N
U$1, U$2, U$3, U$4: CTB1500/2; CTB1500-2
U$10: ACS712; SOIC8

Connections:
+3V3: C24.1, C25.+, JP1.1, U1.6 (REFIN), U4.7 (VDD)
+5V: C5.1, C6.+, C22.1, JP1.2, U1.5 (VDD), U$10.8 (VCC8)
GND: C5.2, C6.-, C22.2, C23.2, C24.2, C25.-, JP1.3, R7.1, U1.1 (AGND_2), U1.2 (AGND_5), U1.3 (AGND_4), U1.4 (AGND), U1.11 (AS), U1.16 (AGND_3), U4.4 (VSS), U$10.5 (GND5)
IDC_OUT: U1.7 (VIN1), U4.2 (VIN-), U4.6 (VOUT)
unnamed: U1.9 (VIN4), U$3.P$1 (1)
unnamed: U1.8 (VIN3), U$3.P$2 (2)
unnamed: R1.1, U$1.P$2 (2)
unnamed: R1.2, U$10.1 (IP+1), U$10.2 (IP+2)
unnamed: U$1.P$1 (1), U$10.3 (IP-3), U$10.4 (IP-4)
unnamed: R6.1, U$10.7 (VOUT7)
unnamed: C23.1, U$10.6 (FLT6)
unnamed: R6.2, R7.2, U4.3 (VIN+)
unnamed: U1.14 (SDA), U$4.P$1 (1)
SCL: U1.15 (SCL), U$4.P$2 (2)
VDC_OUT: U1.10 (VIN2), U$2.P$2 (2)

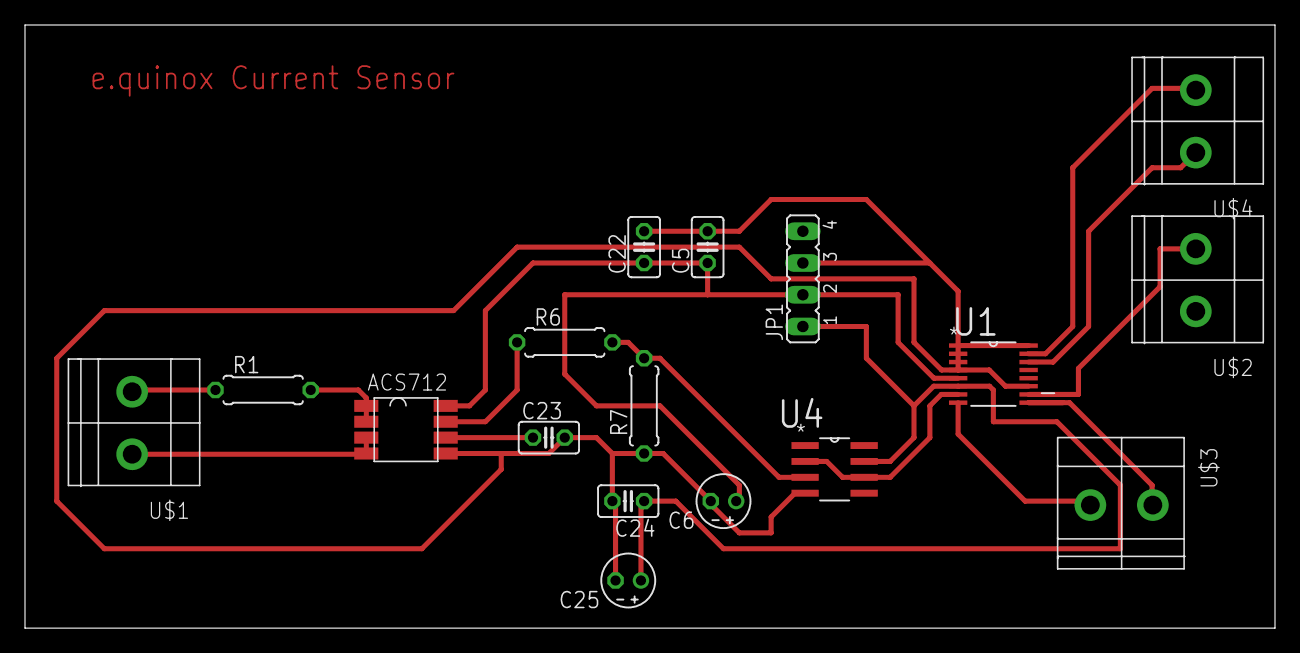
[picture p90: board testv3.brd from above]

Board: 2 copper layers, 100.0 x 48.2 mm, 17 parts (0 on the bottom side), 15 nets.
