equinoxorg/ekoHub/2013-2014/Hardware/Sensor Boards/DCVoltage/DCVoltageV1/VDC.brd

## EAGLE design 2013-2014/Hardware/Sensor Boards/DCVoltage/DCVoltageV1/VDC.brd (2015-01-14, an earlier design)

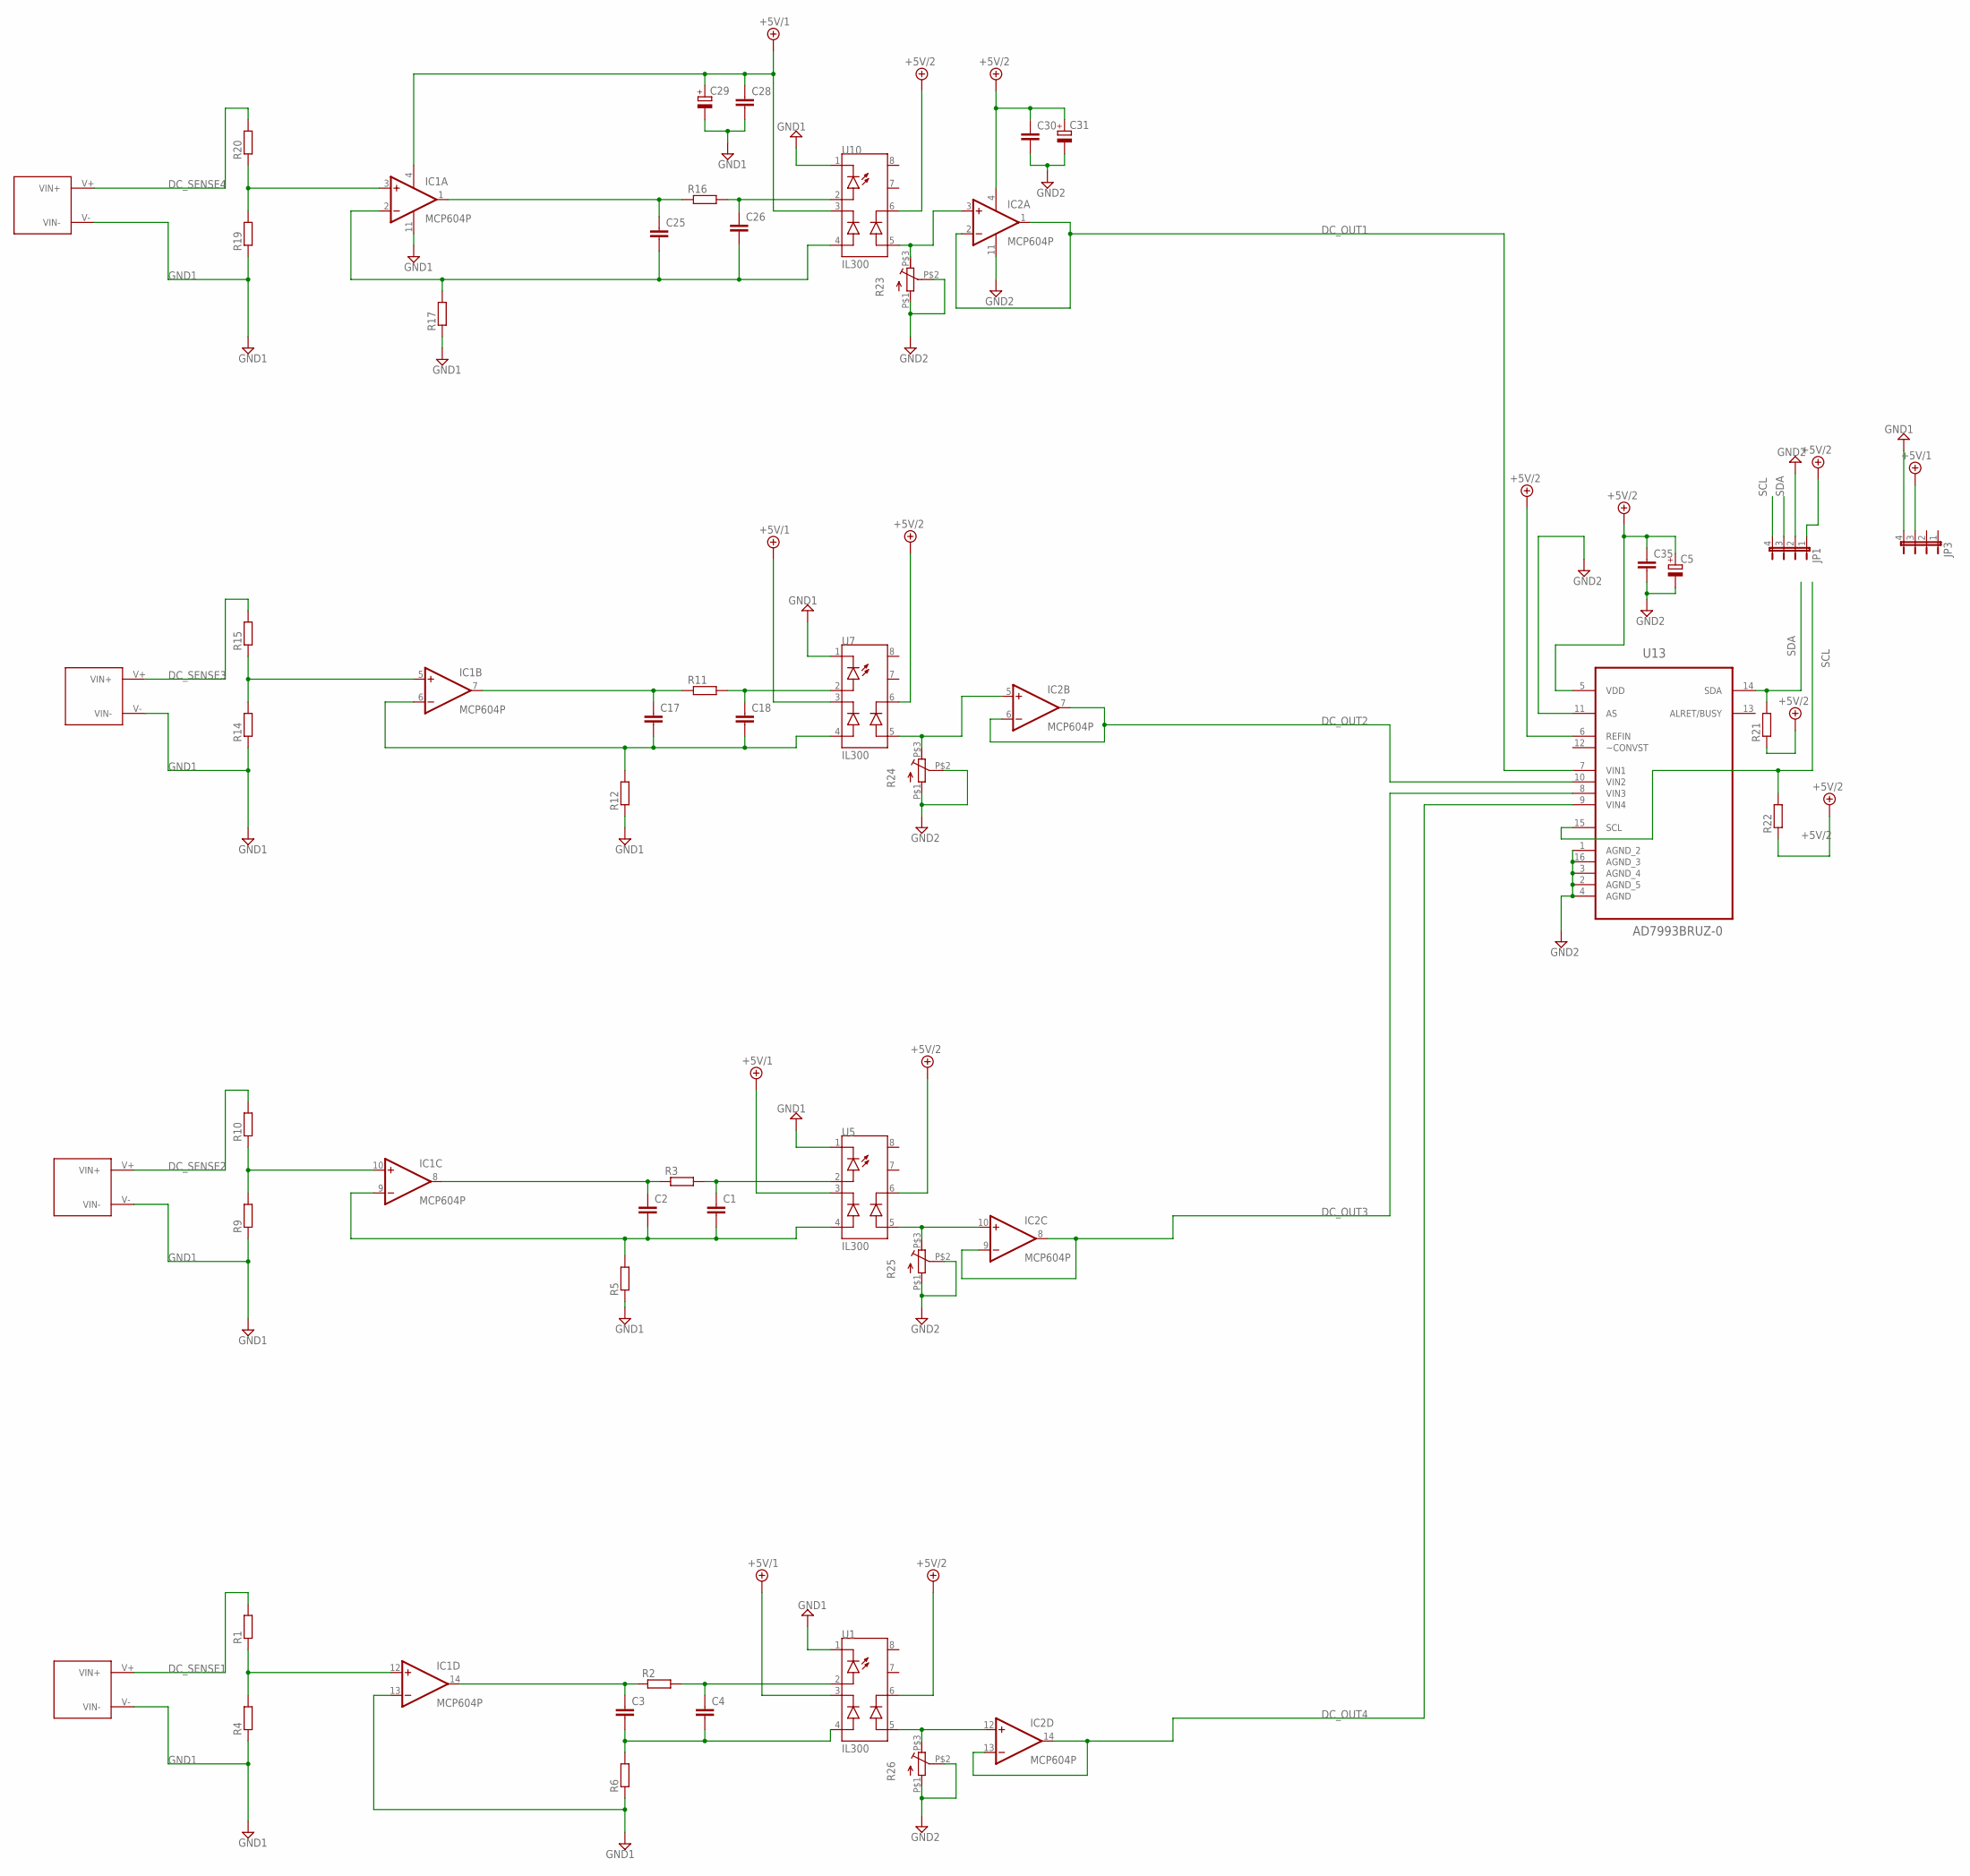
[picture p91: schematic VDC.sch]

Parts:
C1, C2, C3, C4, C17, C18, C25, C26, C28, C30: C-EU025-040X050; C025-040X050
C5: CPOL-EUE2-4; E2-4
C29, C31: CPOL-EUE2-5; E2-5
C35: C-EU025-025X050; C025-025X050
IC1, IC2: MCP604P; DIL14
JP1, JP3: JP4E; JP4
R1, R2, R3, R4, R5, R6, R9, R10, R11, R12, R14, R15, R16, R17, R19, R20, R21, R22: R-EU_0207/10; 0207/10
R23, R24, R25, R26: R-TRIMM; IRG2014TRIM
U1, U5, U7, U10: IL300; DIL08
U13: AD7993BRUZ-0; SOP65P640X120-16N
U$5, U$6, U$7, U$8: INPUT_VOLTAGE_CONNECTOR

Connections:
+5V/1: C28.1, C29.+, IC1.4 (V+), JP3.3, U1.3 (C_FB), U5.3 (C_FB), U7.3 (C_FB), U10.3 (C_FB)
+5V/2: C5.+, C30.1, C31.+, C35.1, IC2.4 (V+), JP1.1, R21.1, R22.1, U1.6 (C_OUT), U5.6 (C_OUT), U7.6 (C_OUT), U10.6 (C_OUT), U13.5 (VDD), U13.6 (REFIN)
DC_OUT1: IC2.1 (OUT), IC2.2 (-IN), U13.7 (VIN1)
DC_OUT2: IC2.6 (-IN), IC2.7 (OUT), U13.10 (VIN2)
DC_OUT3: IC2.8 (OUT), IC2.9 (-IN), U13.8 (VIN3)
DC_OUT4: IC2.13 (-IN), IC2.14 (OUT), U13.9 (VIN4)
DC_SENSE1: R1.2, U$8.V+ (VIN+)
DC_SENSE2: R10.2, U$7.V+ (VIN+)
DC_SENSE3: R15.2, U$6.V+ (VIN+)
DC_SENSE4: R20.2, U$5.V+ (VIN+)
GND1: C28.2, C29.-, IC1.11 (V-), IC1.13 (-IN), JP3.4, R4.1, R5.1, R6.1, R9.1, R12.1, R14.1, R17.1, R19.1, U1.1 (C_LED), U5.1 (C_LED), U7.1 (C_LED), U10.1 (C_LED), U$5.V- (VIN-), U$6.V- (VIN-), U$7.V- (VIN-), U$8.V- (VIN-)
GND2: C5.-, C30.2, C31.-, C35.2, IC2.11 (V-), JP1.2, R23.P$1 (A), R23.P$2 (S), R24.P$1 (A), R24.P$2 (S), R25.P$1 (A), R25.P$2 (S), R26.P$1 (A), R26.P$2 (S), U13.1 (AGND_2), U13.2 (AGND_5), U13.3 (AGND_4), U13.4 (AGND), U13.11 (AS), U13.16 (AGND_3)
unnamed: C3.2, C4.2, R6.2, U1.4 (A_FB)
unnamed: C1.2, C2.2, IC1.9 (-IN), R5.2, U5.4 (A_FB)
unnamed: IC2.12 (+IN), R26.P$3 (E), U1.5 (A_OUT)
unnamed: C4.1, R2.2, U1.2 (A_LED)
unnamed: C3.1, IC1.14 (OUT), R2.1
unnamed: C1.1, R3.2, U5.2 (A_LED)
unnamed: C2.1, IC1.8 (OUT), R3.1
unnamed: IC1.12 (+IN), R1.1, R4.2
unnamed: IC2.10 (+IN), R25.P$3 (E), U5.5 (A_OUT)
unnamed: IC1.10 (+IN), R9.2, R10.1
unnamed: C18.1, R11.2, U7.2 (A_LED)
unnamed: C17.1, IC1.7 (OUT), R11.1
unnamed: IC2.5 (+IN), R24.P$3 (E), U7.5 (A_OUT)
unnamed: IC1.5 (+IN), R14.2, R15.1
unnamed: C25.2, C26.2, IC1.2 (-IN), R17.2, U10.4 (A_FB)
unnamed: C26.1, R16.2, U10.2 (A_LED)
unnamed: C25.1, IC1.1 (OUT), R16.1
unnamed: IC2.3 (+IN), R23.P$3 (E), U10.5 (A_OUT)
unnamed: IC1.3 (+IN), R19.2, R20.1
unnamed: C17.2, C18.2, IC1.6 (-IN), R12.2, U7.4 (A_FB)
SCL: JP1.4, R22.2, U13.15 (SCL)
SDA: JP1.3, R21.2, U13.14 (SDA)

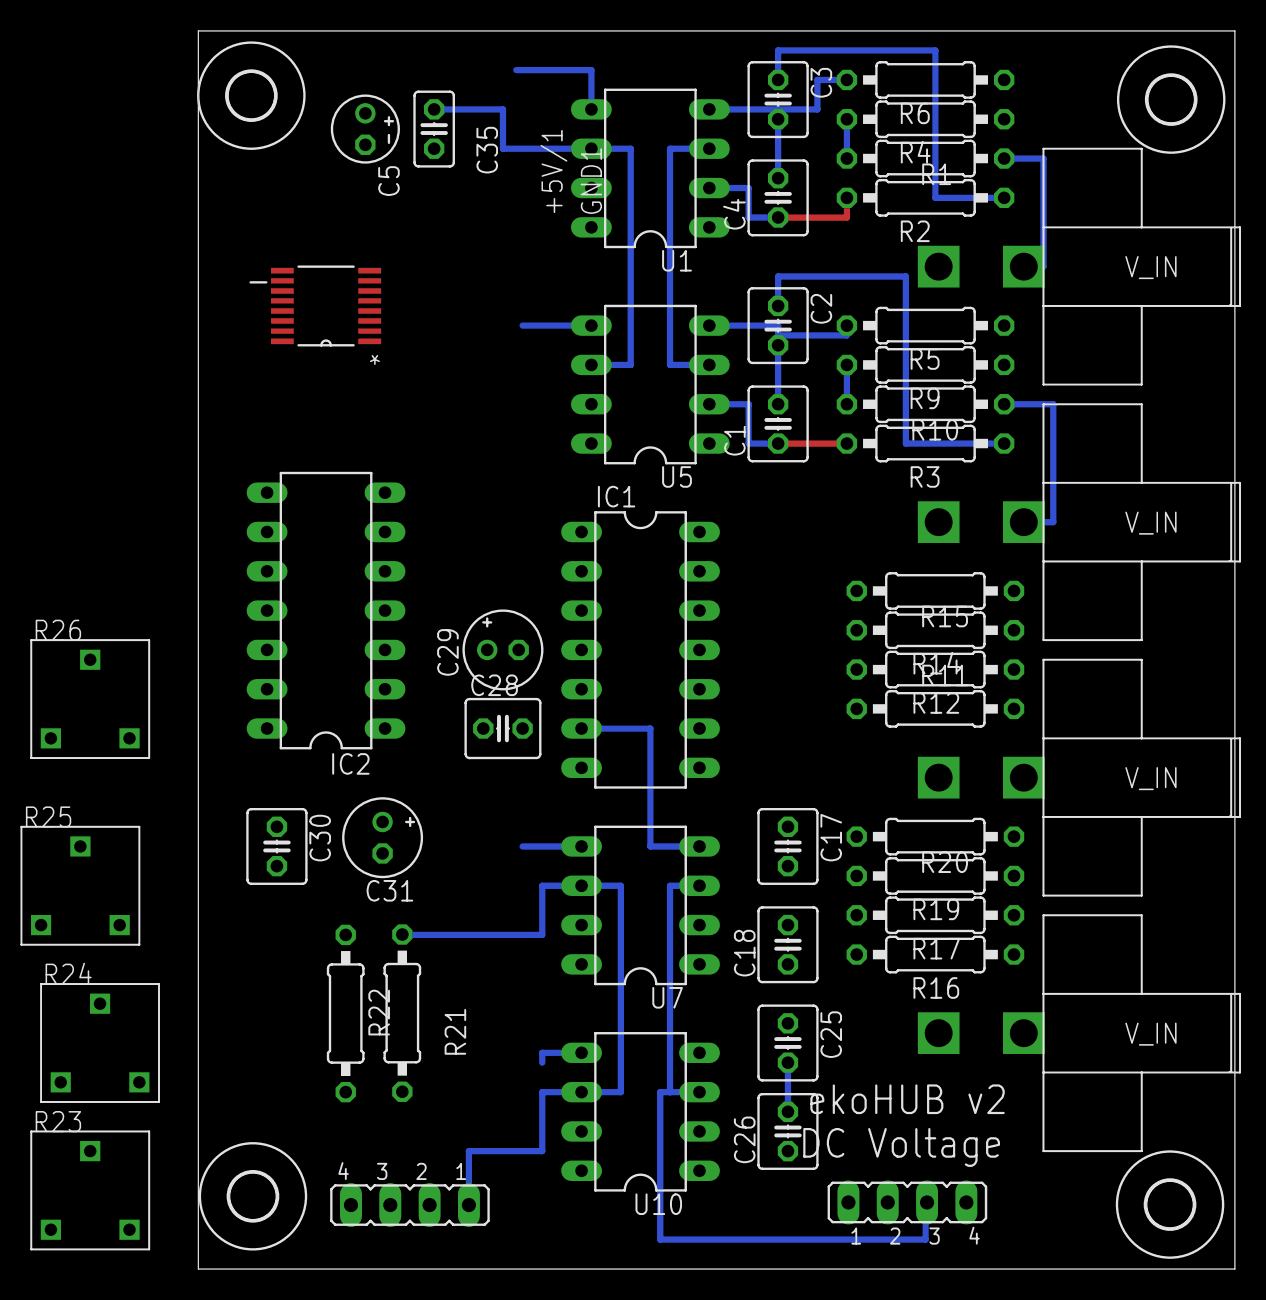
[picture p92: board 2013-2014/Hardware/Sensor Boards/DCVoltage/DCVoltageV1/VDC.brd from above]

Board: 2 copper layers, 67.0 x 80.0 mm, 53 parts (0 on the bottom side), 34 nets.

Other parts of the board:
U$1, U$2, U$3, U$4: 3,0
