equinoxorg/ekoHub/2013-2014/Hardware/Datalogging_SMD_Prototyping/Datalogging_SMD_Prototye.brd

## EAGLE design 2013-2014/Hardware/Datalogging_SMD_Prototyping/Datalogging_SMD_Prototye.brd (2015-01-14)

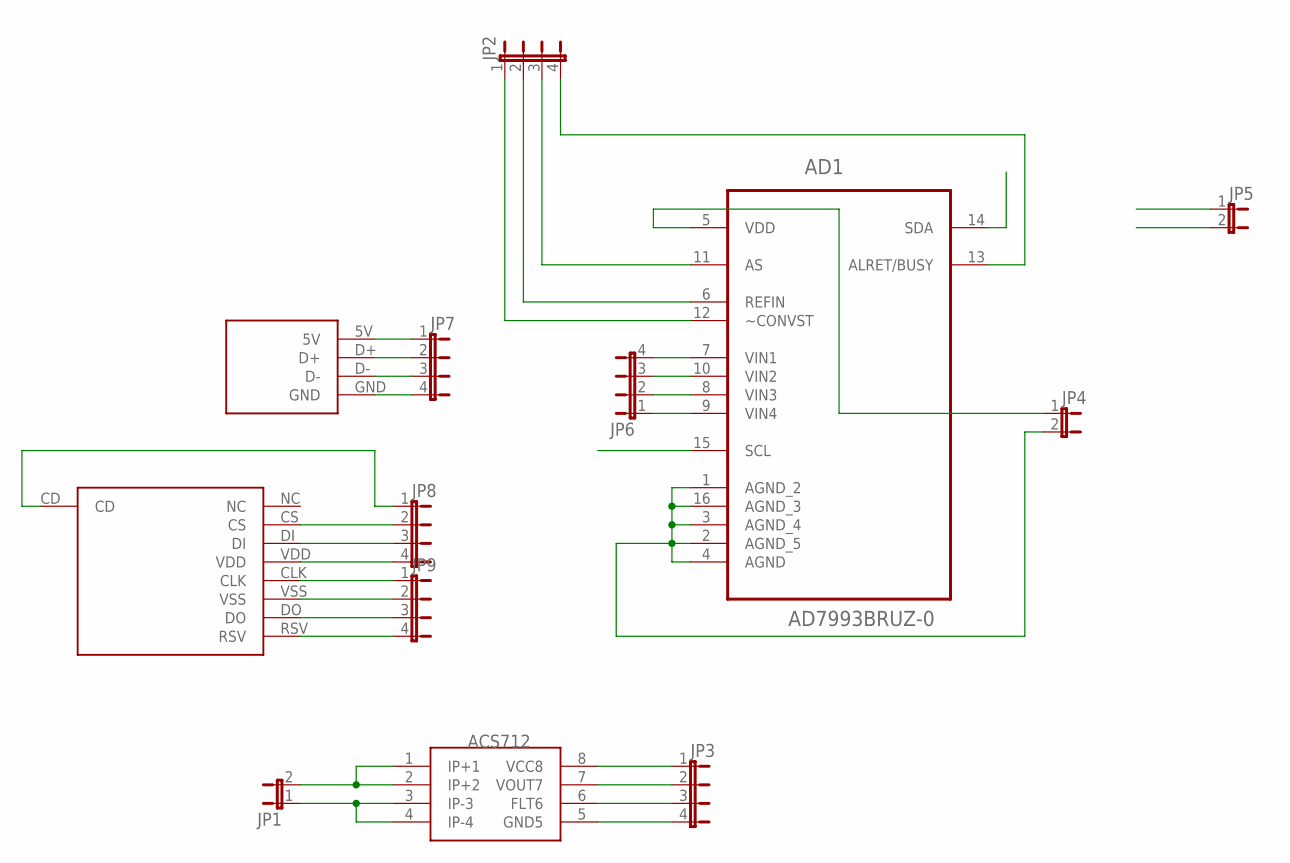
[picture p93: schematic Datalogging_SMD_Prototye.sch]

Parts:
AD1: AD7993BRUZ-0; SOP65P640X120-16N; MPN AD7993BRUZ-0
JP1, JP4, JP5: JP1E; JP1
JP2, JP3, JP6, JP7, JP8, JP9: JP4E; JP4
U$1: USBA_SOCKET
U$2: ACS712; SO8
U$3: MICROSD_SOCKET

Connections:
unnamed: JP1.1, U$2.3 (IP-3), U$2.4 (IP-4)
unnamed: JP1.2, U$2.1 (IP+1), U$2.2 (IP+2)
unnamed: AD1.5 (VDD), JP4.1
unnamed: AD1.11 (AS), JP2.3
unnamed: AD1.1 (AGND_2), AD1.2 (AGND_5), AD1.3 (AGND_4), AD1.4 (AGND), AD1.16 (AGND_3), JP4.2
unnamed: JP3.2, U$2.7 (VOUT7)
unnamed: JP3.3, U$2.6 (FLT6)
unnamed: AD1.6 (REFIN), JP2.2
unnamed: AD1.12 (~CONVST), JP2.1
unnamed: AD1.13 (ALRET/BUSY), JP2.4
unnamed: AD1.7 (VIN1), JP6.4
unnamed: AD1.10 (VIN2), JP6.3
unnamed: AD1.8 (VIN3), JP6.2
unnamed: AD1.9 (VIN4), JP6.1
unnamed: JP7.4, U$1.GND
unnamed: JP7.3, U$1.D-
unnamed: JP7.2, U$1.D+
unnamed: JP7.1, U$1.5V
unnamed: JP8.1, U$3.CD
unnamed: JP8.2, U$3.CS
unnamed: JP8.3, U$3.DI
unnamed: JP8.4, U$3.VDD
unnamed: JP9.1, U$3.CLK
unnamed: JP9.2, U$3.VSS
unnamed: JP9.3, U$3.DO
unnamed: JP9.4, U$3.RSV
unnamed: JP3.4, U$2.5 (GND5)
unnamed: JP3.1, U$2.8 (VCC8)
SCL: AD1.15 (SCL), JP5.2
SDA: AD1.14 (SDA), JP5.1

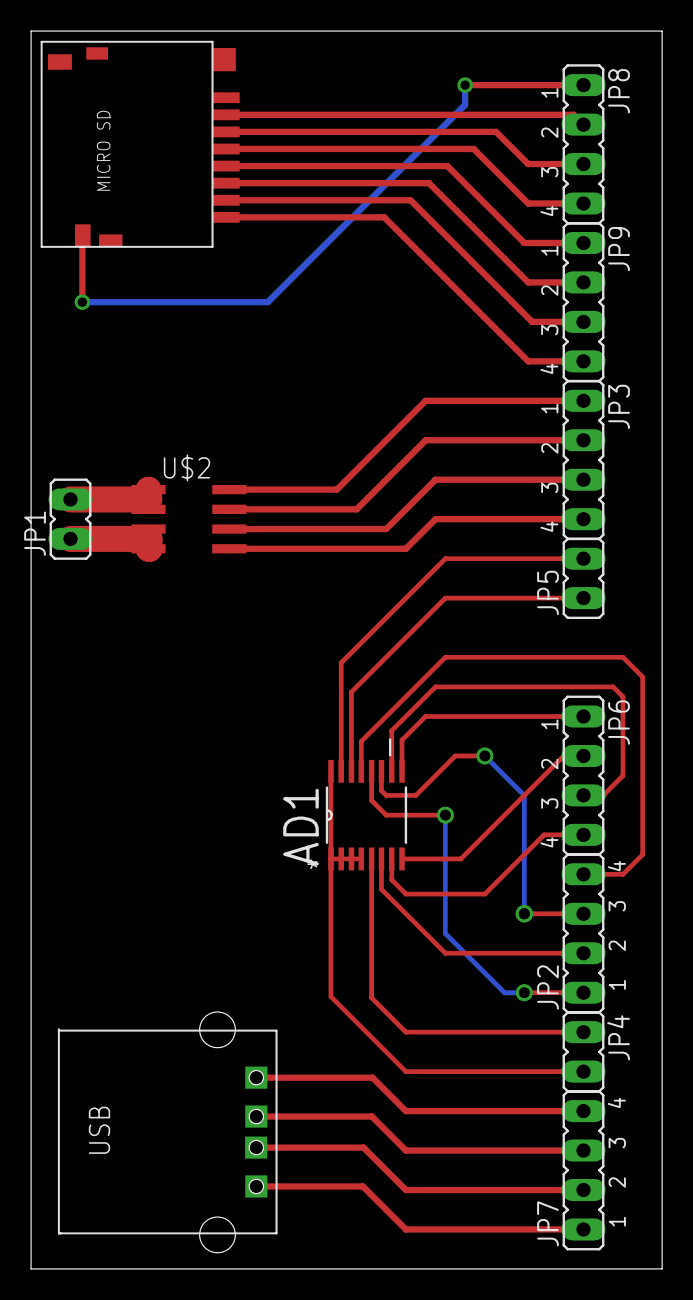
[picture p94: board Datalogging_SMD_Prototye.brd from above]

Board: 2 copper layers, 40.6 x 79.7 mm, 13 parts (0 on the bottom side), 30 nets.
