equinoxorg/ekoHub/2013-2014/Hardware/Main Board/SDCard/SDCardv1.brd

## EAGLE design 2013-2014/Hardware/Main Board/SDCard/SDCardv1.brd (2015-01-14)

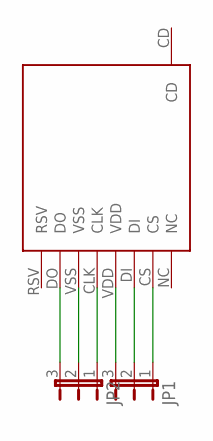
[picture p95: schematic SDCardv1.sch]

Parts:
JP1, JP2: JP2W
U$1: MICROSD_SOCKET

Connections:
unnamed: JP1.1, U$1.CS
unnamed: JP1.2, U$1.DI
unnamed: JP1.3, U$1.VDD
unnamed: JP2.1, U$1.CLK
unnamed: JP2.2, U$1.VSS
unnamed: JP2.3, U$1.DO

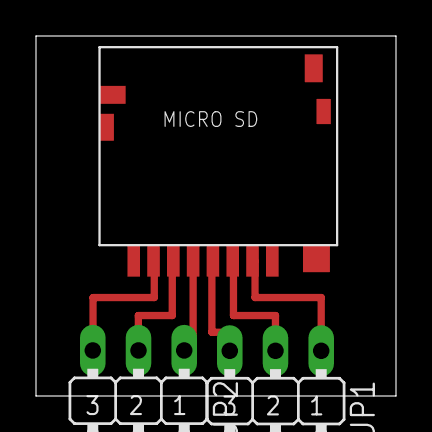
[picture p96: board SDCardv1.brd from above]

Board: 2 copper layers, 20.0 x 20.0 mm, 3 parts (0 on the bottom side), 6 nets.
