equinoxorg/ekoHub/2013-2014/Hardware/Main Board/Main_Board_v1/Main_Board.brd

## EAGLE design 2013-2014/Hardware/Main Board/Main_Board_v1/Main_Board.brd (2015-01-14, an earlier design)

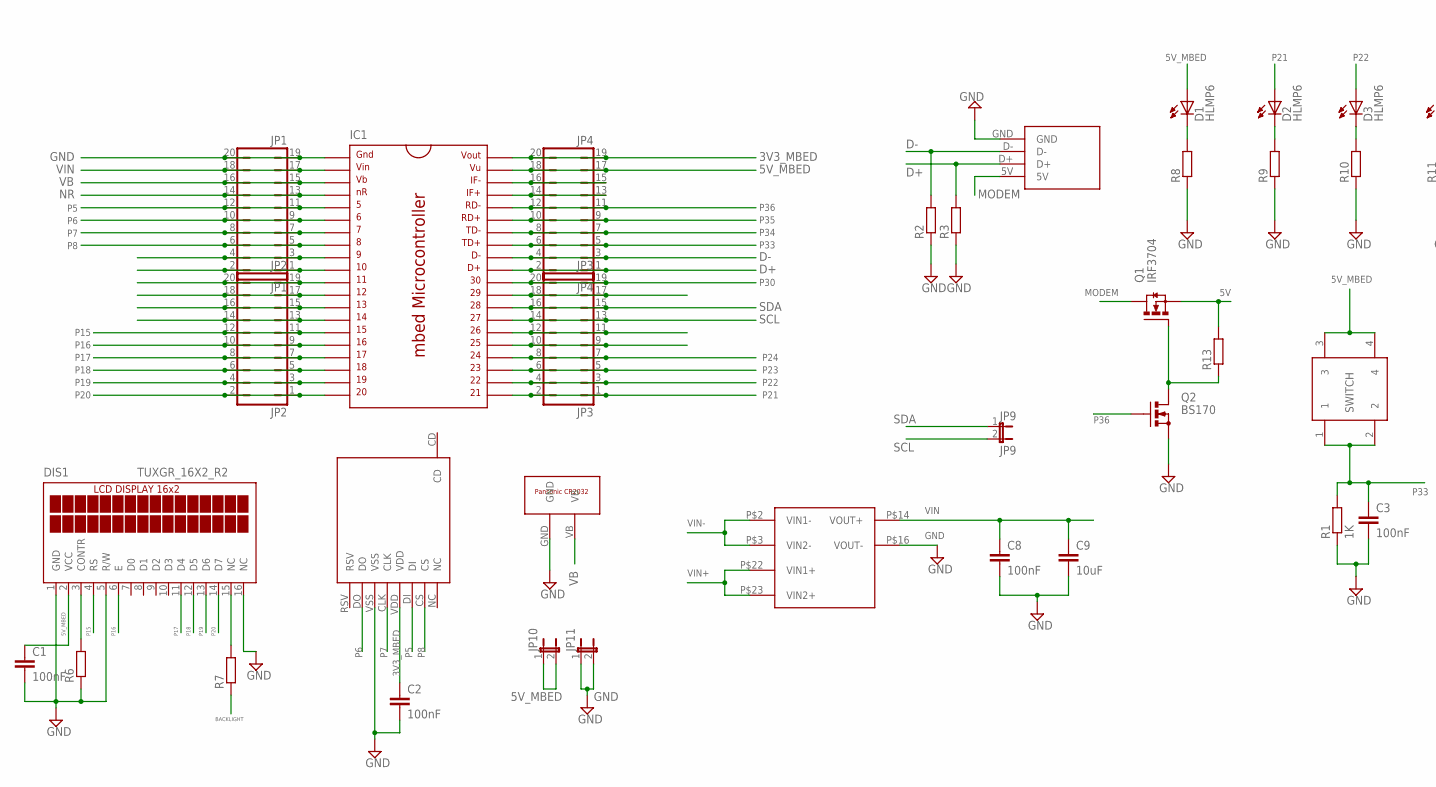
[picture p97: schematic Main_Board.sch, part in row 1, column 1]

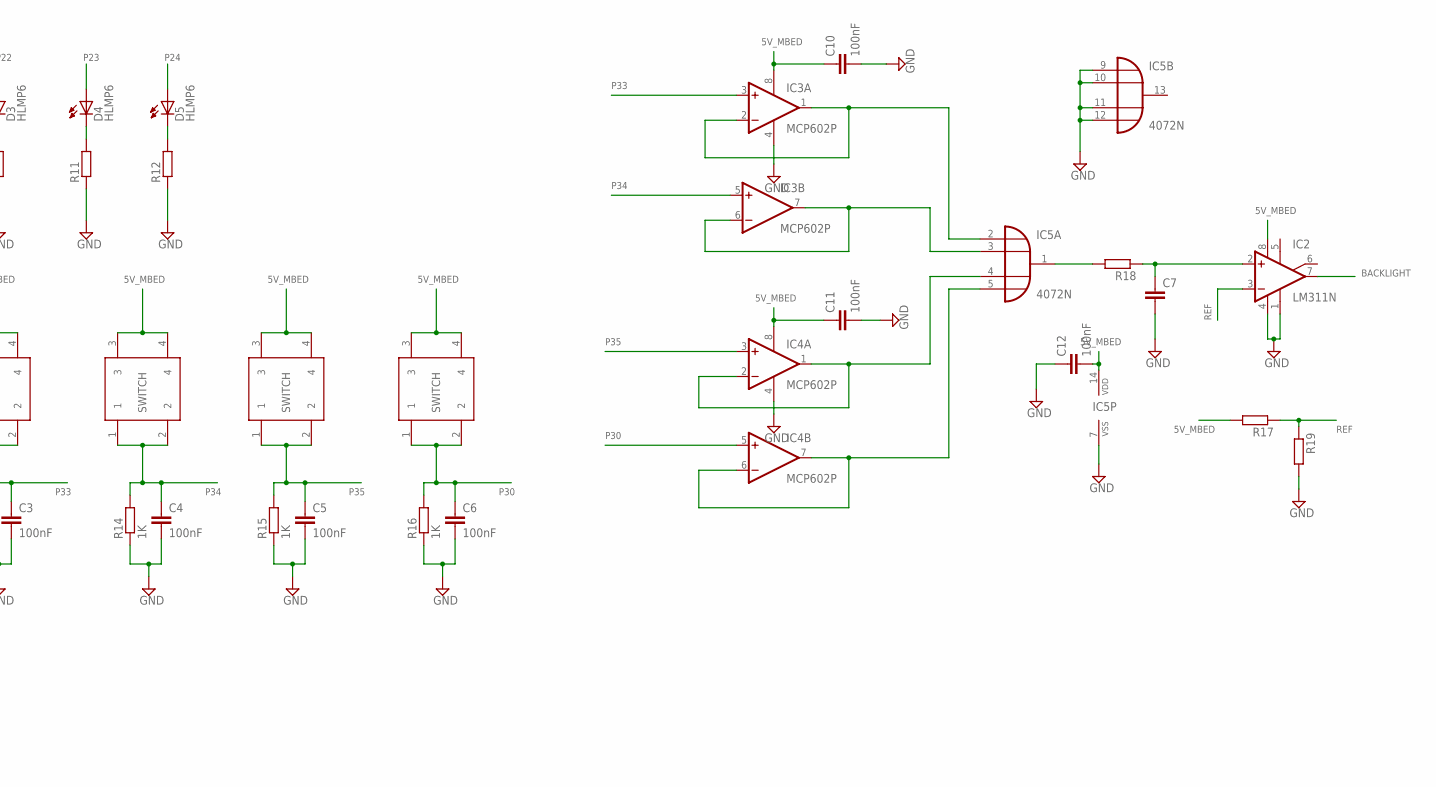
[picture p98: schematic Main_Board.sch, part in row 1, column 2]

Parts:
C1, C2, C3, C4, C5, C6, C8, C10, C11, C12: 100nF; C5B3
C7: C5/3; C5B3
C9: 10uF; C5B3
D1, D2, D3, D4, D5: HLMP6
DIS1: TUXGR_16X2_R2
IC1: MBED_MICROCONTROLLER; DIL40_0.9
IC2: LM311N; DIL08
IC3, IC4: MCP602P; DIL08
IC5: 4072N; DIL14
JP1: JP1; JP10Q
JP2: JP2; JP10Q
JP3: JP3; JP10Q
JP4: JP4; JP10Q
JP9: JP9; JP1
JP10, JP11: JP1E; JP1
POWER_SUPPLY: TRACO_ISOLATED_SUPPLY
Q1: IRF3704; TO220AH
Q2: BS170; SOT54E
R1, R14, R15, R16: 1K; 0411/12
R2, R3, R6, R7, R8, R9, R10, R11, R12, R13, R17, R18, R19: R-EU_0411/12; 0411/12
U$1: USBA_SOCKET
U$2: MICROSD_SOCKET
U$3: PANASONIC_CR2032
U$5, U$6, U$7, U$8: TACT_SWITCH

Connections:
3V3_MBED: C2.1, IC1.40, JP4.19, JP4.20, U$2.VDD
5V: Q1.E (S), R13.2
5V_MBED: C1.1, C10.1, C11.1, C12.2, D1.A, DIS1.2 (VCC), IC1.39, IC2.8 (V+), IC3.8 (V+), IC4.8 (V+), IC5.14 (VDD), JP4.17, JP4.18, JP10.1, JP10.2, R17.2, U$5.3, U$5.4, U$6.3, U$6.4, U$7.3, U$7.4, U$8.3, U$8.4
BACKLIGHT: IC2.7 (OUT), R7.1
D+: IC1.31, JP4.1, JP4.2, R3.2, U$1.D+
D-: IC1.32, JP4.3, JP4.4, R2.2, U$1.D-
GND: C1.2, C2.2, C3.2, C4.2, C5.2, C6.2, C7.2, C8.2, C9.2, C10.2, C11.2, C12.1, DIS1.1 (GND), DIS1.5 (R/W), DIS1.16 (NC), IC1.1, IC2.1 (GND), IC2.4 (V-), IC3.4 (V-), IC4.4 (V-), IC5.7 (VSS), IC5.9 (I0), IC5.10 (I1), IC5.11 (I2), IC5.12 (I3), JP1.19, JP1.20, JP11.1, JP11.2, POWER_SUPPLY.P$16 (VOUT-), Q2.S, R1.1, R2.1, R3.1, R6.1, R8.1, R9.1, R10.1, R11.1, R12.1, R14.1, R15.1, R16.1, R19.2, U$1.GND, U$2.VSS, U$3.GND
MODEM: Q1.C (D), U$1.5V
unnamed: D1.K, R8.2
unnamed: DIS1.3 (CONTR), R6.2
unnamed: D2.K, R9.2
unnamed: Q1.B (G), Q2.D, R13.1
unnamed: IC3.1 (OUT), IC3.2 (-IN), IC5.2 (I0)
unnamed: IC3.6 (-IN), IC3.7 (OUT), IC5.3 (I1)
unnamed: IC4.1 (OUT), IC4.2 (-IN), IC5.4 (I2)
unnamed: IC1.9, JP1.3, JP1.4
unnamed: IC1.10, JP1.1, JP1.2
unnamed: IC1.11, JP2.19, JP2.20
unnamed: IC1.12, JP2.17, JP2.18
unnamed: IC1.13, JP2.15, JP2.16
unnamed: IC1.14, JP2.13, JP2.14
unnamed: D3.K, R10.2
unnamed: D4.K, R11.2
unnamed: D5.K, R12.2
unnamed: IC4.6 (-IN), IC4.7 (OUT), IC5.5 (I3)
unnamed: C7.1, IC2.2 (+IN), R18.1
unnamed: IC5.1 (O), R18.2
unnamed: IC1.38, JP4.15, JP4.16
unnamed: IC1.37, JP4.13, JP4.14
unnamed: IC1.29, JP3.17, JP3.18
unnamed: IC1.26, JP3.11, JP3.12
unnamed: IC1.25, JP3.9, JP3.10
unnamed: DIS1.15 (NC), R7.2
NR: IC1.4, JP1.13, JP1.14
P5: IC1.5, JP1.11, JP1.12, U$2.DI
P6: IC1.6, JP1.9, JP1.10, U$2.DO
P7: IC1.7, JP1.7, JP1.8, U$2.CLK
P8: IC1.8, JP1.5, JP1.6, U$2.CS
P15: DIS1.4 (RS), IC1.15, JP2.11, JP2.12
P16: DIS1.6 (E), IC1.16, JP2.9, JP2.10
P17: DIS1.11 (D4), IC1.17, JP2.7, JP2.8
P18: DIS1.12 (D5), IC1.18, JP2.5, JP2.6
P19: DIS1.13 (D6), IC1.19, JP2.3, JP2.4
P20: DIS1.14 (D7), IC1.20, JP2.1, JP2.2
P21: D2.A, IC1.21, JP3.1, JP3.2
P22: D3.A, IC1.22, JP3.3, JP3.4
P23: D4.A, IC1.23, JP3.5, JP3.6
P24: D5.A, IC1.24, JP3.7, JP3.8
P30: C6.1, IC1.30, IC4.5 (+IN), JP3.19, JP3.20, R16.2, U$8.1, U$8.2
P33: C3.1, IC1.33, IC3.3 (+IN), JP4.5, JP4.6, R1.2, U$5.1, U$5.2
P34: C4.1, IC1.34, IC3.5 (+IN), JP4.7, JP4.8, R14.2, U$6.1, U$6.2
P35: C5.1, IC1.35, IC4.3 (+IN), JP4.9, JP4.10, R15.2, U$7.1, U$7.2
P36: IC1.36, JP4.11, JP4.12, Q2.G
REF: IC2.3 (-IN), R17.1, R19.1
SCL: IC1.27, JP3.13, JP3.14, JP9.2
SDA: IC1.28, JP3.15, JP3.16, JP9.1
VB: IC1.3, JP1.15, JP1.16, U$3.VB
VIN: C8.1, C9.1, IC1.2, JP1.17, JP1.18, POWER_SUPPLY.P$14 (VOUT+)
VIN+: POWER_SUPPLY.P$22 (VIN1+), POWER_SUPPLY.P$23 (VIN2+)
VIN-: POWER_SUPPLY.P$2 (VIN1-), POWER_SUPPLY.P$3 (VIN2-)

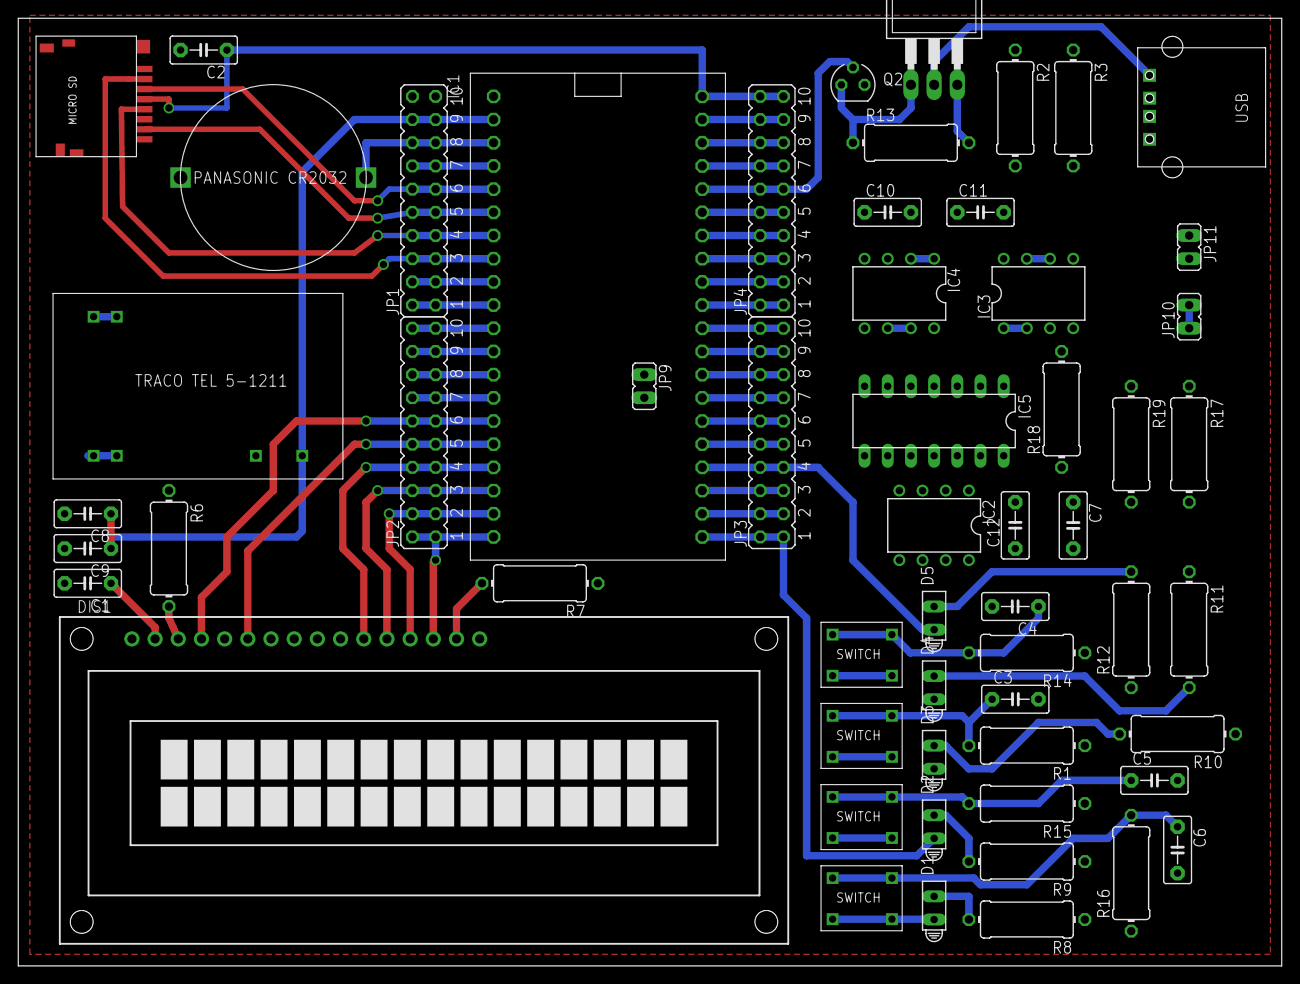
[picture p99: board 2013-2014/Hardware/Main Board/Main_Board_v1/Main_Board.brd from above]

Board: 2 copper layers, 138.4 x 103.8 mm, 57 parts (0 on the bottom side), 60 nets.
