equinoxorg/ekoHub/2013-2014/Hardware/I_SenseTest/TEST1.brd

## EAGLE design 2013-2014/Hardware/I_SenseTest/TEST1.brd (2015-01-14)

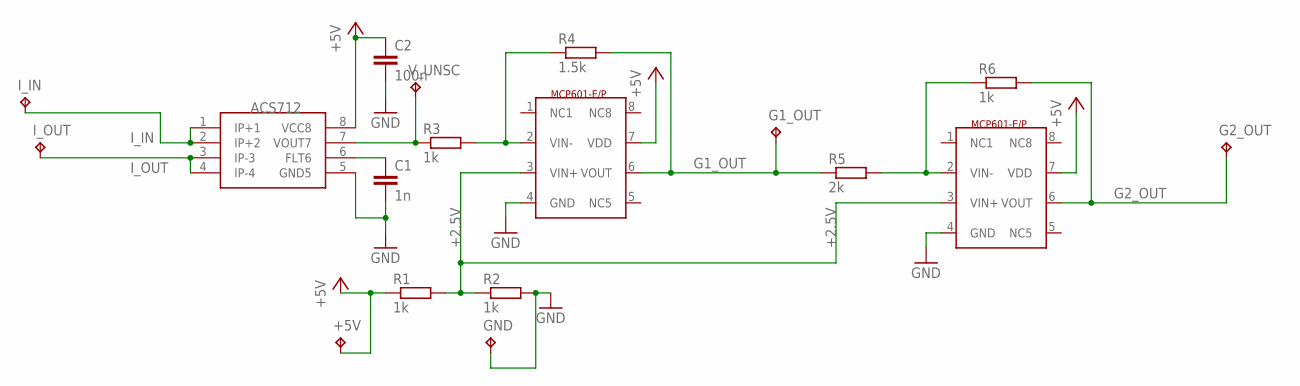
[picture p100: schematic TEST1.sch]

Parts:
+5V: TPPAD1-17Y; P1-17Y
C1: 1n; C050-050X075
C2: 100n; C050-050X075
G1_OUT, G2_OUT: TPPAD1-17Y; P1-17Y
GND: TPPAD1-17Y; P1-17Y
I_IN: TPPAD1-17Y; P1-17Y
I_OUT: TPPAD1-17Y; P1-17Y
R1, R2, R3, R6: 1k; 0309/12
R4: 1.5k; 0309/12
R5: 2k; 0309/12
U$1: ACS712; SOIC8
U$2, U$3: MCP601; PDIP8
V_UNSC: TPPAD1-17Y; P1-17Y

Connections:
+2.5V: R1.2, R2.1, U$2.3 (VIN+), U$3.3 (VIN+)
+5V: +5V.TP, C2.1, R1.1, U$1.8 (VCC8), U$2.7 (VDD), U$3.7 (VDD)
G1_OUT: G1_OUT.TP, R4.2, R5.1, U$2.6 (VOUT)
G2_OUT: G2_OUT.TP, R6.2, U$3.6 (VOUT)
GND: C1.2, C2.2, GND.TP, R2.2, U$1.5 (GND5), U$2.4 (GND), U$3.4 (GND)
I_IN: I_IN.TP, U$1.1 (IP+1), U$1.2 (IP+2)
I_OUT: I_OUT.TP, U$1.3 (IP-3), U$1.4 (IP-4)
unnamed: R3.1, U$1.7 (VOUT7), V_UNSC.TP
unnamed: R3.2, R4.1, U$2.2 (VIN-)
unnamed: R5.2, R6.1, U$3.2 (VIN-)
unnamed: C1.1, U$1.6 (FLT6)

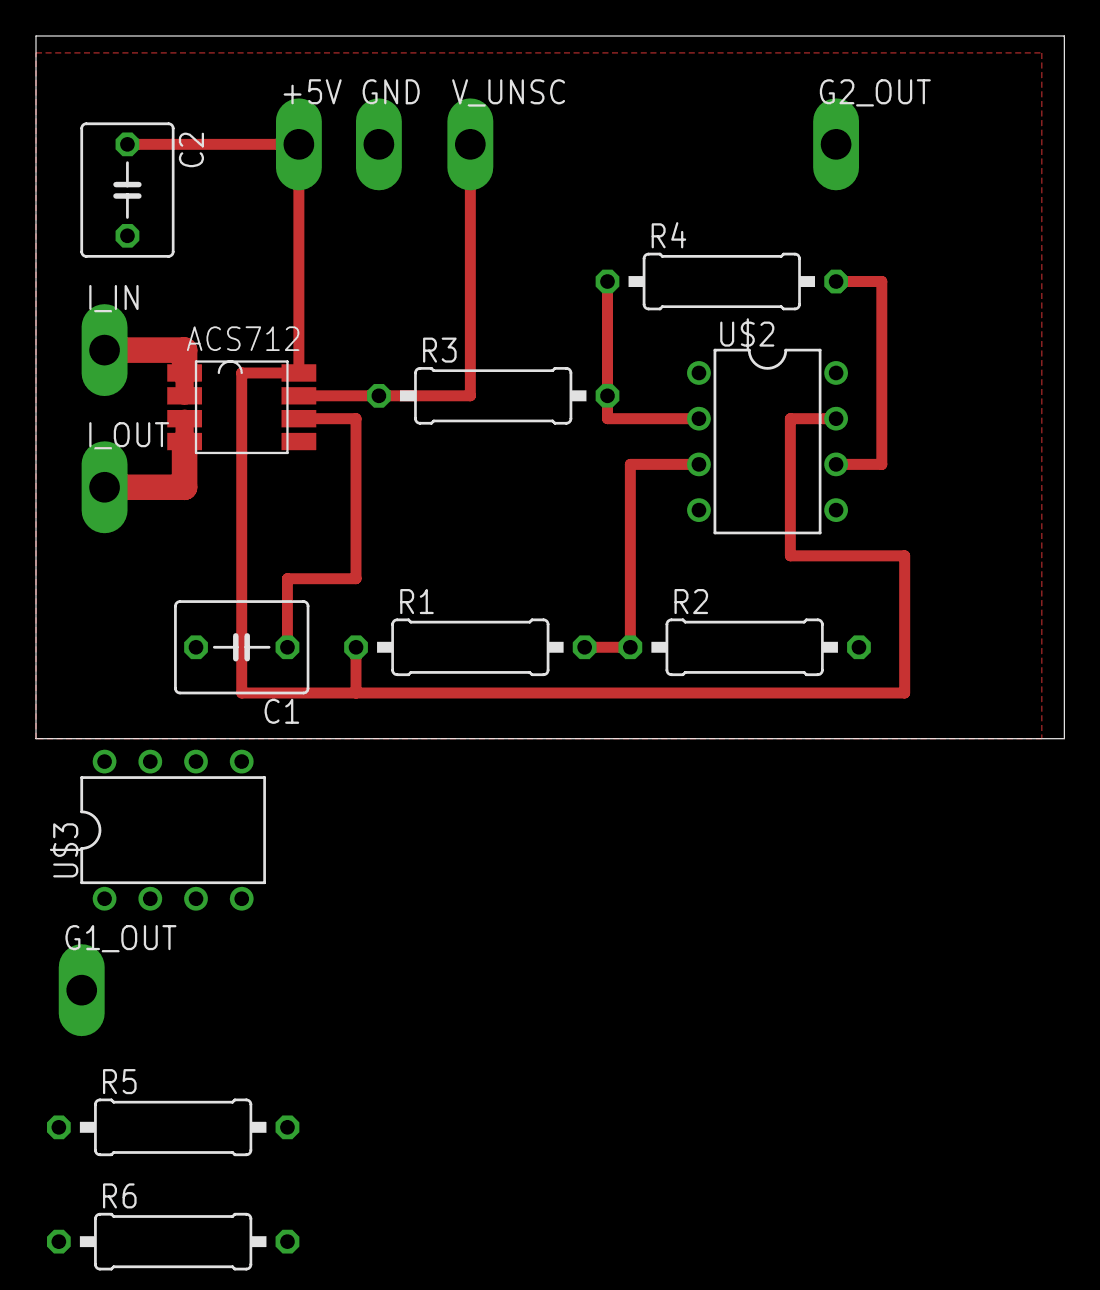
[picture p101: board TEST1.brd from above]

Board: 2 copper layers, 57.1 x 39.0 mm, 18 parts (0 on the bottom side), 11 nets.
