equinoxorg/ekoHub/2013-2014/Hardware/Main Board/Main_Board_v3/Main_Board.brd

## EAGLE design 2013-2014/Hardware/Main Board/Main_Board_v3/Main_Board.brd (2015-01-14)

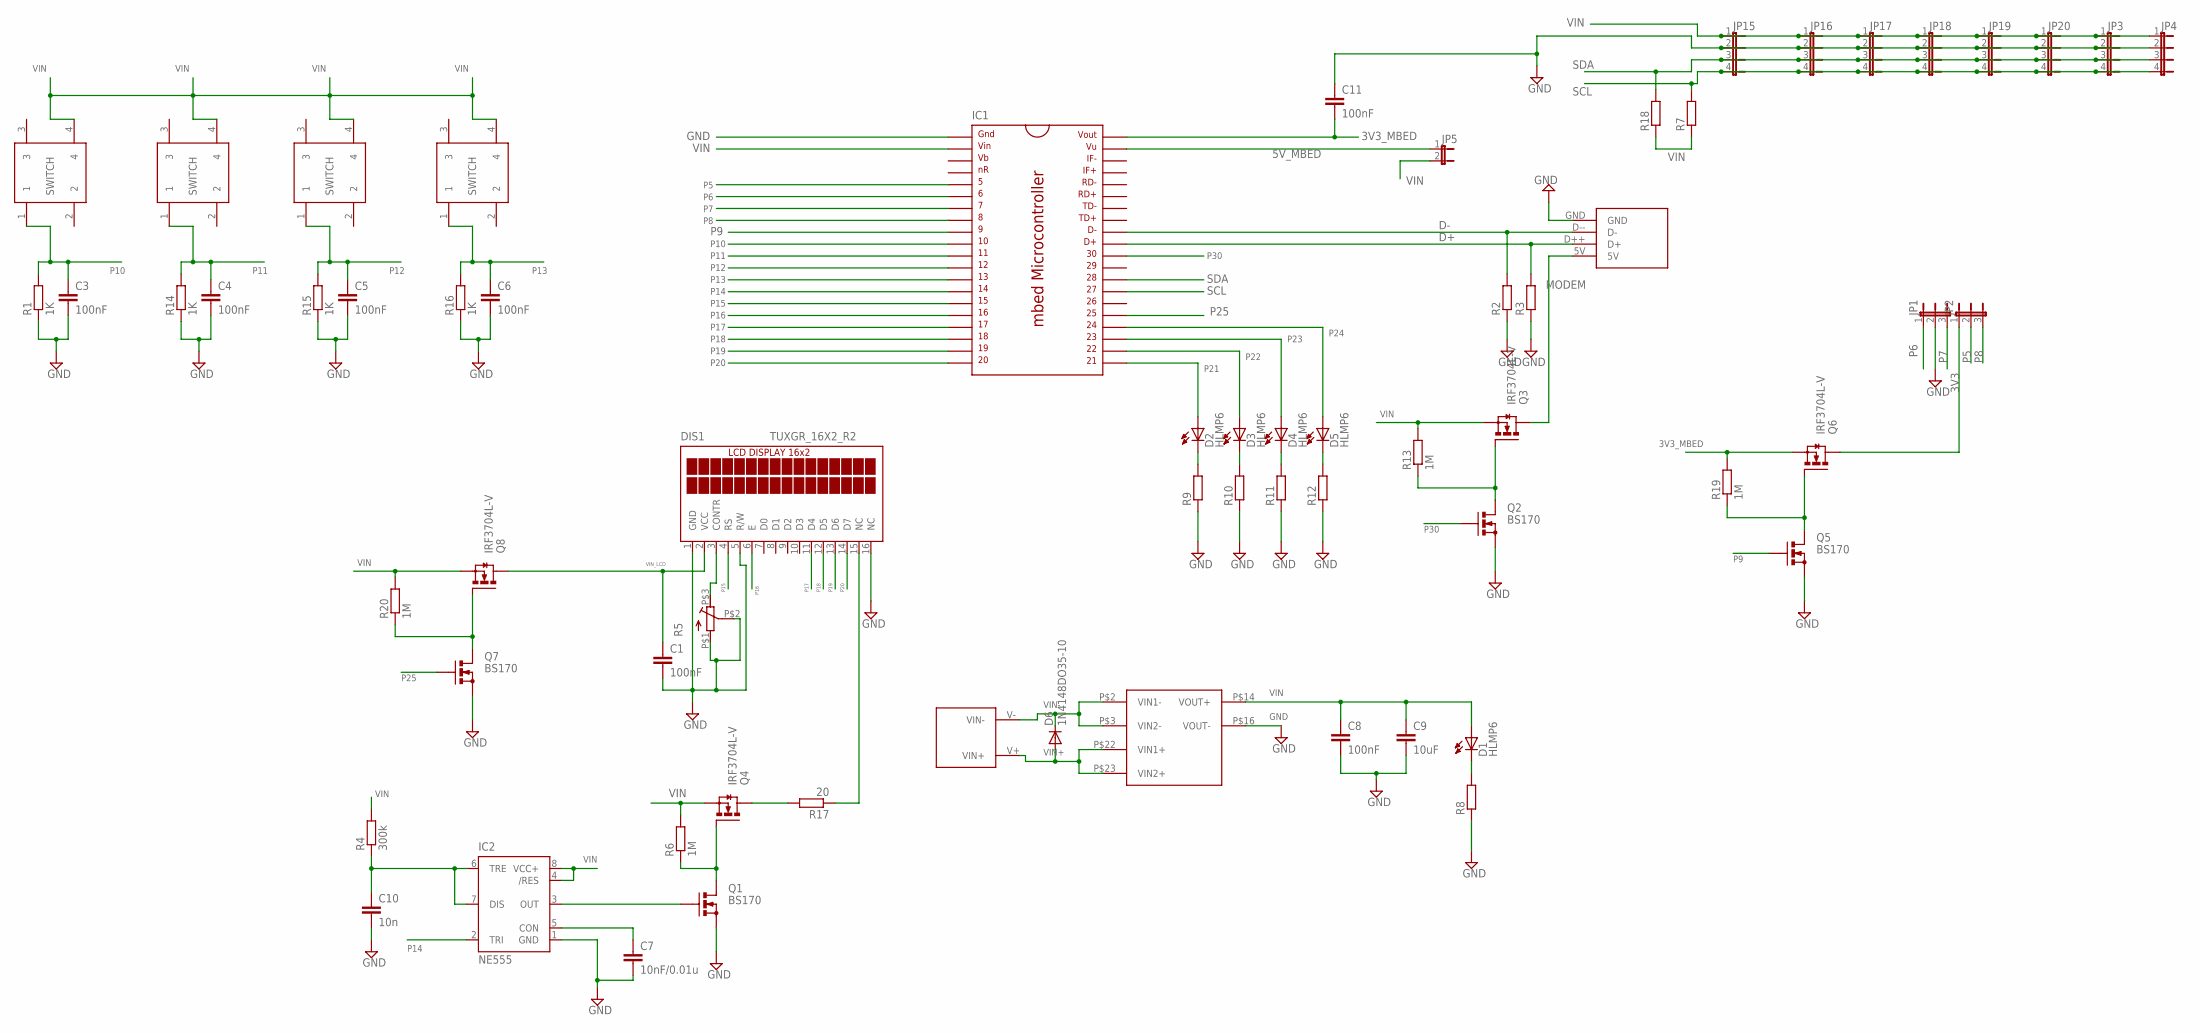
[picture p102: schematic Main_Board.sch]

Parts:
C1, C3, C4, C5, C6, C8, C11: 100nF; C5B3.5
C7: 10nF/0.01u; C5B3.5
C9: 10uF; C5B3.5
C10: 10n; C5B3.5
D1, D2, D3, D4, D5: HLMP6
D6: 1N4148DO35-10; DO35-10
DIS1: TUXGR_16X2_R2
IC1: MBED_MICROCONTROLLER; DIL40_0.9
IC2: NE555; DIL-08
JP1, JP2: JP2W
JP3, JP4, JP15, JP16, JP17, JP18, JP19, JP20: JP4E; JP4
JP5: JP1E; JP1
Q1, Q2, Q5, Q7: BS170; SOT54E
Q3, Q4, Q6, Q8: IRF3704L-V; TO262-V
R1, R14, R15, R16: 1K; 0411/12
R2, R3, R7, R8, R9, R10, R11, R12, R18: R-EU_0411/12; 0411/12
R4: 300k; 0411/12
R5: R-TRIMM; IRG2014TRIM
R6, R13, R19, R20: 1M; 0411/12
R17: 20; 0411/12
U$1: USBA_SOCKET
U$4: INPUT_VOLTAGE_CONNECTOR
U$5, U$6, U$7, U$8: TACT_SWITCH
U$9: TRACO_ISOLATED_SUPPLY

Connections:
3V3: JP2.1, Q6.2 (D)
3V3_MBED: C11.2, IC1.40, Q6.3 (S), R19.2
5V_MBED: IC1.39, JP5.1
D+: IC1.31, R3.2, U$1.D++ (D+)
D-: IC1.32, R2.2, U$1.D-- (D-)
GND: C1.2, C3.2, C4.2, C5.2, C6.2, C7.2, C8.2, C9.2, C10.2, C11.1, DIS1.1 (GND), DIS1.5 (R/W), DIS1.16 (NC), IC1.1, IC2.1 (GND), JP1.2, JP3.2, JP4.2, JP15.2, JP16.2, JP17.2, JP18.2, JP19.2, JP20.2, Q1.S, Q2.S, Q5.S, Q7.S, R1.1, R2.1, R3.1, R5.P$1 (A), R5.P$2 (S), R8.1, R9.1, R10.1, R11.1, R12.1, R14.1, R15.1, R16.1, U$1.GND, U$9.P$16 (VOUT-)
MODEM: Q3.2 (D), U$1.5V
unnamed: D1.K, R8.2
unnamed: C7.1, IC2.5 (CON)
unnamed: DIS1.3 (CONTR), R5.P$3 (E)
unnamed: D2.K, R9.2
unnamed: Q2.D, Q3.1 (G), R13.1
unnamed: C10.1, IC2.6 (TRE), IC2.7 (DIS), R4.1
unnamed: Q5.D, Q6.1 (G), R19.1
unnamed: Q1.D, Q4.1 (G), R6.1
unnamed: DIS1.15 (NC), R17.1
unnamed: Q7.D, Q8.1 (G), R20.1
unnamed: IC2.3 (OUT), Q1.G
unnamed: Q4.2 (D), R17.2
unnamed: D3.K, R10.2
unnamed: D4.K, R11.2
unnamed: D5.K, R12.2
P5: IC1.5, JP2.2
P6: IC1.6, JP1.1
P7: IC1.7, JP1.3
P8: IC1.8, JP2.3
P9: IC1.9, Q5.G
P10: C3.1, IC1.10, R1.2, U$5.1
P11: C4.1, IC1.11, R14.2, U$6.1
P12: C5.1, IC1.12, R15.2, U$7.1
P13: C6.1, IC1.13, R16.2, U$8.1
P14: IC1.14, IC2.2 (TRI)
P15: DIS1.4 (RS), IC1.15
P16: DIS1.6 (E), IC1.16
P17: DIS1.11 (D4), IC1.17
P18: DIS1.12 (D5), IC1.18
P19: DIS1.13 (D6), IC1.19
P20: DIS1.14 (D7), IC1.20
P21: D2.A, IC1.21
P22: D3.A, IC1.22
P23: D4.A, IC1.23
P24: D5.A, IC1.24
P25: IC1.25, Q7.G
P30: IC1.30, Q2.G
SCL: IC1.27, JP3.4, JP4.4, JP15.4, JP16.4, JP17.4, JP18.4, JP19.4, JP20.4, R7.2
SDA: IC1.28, JP3.3, JP4.3, JP15.3, JP16.3, JP17.3, JP18.3, JP19.3, JP20.3, R18.2
VIN: C8.1, C9.1, D1.A, IC1.2, IC2.4 (/RES), IC2.8 (VCC+), JP3.1, JP4.1, JP5.2, JP15.1, JP16.1, JP17.1, JP18.1, JP19.1, JP20.1, Q3.3 (S), Q4.3 (S), Q8.3 (S), R4.2, R6.2, R7.1, R13.2, R18.1, R20.2, U$5.4, U$6.4, U$7.4, U$8.4, U$9.P$14 (VOUT+)
VIN+: D6.A, U$4.V+ (VIN+), U$9.P$22 (VIN1+), U$9.P$23 (VIN2+)
VIN-: D6.C, U$4.V- (VIN-), U$9.P$2 (VIN1-), U$9.P$3 (VIN2-)
VIN_LCD: C1.1, DIS1.2 (VCC), Q8.2 (D)

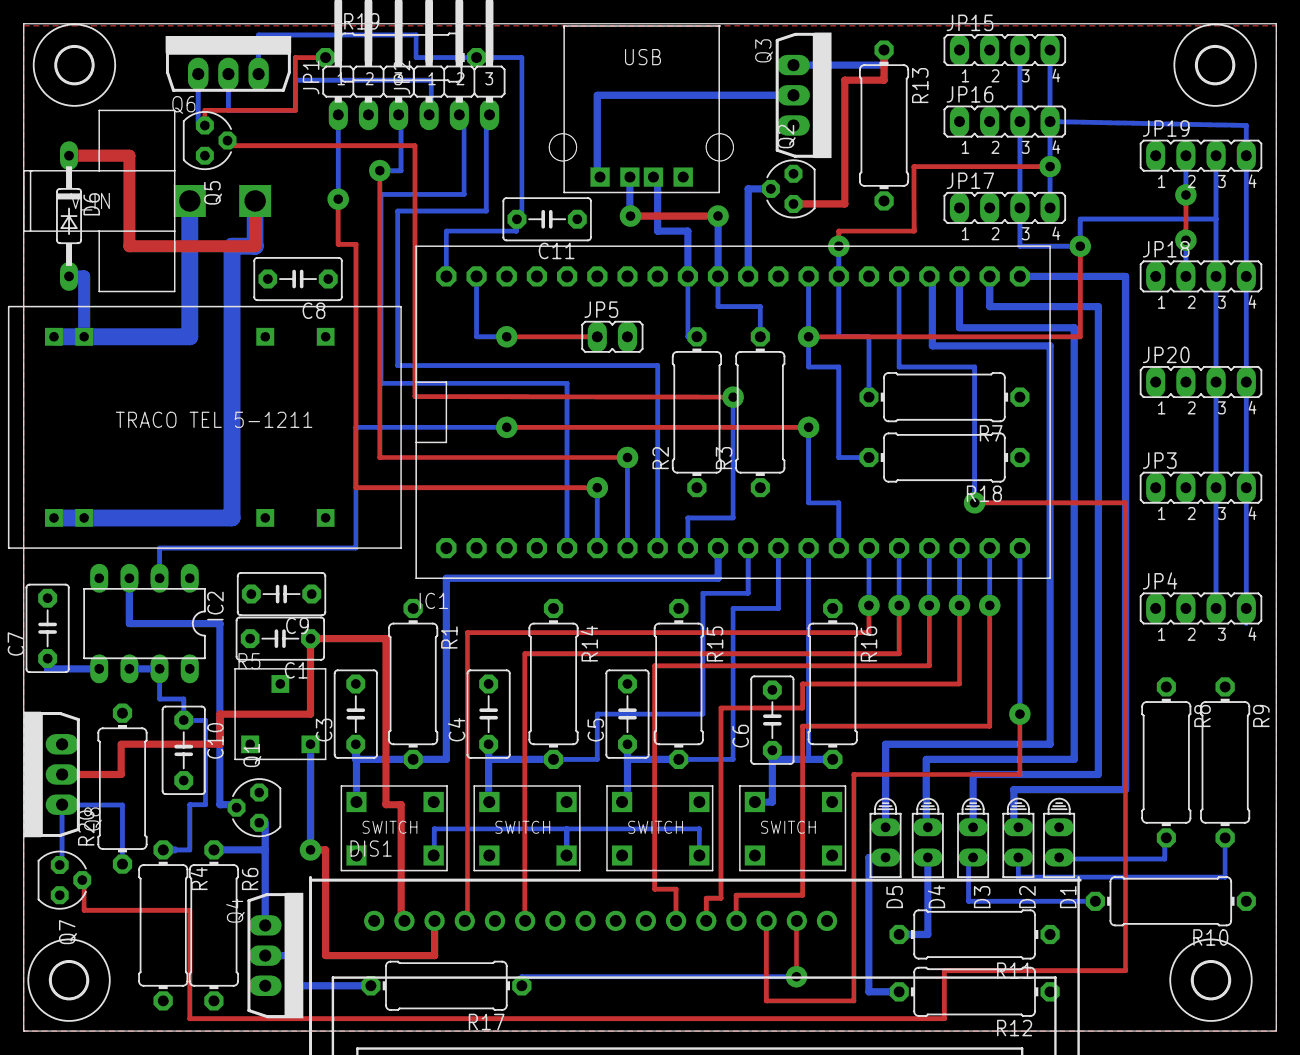
[picture p103: board 2013-2014/Hardware/Main Board/Main_Board_v3/Main_Board.brd from above]

Board: 2 copper layers, 105.4 x 84.8 mm, 69 parts (0 on the bottom side), 50 nets.

Other parts of the board:
U$10, U$11, U$12, U$13: 3,0
