equinoxorg/ekoHub/2013-2014/Hardware/Sensor Boards/DCCurrent/DCCurrentV1/DCCurrent.brd

## EAGLE design 2013-2014/Hardware/Sensor Boards/DCCurrent/DCCurrentV1/DCCurrent.brd (2015-01-14, an earlier design)

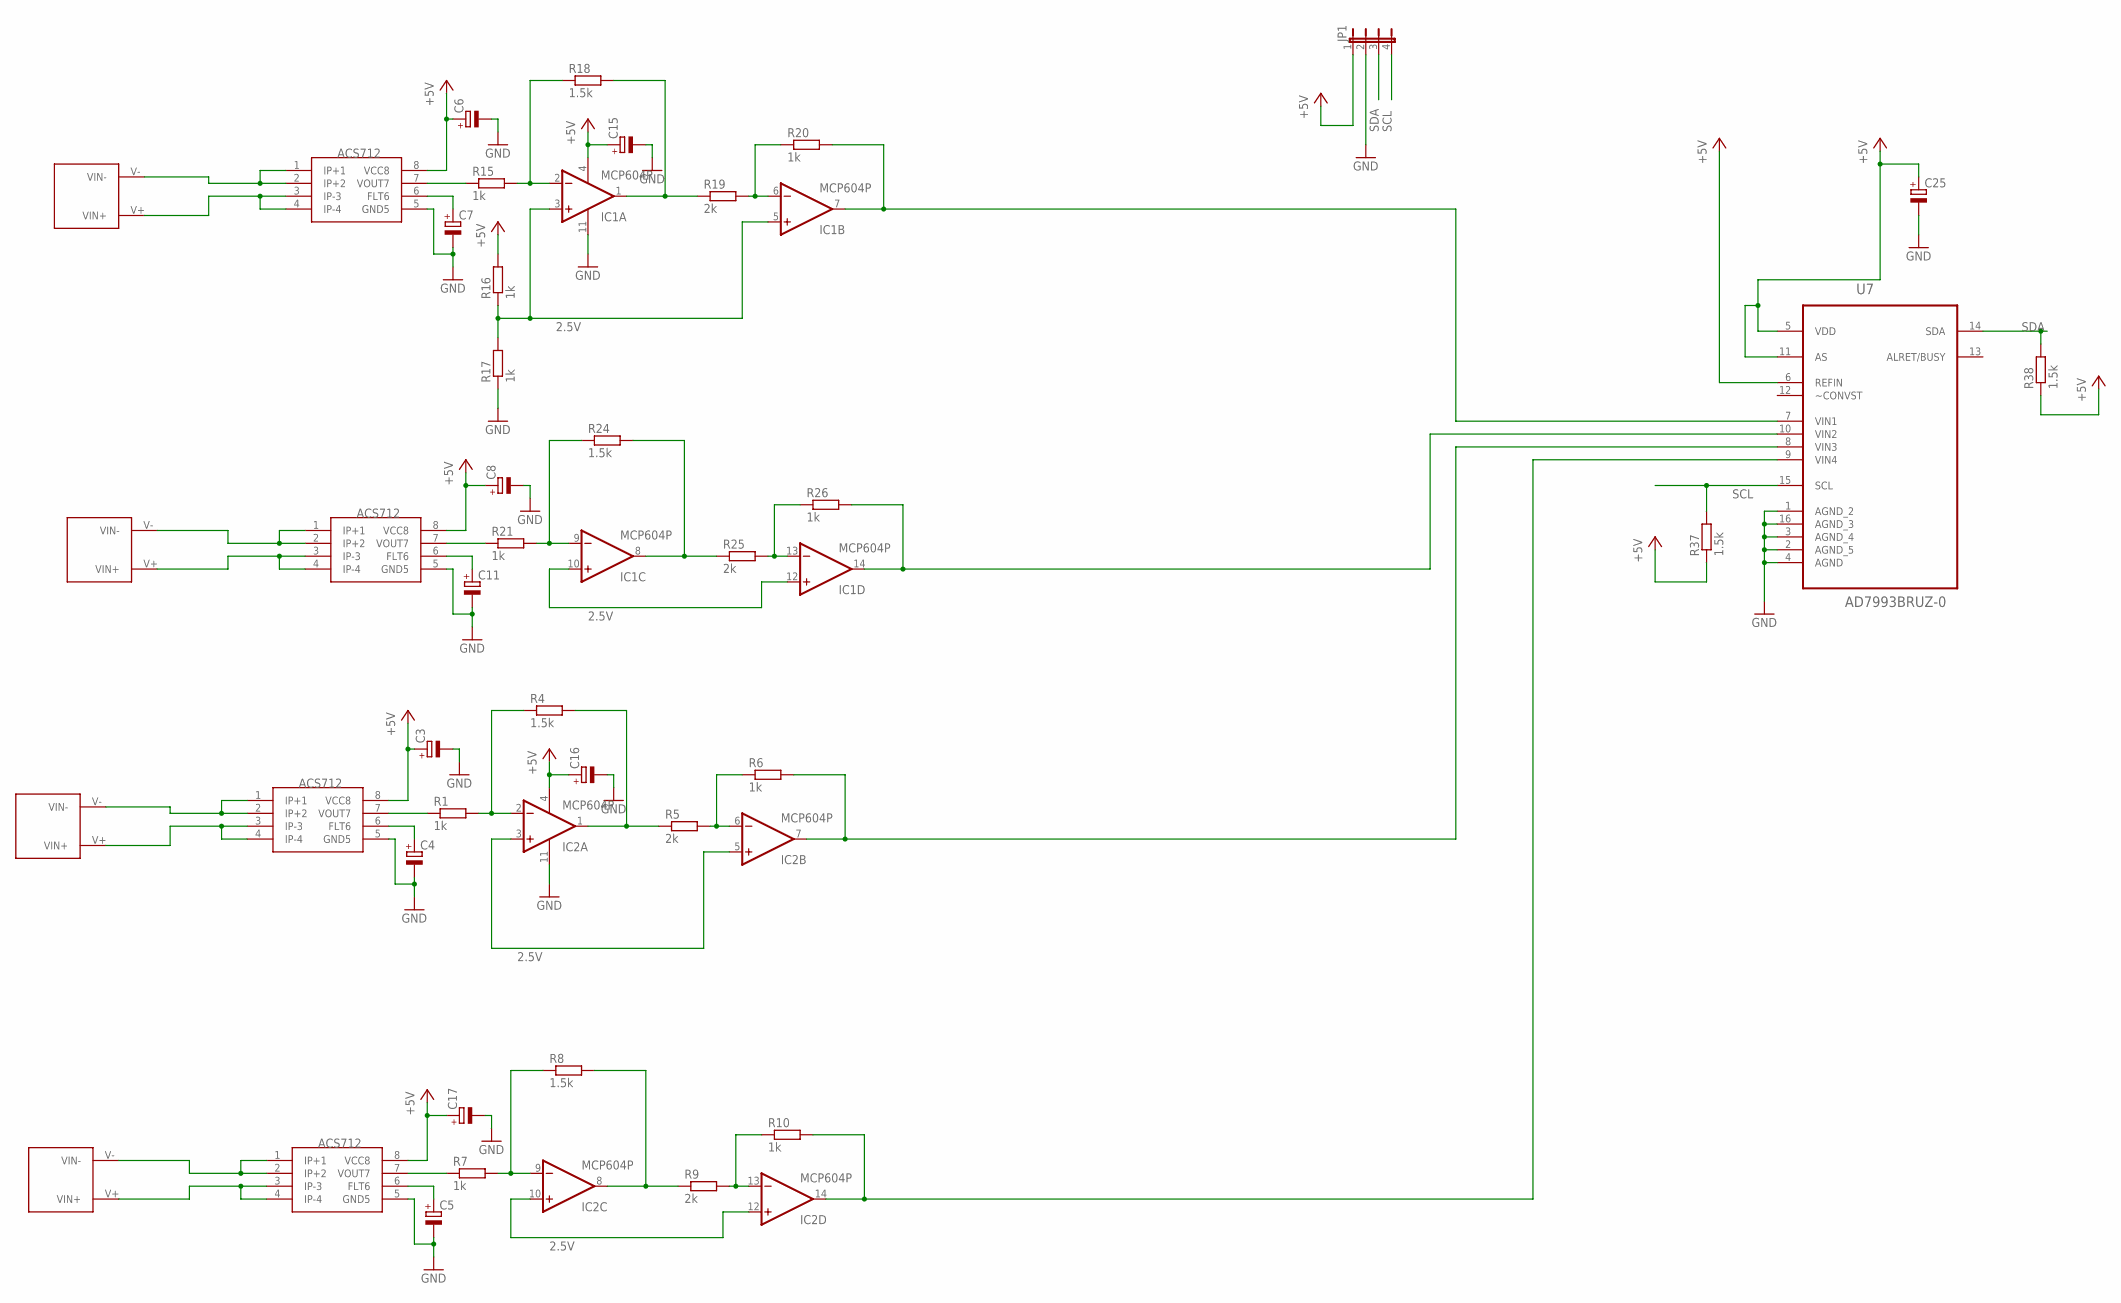
[picture p104: schematic DCCurrent.sch]

Parts:
C3, C4, C5, C6, C7, C8, C11, C15, C16, C17, C25: CPOL-EUE2-4; E2-4
IC1, IC2: MCP604P; DIL14
JP1: JP4E; JP4
R1, R6, R7, R10, R15, R16, R17, R20, R21, R26: 1k; 0309/12
R4, R8, R18, R24, R37, R38: 1.5k; 0309/12
R5, R9, R19, R25: 2k; 0309/12
U7: AD7993BRUZ-0; SOP65P640X120-16N
U$1, U$4, U$9, U$11: ACS712; SOIC8
U$2, U$3, U$5, U$6: INPUT_VOLTAGE_CONNECTOR

Connections:
2.5V: IC1.3 (+IN), IC1.5 (+IN), IC1.10 (+IN), IC1.12 (+IN), IC2.3 (+IN), IC2.5 (+IN), IC2.10 (+IN), IC2.12 (+IN), R16.1, R17.2
+5V: C3.+, C6.+, C8.+, C15.+, C16.+, C17.+, C25.+, IC1.4 (V+), IC2.4 (V+), JP1.1, R16.2, R37.1, R38.1, U7.5 (VDD), U7.6 (REFIN), U7.11 (AS), U$1.8 (VCC8), U$4.8 (VCC8), U$9.8 (VCC8), U$11.8 (VCC8)
GND: C3.-, C4.-, C5.-, C6.-, C7.-, C8.-, C11.-, C15.-, C16.-, C17.-, C25.-, IC1.11 (V-), IC2.11 (V-), JP1.2, R17.1, U7.1 (AGND_2), U7.2 (AGND_5), U7.3 (AGND_4), U7.4 (AGND), U7.16 (AGND_3), U$1.5 (GND5), U$4.5 (GND5), U$9.5 (GND5), U$11.5 (GND5)
unnamed: U$1.3 (IP-3), U$1.4 (IP-4), U$6.V+ (VIN+)
unnamed: U$1.1 (IP+1), U$1.2 (IP+2), U$6.V- (VIN-)
unnamed: R1.1, U$1.7 (VOUT7)
unnamed: IC2.2 (-IN), R1.2, R4.1
unnamed: C4.+, U$1.6 (FLT6)
unnamed: IC2.1 (OUT), R4.2, R5.1
unnamed: IC2.6 (-IN), R5.2, R6.1
unnamed: U$4.3 (IP-3), U$4.4 (IP-4), U$5.V+ (VIN+)
unnamed: U$4.1 (IP+1), U$4.2 (IP+2), U$5.V- (VIN-)
unnamed: R7.1, U$4.7 (VOUT7)
unnamed: IC2.9 (-IN), R7.2, R8.1
unnamed: C5.+, U$4.6 (FLT6)
unnamed: IC2.8 (OUT), R8.2, R9.1
unnamed: U$3.V+ (VIN+), U$9.3 (IP-3), U$9.4 (IP-4)
unnamed: IC2.13 (-IN), R9.2, R10.1
unnamed: U$3.V- (VIN-), U$9.1 (IP+1), U$9.2 (IP+2)
unnamed: R15.1, U$9.7 (VOUT7)
unnamed: IC1.2 (-IN), R15.2, R18.1
unnamed: C7.+, U$9.6 (FLT6)
unnamed: IC1.6 (-IN), R19.2, R20.1
unnamed: IC1.1 (OUT), R18.2, R19.1
unnamed: U$2.V+ (VIN+), U$11.3 (IP-3), U$11.4 (IP-4)
unnamed: U$2.V- (VIN-), U$11.1 (IP+1), U$11.2 (IP+2)
unnamed: R21.1, U$11.7 (VOUT7)
unnamed: IC1.9 (-IN), R21.2, R24.1
unnamed: C11.+, U$11.6 (FLT6)
unnamed: IC1.8 (OUT), R24.2, R25.1
unnamed: IC1.13 (-IN), R25.2, R26.1
SCL: JP1.4, R37.2, U7.15 (SCL)
SDA: JP1.3, R38.2, U7.14 (SDA)
VAC_OUT1: IC1.7 (OUT), R20.2, U7.7 (VIN1)
VAC_OUT2: IC1.14 (OUT), R26.2, U7.10 (VIN2)
VAC_OUT3: IC2.14 (OUT), R10.2, U7.9 (VIN4)
VAC_OUT4: IC2.7 (OUT), R6.2, U7.8 (VIN3)

Board: 2 copper layers, 47 parts (0 on the bottom side), 37 nets, no tracks yet.

Other parts of the board:
U$7, U$8, U$10, U$12: 3,0
