equinoxorg/ekoHub/(commit log)

2011-09-19 Added FileUpoad handler for uploads to blobstore. Fixes for date-time JSON serialisation in Python2.5. Minor cosmetic changes to CSS stylesheets.
    [main.py]
2012-07-23 clean up folder structure
    [ACBoard.brd, ACBoard.sch, ACBoard2.brd, ACBoard2.sch, Atmospheric.brd, Atmospheric.pcb, Atmospheric.sch, BusInterrupt.sch]
2012-07-23 clean up folder structure 2
    * Removed gerber files, PDFs and other outdated material
    * Reorganised LBR files to library folder
    * Organised board designs into three main categories
    [Barcode_Interface.brd, Barcode_Interface.sch, Panel EKO1.brd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]
2012-07-24 Added FTDI based isolated RS485 test device
    * New footprint for Pheonix Contact PTSM 4-way socket
    * Footrpints for MOLEX 47346-0001, TE1981584-1 and MC32594 USB sockets
    (Micro B, Micro AB and Stacked A respectively).
    * New schematic for FT232R based RS485 adaptor utilising HCPL2630-series
    opto-isolators.
    * Utilised Cliff Electronics 2.1mm SMT DC jack connector from
    minibox-parts.lbr. Check pinout on device before commiting to repo.
    * Consider addition of reverse battery protection to 5V/2 (iso) side.
    [ftdi_modbus_v2.sch]
2012-07-24 Created ftdi_modbus_v2 layout
    [ftdi_modbus_v2.brd, ftdi_modbus_v2.sch]
2012-07-25 Added DC Sensor v2 with updated libraries
    [dc_sensor_v2.sch]
2012-08-05 Completed layout of ftdi_rs485_v2 test board. Added more status LEDs
    [ftdi_modbus_v2.brd, ftdi_modbus_v2.sch]
2012-08-07 Created base for ekobb_r4 update.
    [baseboard.brd, baseboard.sch]
2012-08-07 Added xbee adaptor schematic from Dropbox folder.§
    [baseboard.brd, baseboard.sch, xbee-adapter.brd, xbee-adapter.sch]
2012-08-11 Added new PicKit 3 Apdapter board design
    [pickit3_adapter.brd, pickit3_adapter.sch]
2012-08-11 Line Termination Board - Initial Layout
    [lineterm.brd, lineterm.sch]
2012-08-15 Created initial schematic and layout for 5-level immersion water sensors.
    Basic theory of operation:
    1) mbed generates square wave at 1kHz frequency
    2) MCP602 opamp configured as schmitt trigger generates 10Vpp AC signal
    3) Terminal Connector 6 connected to deepest electrode
    4) On contact, other electrodes form conductive path for AC signal
    5) Opamp buffers source/sink current
    6) Output diodes rectify AC and output PD scales to 3.3V
    7) mbed measures signal to verify presence
    TODO:
    Add battery measurement, temp sensor
    Add resistors to ground on opamp inputs to bias cct on open circuit
    [waterlevel.brd, waterlevel.sch]
2012-08-16 Completed layout of water level sensor.
    Check circuit
    Add status LEDs
    Add bias resistors to GND
    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
    [waterlevel.brd, waterlevel.sch]
2012-08-16 Added LEDs and Bias Resistors to water sensor
    [waterlevel.brd, waterlevel.sch]
2012-08-16 Completed water level sensor / wireless network board.
    Added status LEDs
    Added test points for critical signals
    Added M3 mounting holes
    [waterlevel.brd, waterlevel.sch]
2012-08-16 [WSensor] Fixed bug with unconnected opamp input. Fixed component values.
    [waterlevel.brd, waterlevel.sch]
2012-08-16 Minor modifications to PicKit 3 adaptor
    [pickit3_adapter.brd]
2012-08-16 Updated DC voltage sensor to rev 2
    [dc_sensor_v2.brd, dc_sensor_v2.sch]
2012-08-16 Resized pickit adaptor to fit into 5x5 pcb
    [pickit3_adapter.brd]
2012-08-16 Misc DRC fixes
    [ftdi_modbus_v2.brd, lineterm.brd, pickit3_adapter.brd]
2012-08-17 Updated with fusion order number
    [dc_sensor_v2.brd, ftdi_modbus_v2.brd, pickit3_adapter.brd, waterlevel.brd]
2012-08-31 Modified code to be more configurable at boot via command line.
    Adopted to utilise PyCrypto 2.3+, RSA.importKey()
    Modified to use context dict passed from main.py
    Stripped all hardware dependant code for later incorporation with board_config hooks.
2012-08-31 Updated sensor dispatch code to accept global context dict. Unittests added for web sync code.
    [ac.setup.cfg, ac1.cfg, ac2.cfg, ac2.setup.cfg, ac_sensor.cfg, ac_setup.cfg, atmos.cfg, atmos.setup.cfg]
2012-08-31 Fixed failure with upload_file()
    [eko_logger.py]
2012-08-31 Fixed issue with renamed log files and bitrot in configtool.py
    [configtool.py]
2012-09-01 Added new configuration tool for R2/R3 network boards
2012-09-01 Added README.md. Fixed typo in main.c.
    [main.c]
2012-09-06 Updated setup scripts, configtool and pppd_scriptgen
    [ac.setup.cfg, ac1.cfg, ac2.cfg, ac2.setup.cfg, atmos.cfg, atmos.setup.cfg, battery1.cfg, battery1.setup.cfg]
2012-09-07 Updated default config file sample
    [ac_sensor.cfg, ac_setup.cfg, atmos.cfg, atmos.setup.cfg, sensor.default.cfg]
2013-09-21 First Commit
    All Files on the datalogging dropbox uploaded to GIthub
    [ACBoard.brd, ACBoard.sch, ADC.brd, ADC.sch, Current.brd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]
2013-10-18 Reorganized the entire Folder
    [ACBoard.brd, ACBoard.sch, ADC.brd, ADC.sch, Current.brd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]
2013-10-18 Made changes to the PCB Folders
    [ACBoard.brd, ACBoard.sch, VDC.brd, VDC.sch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]
2014-01-05 Sensor Testing and PCB Designs
    Added sensor testing data and PCB designs for AC voltage and Current
    sensor
    [ACVoltage.sch, Component Values.xlsx, Datalogging_SMD_Prototye.brd, Datalogging_SMD_Prototye.sch, TEST1.brd, TEST1.sch, current sensor readings.xlsx, mainBoard.brd]
2014-01-20 First Draft of Main Board
    1. Added most of the main board parts in the schematic.
    2. Board layout needs work. the backlight timing circuit needs to be
    tested.
    3. Part sizes need to be double checked.
    4. Need to add molex connectors for Input, I2C Bus, and Power Bus
    5. Double check decoupling capacitors
    6. Ensure Soldering is on the bottom side
    7. Change LCD Part pin locations according to actual device. At the
    moment, I have just used a pre-made part that has 16 pins @ 2.54mm pitch
    spacing but the 16 pins need to be at the right location.
    8. Keep in mind that the PCB will be mounted onto a face plate so needs
    consideration on the side that the components are mounted on since the
    height of ea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
    [Main_Board.brd]
2014-01-27 Main Board Work in Progress
    Work in Progress on the main board.
    Need to test the timing circuit and then finalize and finish routing the
    board.
    [Main_Board.brd, Main_Board.sch]
2014-01-30 Added Component Values for the AC Voltage sensor
    [ACVoltage.sch, Component Values.xlsx, Main_Board.brd, Main_Board.sch]
2014-02-01 Updated the Main Board
    Main Board is Fully Done. need to Test the timing circuit before sending
    the design for manufacture
    [Component Values.xlsx, Main_Board.brd, Main_Board.sch, TEST1.brd, TEST1.sch]
2014-02-02 Main Board Ready for In-House Manufacture
    [Main_Board.brd, Main_Board.sch]
2014-02-05 Added Gerber Files for Main Board
    [Main_Board.brd, Main_Board.sch]
2014-03-01 Changed the TRACO Part and USB clearance fix
    [Main_Board.brd, Main_Board.sch]
2014-04-22 Changed mounting holes and SD card Power pin
    1. The mounting holes locations have been changed slightly so that they
    are to the nearest mm
    2. The SD card can be power gated using pin 9.
    [Main_Board.brd, Main_Board.sch, SDCardv1.brd, SDCardv1.sch]
2014-04-22 Added power control of the LCD screen
    [Main_Board.brd, Main_Board.sch]
2014-04-24 Added Reverse Polarity Protection
    [ACBoard.brd, ACBoard.sch, DCCurrent.brd, DCCurrent.sch, Datalogging Finances.xlsx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]
2014-04-26 Board Layouts done for DC Current and AC Board
    [DCCurrent.brd, Main_Board.brd]
2014-05-05 Added box model
    [BoxDesign.skp, DCCurrent.brd, Inventory.xlsx]
2014-05-05 DC Voltage Sensor board added
    [VDC.brd, VDC.sch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]
2014-05-08 First components order by David
    [Datalogging Finances.xlsx]
2014-05-10 DC Current Board - Done by Saurab
    [DCCurrent.brd, DCCurrent.sch, Datalogging Finances.xlsx, VDC.brd, VDC.sch]
2014-05-21 v1.0, AC sinewave algorithm
    [Datalogging Finances.xlsx]
2014-05-21 Final Version: RMS voltage calculation working
2014-05-25 merged web app
    [logMinazi.csv, readingsMinazi.csv]
2014-05-25 updated finance sheet
    [Datalogging Finances.xlsx]
2014-06-09 Added graph selection panel and login button
2014-06-10 implemented user service, login/logout button work perfectly
2014-07-20 can query start and end dates and display them in correct format on the webpage.
    [main.py]
2014-09-14 implemented parser of json string received from the mbed and the values are saved to datastore
    [logMinazi.csv, readingsMinazi.csv]
2014-09-18 Graphs are now being plotted against the actual timestamps of the sensor values not tdate.
2014-09-19 Changed the remote settings form. Added hour and minutes selectors for the time parameters. Data is saved correctly
    [remote configuration variables.txt]
2015-02-18 moved arduino code to Software 14-15
2015-02-19 Tested i2c master/slave on two arduinos
2015-02-25 Tried to connect to GSM with Gallo's SIM Card but PIN got blocked
